alexquilty/SmartSpin2k/Hardware/Case Integrated PCB/README.md

Currently the experimental hardware for use with the upcoming PCB.
