alexquilty/SmartSpin2k/Hardware/PCB/README.md

PCB files. 

You'll only need these files if you want to customize the PCB or fab it someplace other than pcbway. 

To order directly from PCBway use this link : https://www.pcbway.com/project/shareproject/SmartSpin2k_PCB.html
