alexquilty/SmartSpin2k/Hardware/Case Version2/PrusaSlicer.png

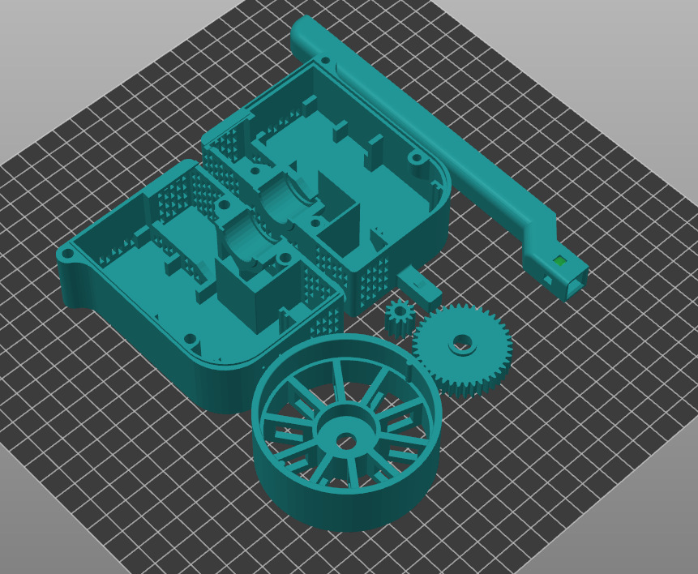
Hardware/Case Version2/PrusaSlicer.png
