alexquilty/SmartSpin2k/Hardware/Inserts/Design_Reference_Photos/BH_Fitness/BH-Fitness_Side_View.jpg

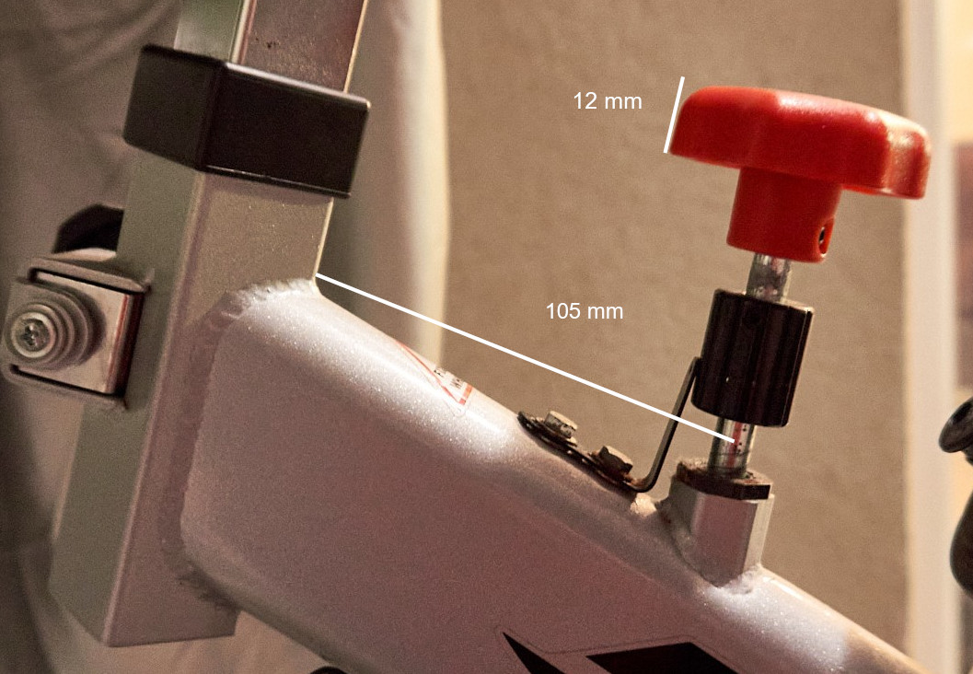
Hardware/Inserts/Design_Reference_Photos/BH_Fitness/BH-Fitness_Side_View.jpg
