alexquilty/SmartSpin2k/Hardware/Inserts/Design_Reference_Photos/BH_Fitness/BH-Fitness_Top_View.jpg

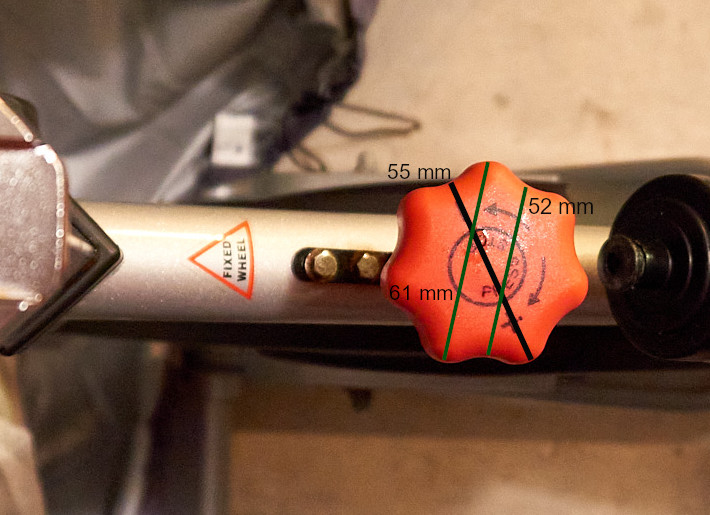
Hardware/Inserts/Design_Reference_Photos/BH_Fitness/BH-Fitness_Top_View.jpg
