alexquilty/SmartSpin2k/Hardware/Inserts/Design_Reference_Photos/Body_Bike/Side_3.jpg

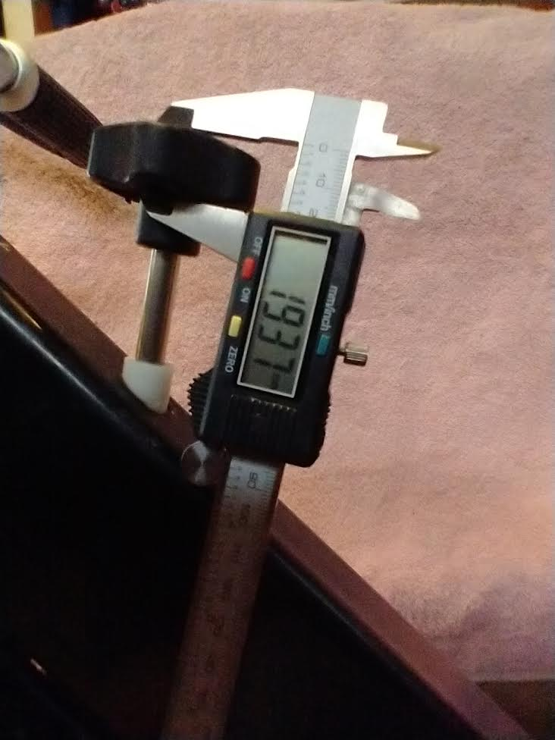
Hardware/Inserts/Design_Reference_Photos/Body_Bike/Side_3.jpg
