alexquilty/SmartSpin2k/Hardware/Inserts/Design_Reference_Photos/Body_Bike/Top.jpg

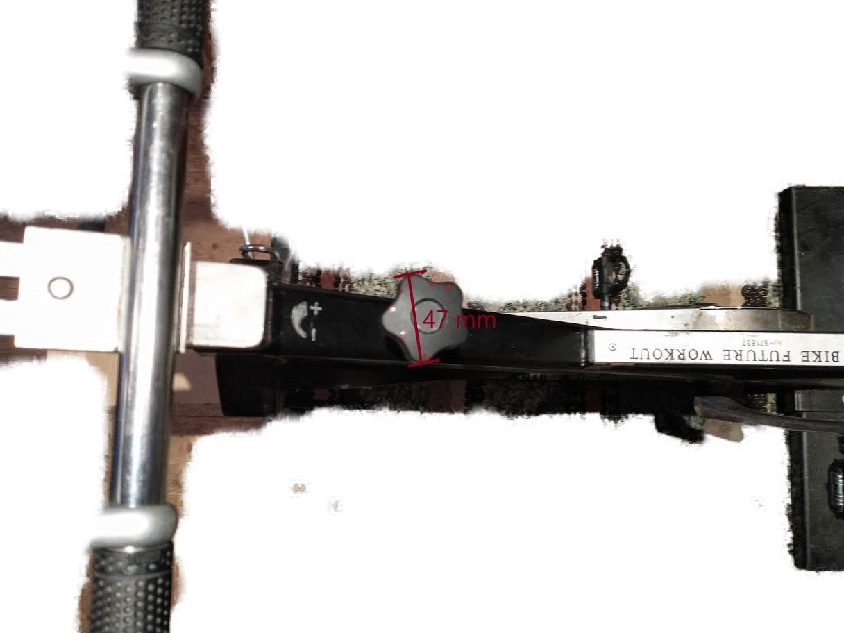
Hardware/Inserts/Design_Reference_Photos/Body_Bike/Top.jpg
