alexquilty/SmartSpin2k/Hardware/Inserts/Design_Reference_Photos/Body_Bike/Top_2.jpg

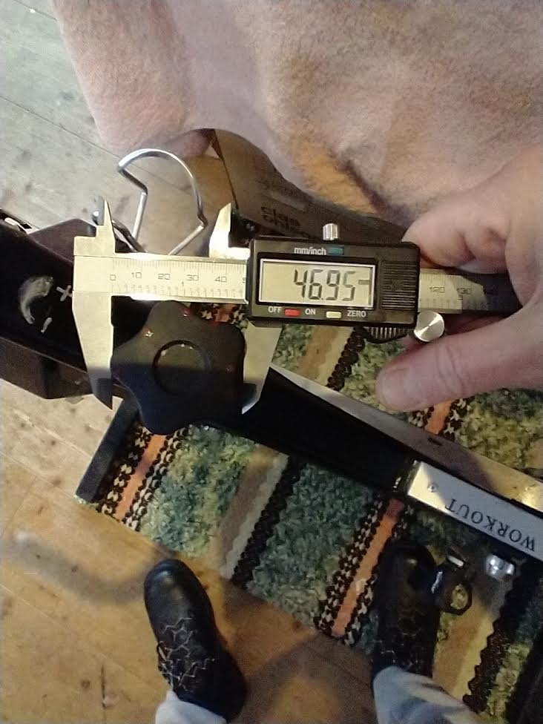
Hardware/Inserts/Design_Reference_Photos/Body_Bike/Top_2.jpg
