alexquilty/SmartSpin2k/Hardware/Inserts/Design_Reference_Photos/Diadora/head_tube.jpg

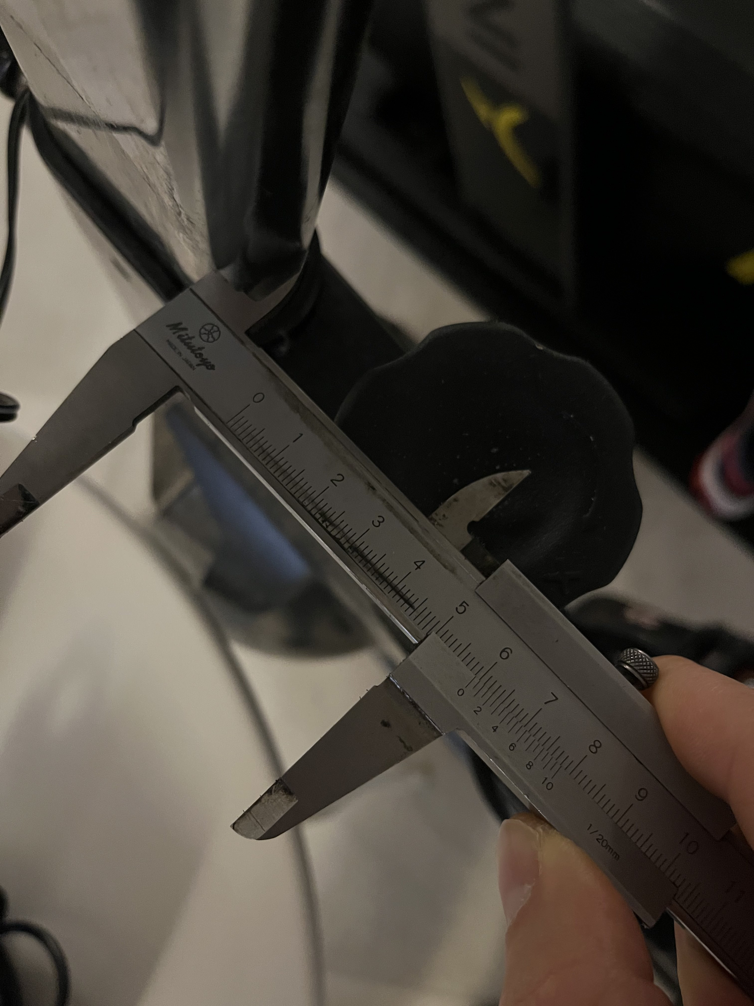
Hardware/Inserts/Design_Reference_Photos/Diadora/head_tube.jpg
