alexquilty/SmartSpin2k/Hardware/Inserts/Design_Reference_Photos/Diadora/Side.jpg

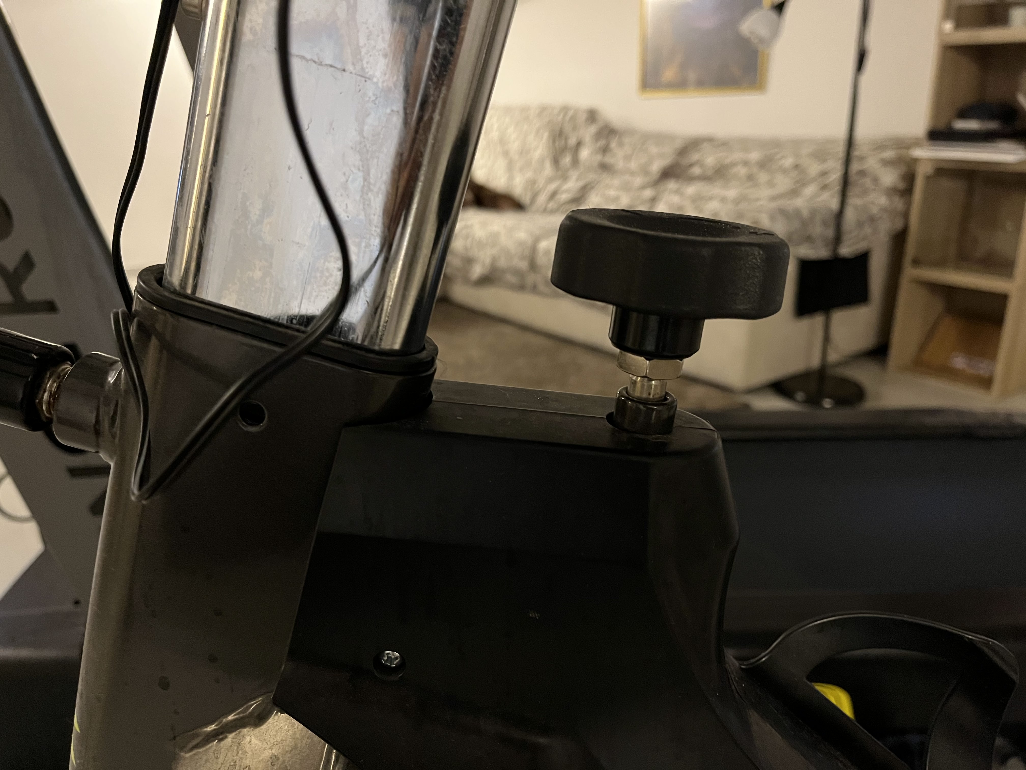
Hardware/Inserts/Design_Reference_Photos/Diadora/Side.jpg
