alexquilty/SmartSpin2k/Hardware/Inserts/Design_Reference_Photos/Diadora/Smallest.jpg

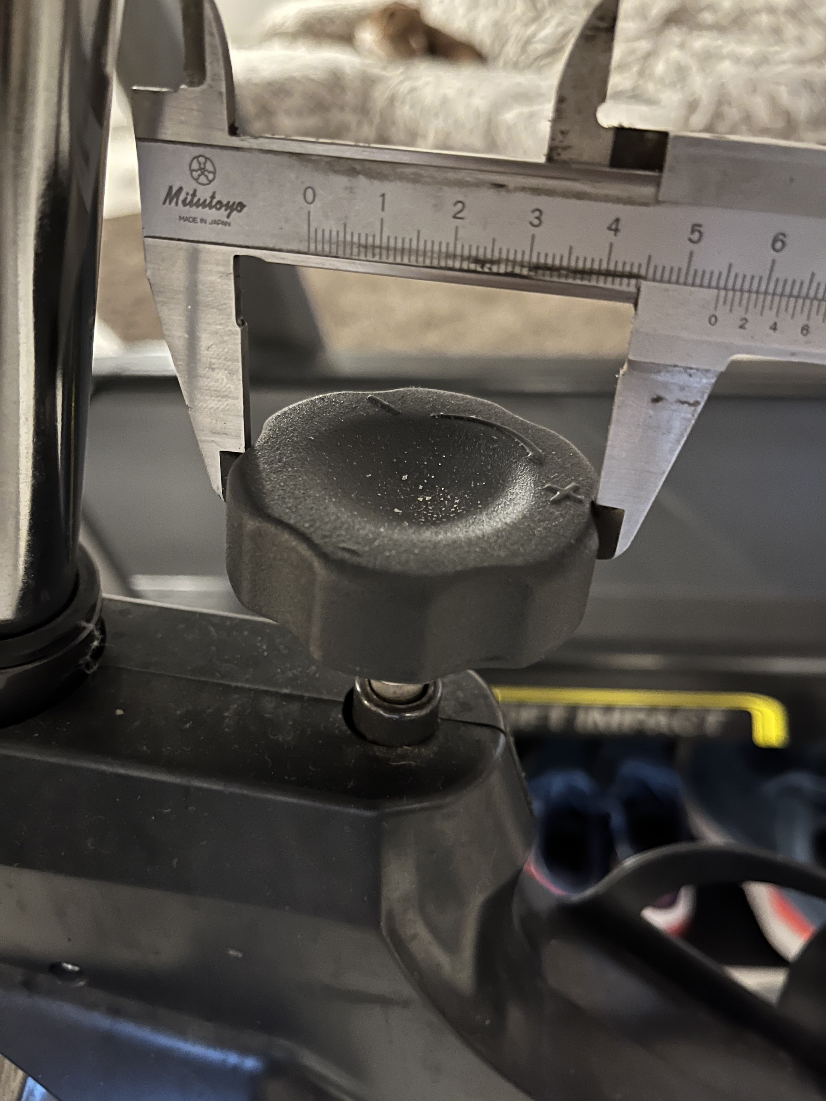
Hardware/Inserts/Design_Reference_Photos/Diadora/Smallest.jpg
