alexquilty/SmartSpin2k/Hardware/Inserts/Design_Reference_Photos/Diadora/Top.jpg

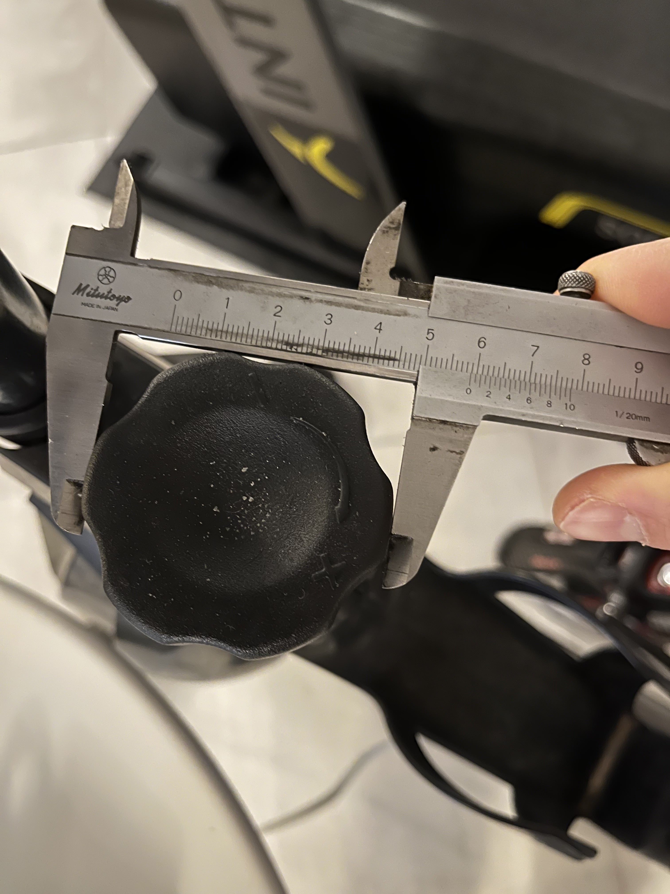
Hardware/Inserts/Design_Reference_Photos/Diadora/Top.jpg
