alexquilty/SmartSpin2k/Hardware/Inserts/Design_Reference_Photos/Echelon/Side1.jpg

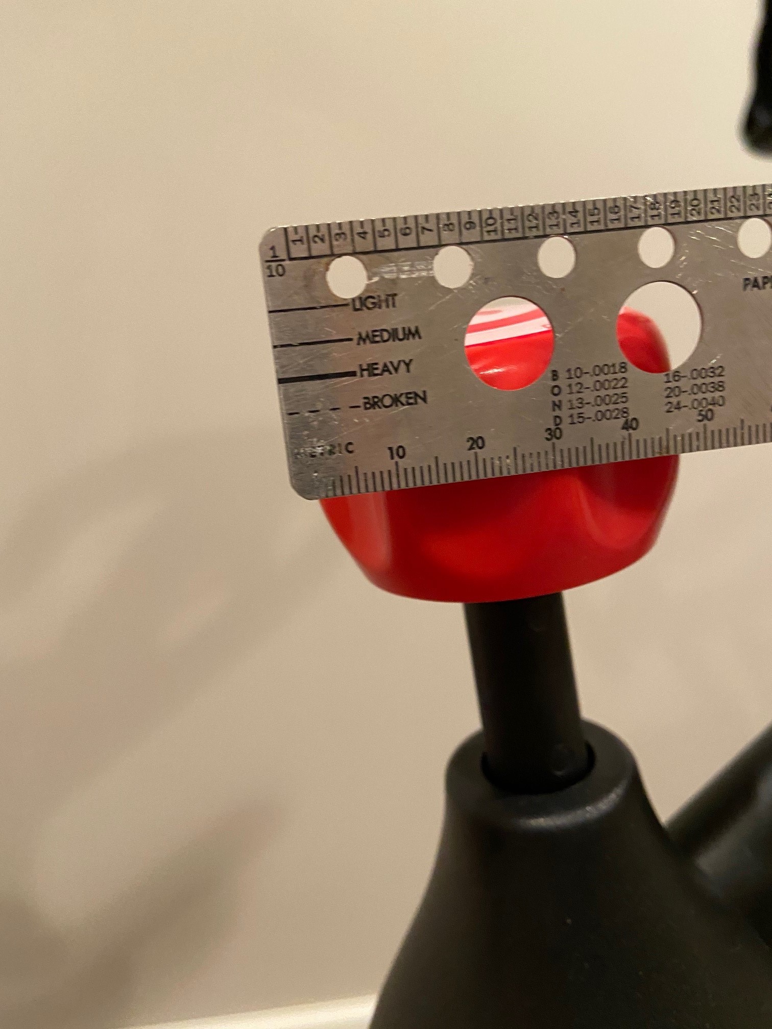
Hardware/Inserts/Design_Reference_Photos/Echelon/Side1.jpg
