alexquilty/SmartSpin2k/Hardware/Inserts/Design_Reference_Photos/Echelon/Side2.jpg

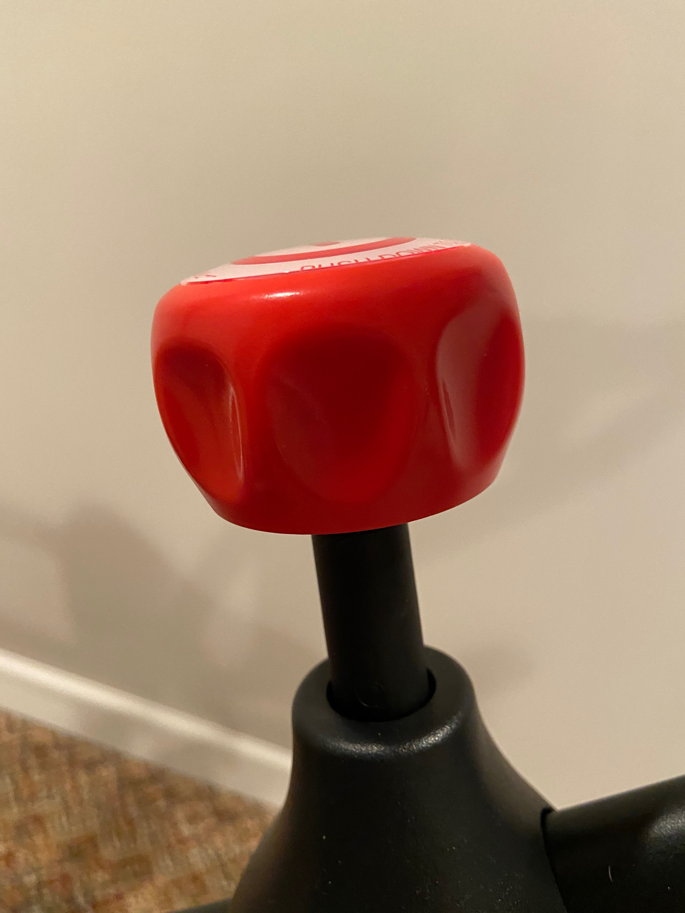
Hardware/Inserts/Design_Reference_Photos/Echelon/Side2.jpg
