alexquilty/SmartSpin2k/Hardware/Inserts/Design_Reference_Photos/Echelon/side3.jpg

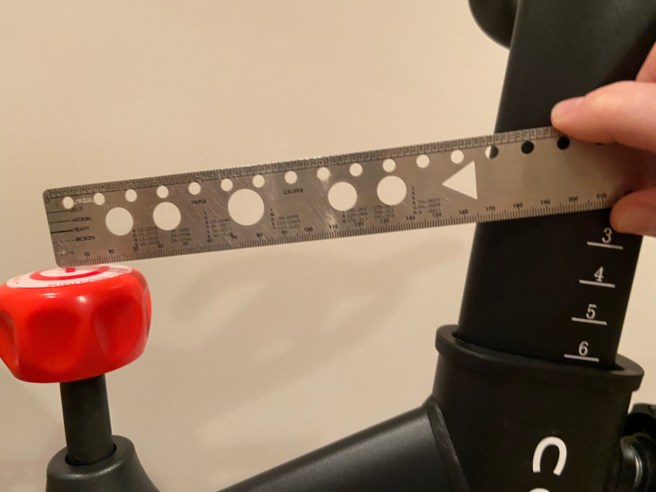
Hardware/Inserts/Design_Reference_Photos/Echelon/side3.jpg
