alexquilty/SmartSpin2k/Hardware/Inserts/Design_Reference_Photos/Echelon/side4.jpg

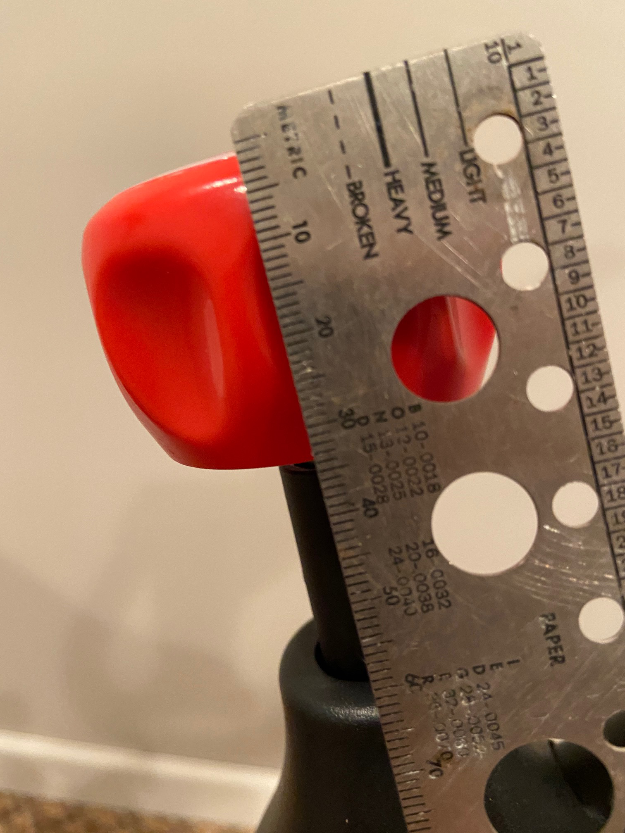
Hardware/Inserts/Design_Reference_Photos/Echelon/side4.jpg
