alexquilty/SmartSpin2k/Hardware/Inserts/Design_Reference_Photos/Echelon/top1.jpg

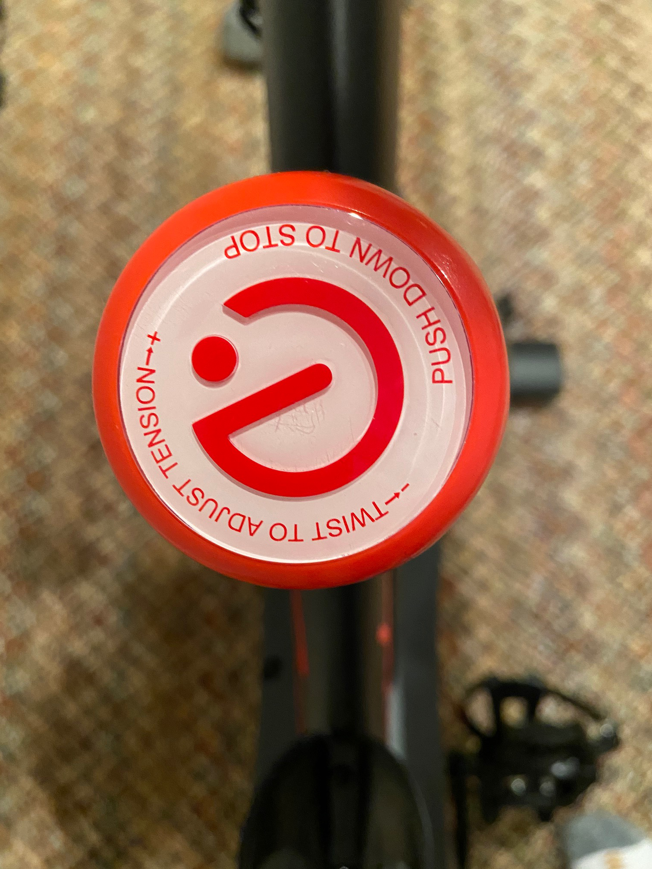
Hardware/Inserts/Design_Reference_Photos/Echelon/top1.jpg
