alexquilty/SmartSpin2k/Hardware/Inserts/Design_Reference_Photos/Echelon/top2.jpg

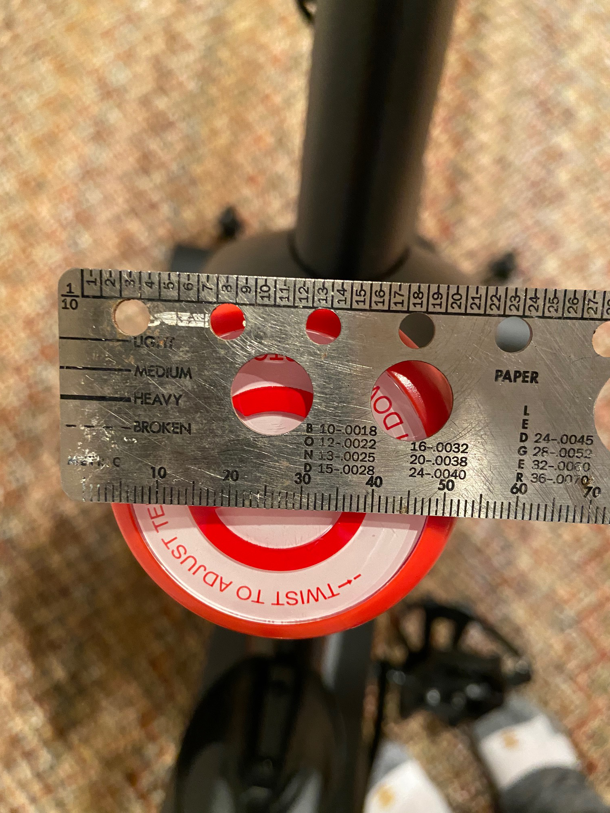
Hardware/Inserts/Design_Reference_Photos/Echelon/top2.jpg
