alexquilty/SmartSpin2k/Hardware/Inserts/Design_Reference_Photos/Flywheel/IMG_4019.JPG

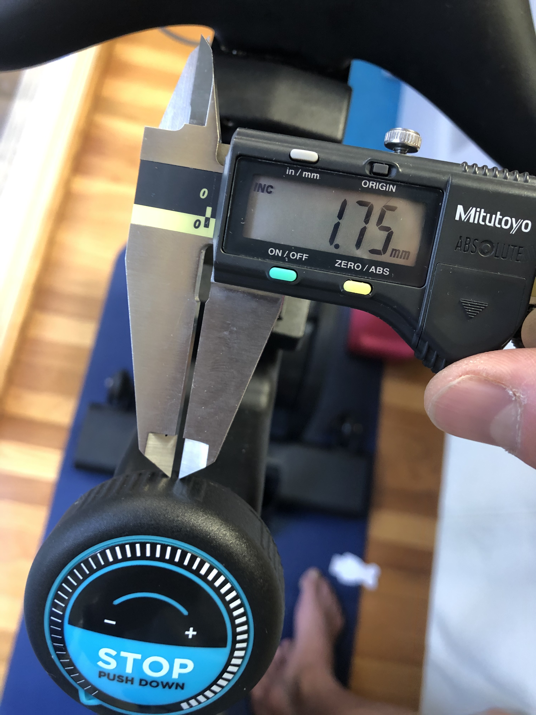
Hardware/Inserts/Design_Reference_Photos/Flywheel/IMG_4019.JPG
