alexquilty/SmartSpin2k/Hardware/Inserts/Design_Reference_Photos/Flywheel/IMG_4024.JPG

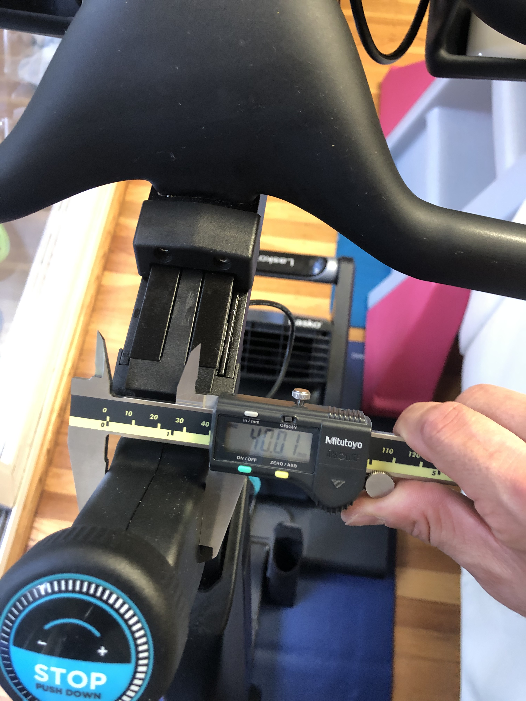
Hardware/Inserts/Design_Reference_Photos/Flywheel/IMG_4024.JPG
