alexquilty/SmartSpin2k/Hardware/Inserts/Design_Reference_Photos/Flywheel/IMG_4025.JPG

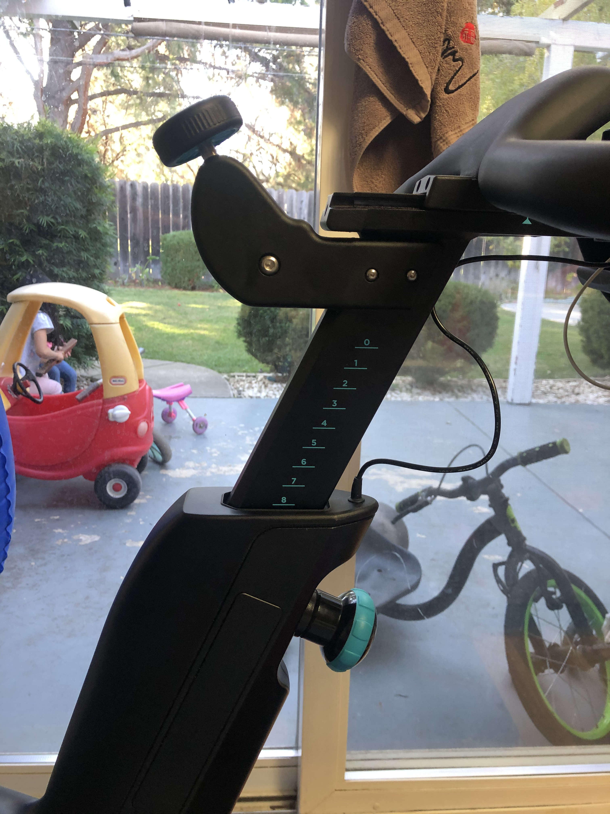
Hardware/Inserts/Design_Reference_Photos/Flywheel/IMG_4025.JPG
