alexquilty/SmartSpin2k/Hardware/Inserts/Design_Reference_Photos/Golds_Gym/Golds-Gym_all_views.jpg

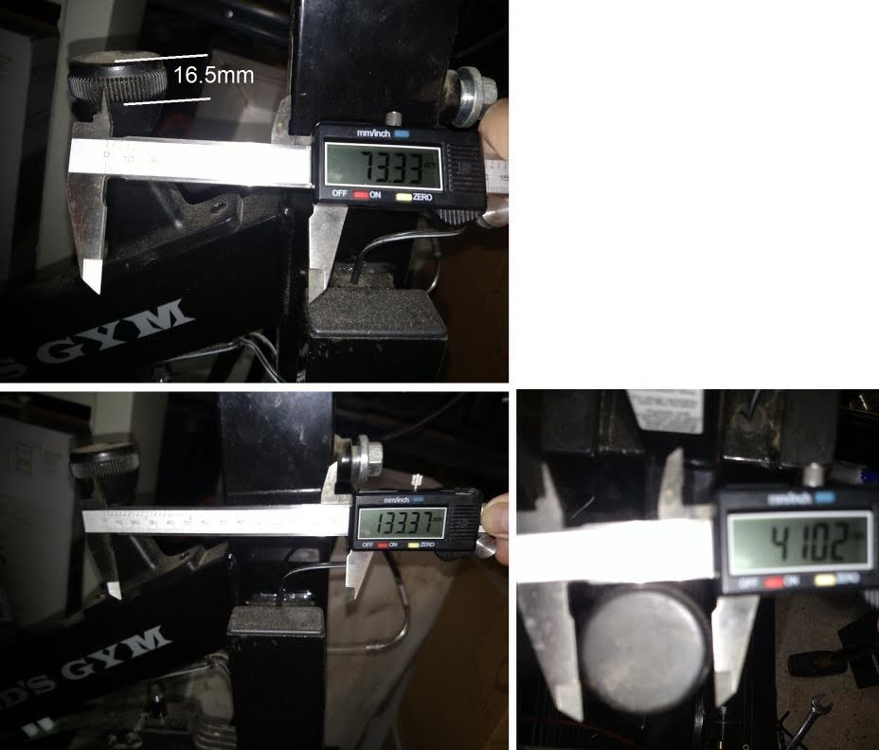
Hardware/Inserts/Design_Reference_Photos/Golds_Gym/Golds-Gym_all_views.jpg
