alexquilty/SmartSpin2k/Hardware/Inserts/Design_Reference_Photos/HMC/HMC-top-view-inner-diameter.jpg

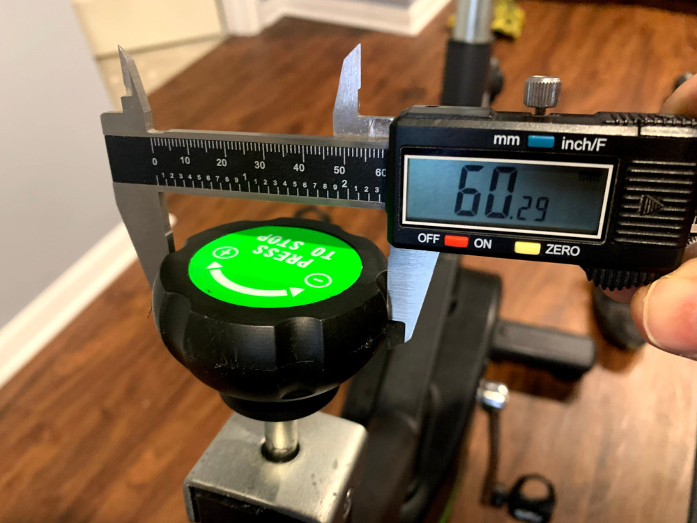
Hardware/Inserts/Design_Reference_Photos/HMC/HMC-top-view-inner-diameter.jpg
