alexquilty/SmartSpin2k/Hardware/Inserts/Design_Reference_Photos/HMC/HMC_side_view_knob_distance.jpg

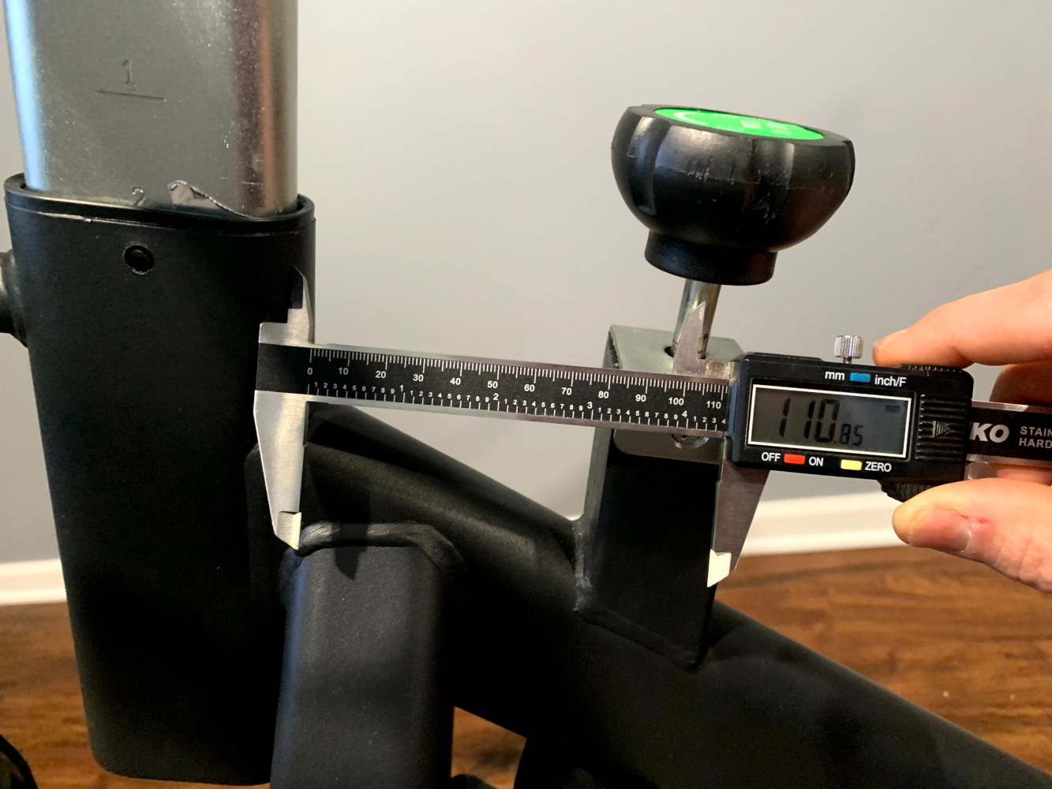
Hardware/Inserts/Design_Reference_Photos/HMC/HMC_side_view_knob_distance.jpg
