alexquilty/SmartSpin2k/Hardware/Inserts/Design_Reference_Photos/HMC/HMC_top_view.jpg

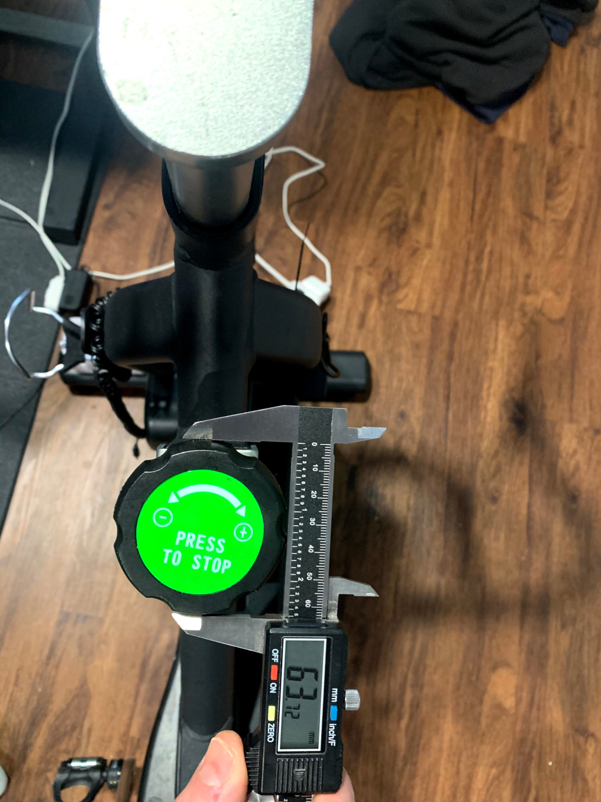
Hardware/Inserts/Design_Reference_Photos/HMC/HMC_top_view.jpg
