alexquilty/SmartSpin2k/Hardware/Inserts/Design_Reference_Photos/Irotec/Irotec-RS220_Knob_Side_View.jpg

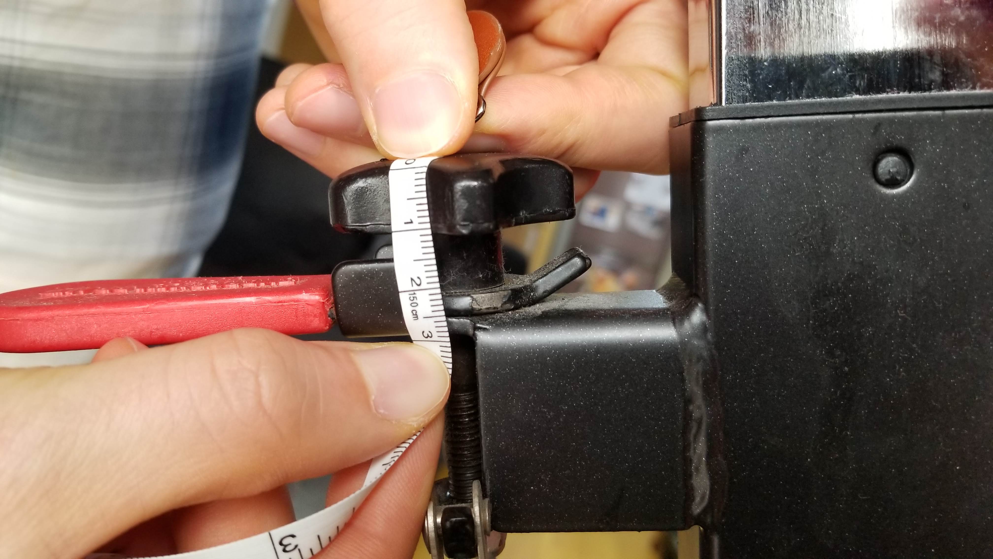
Hardware/Inserts/Design_Reference_Photos/Irotec/Irotec-RS220_Knob_Side_View.jpg
