alexquilty/SmartSpin2k/Hardware/Inserts/Design_Reference_Photos/Irotec/Irotec-RS220_Knob_Top_View.jpg

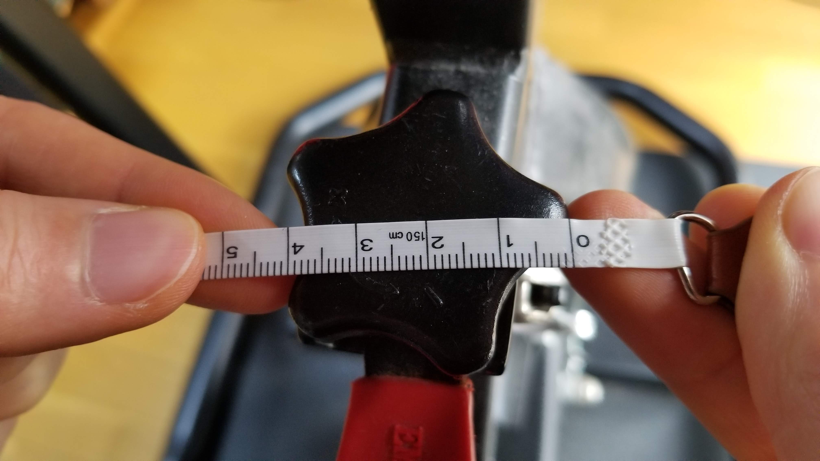
Hardware/Inserts/Design_Reference_Photos/Irotec/Irotec-RS220_Knob_Top_View.jpg
