alexquilty/SmartSpin2k/Hardware/Inserts/Design_Reference_Photos/Irotec/Irotec-RS220_Side_View_Headtube.jpg

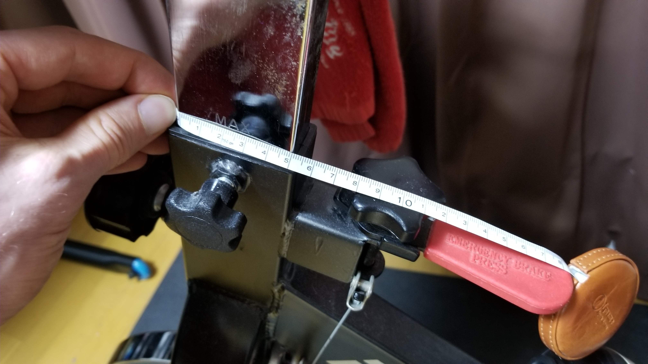
Hardware/Inserts/Design_Reference_Photos/Irotec/Irotec-RS220_Side_View_Headtube.jpg
