alexquilty/SmartSpin2k/Hardware/Inserts/Design_Reference_Photos/Irotec/Irotec-RS220_Top_View_Headtube.jpg

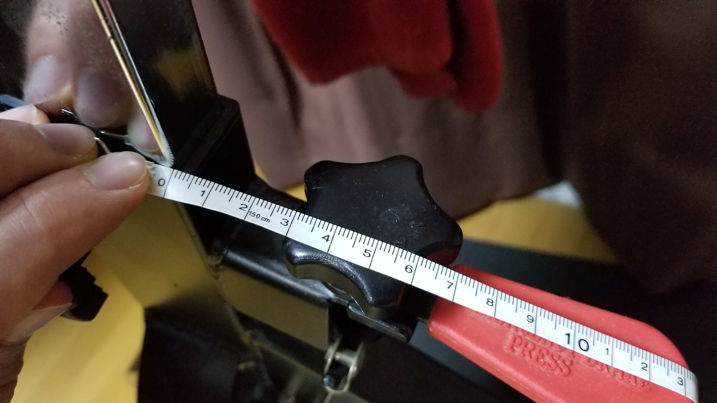
Hardware/Inserts/Design_Reference_Photos/Irotec/Irotec-RS220_Top_View_Headtube.jpg
