alexquilty/SmartSpin2k/Hardware/Inserts/Design_Reference_Photos/Joroto/Joroto X2 Side.jpg

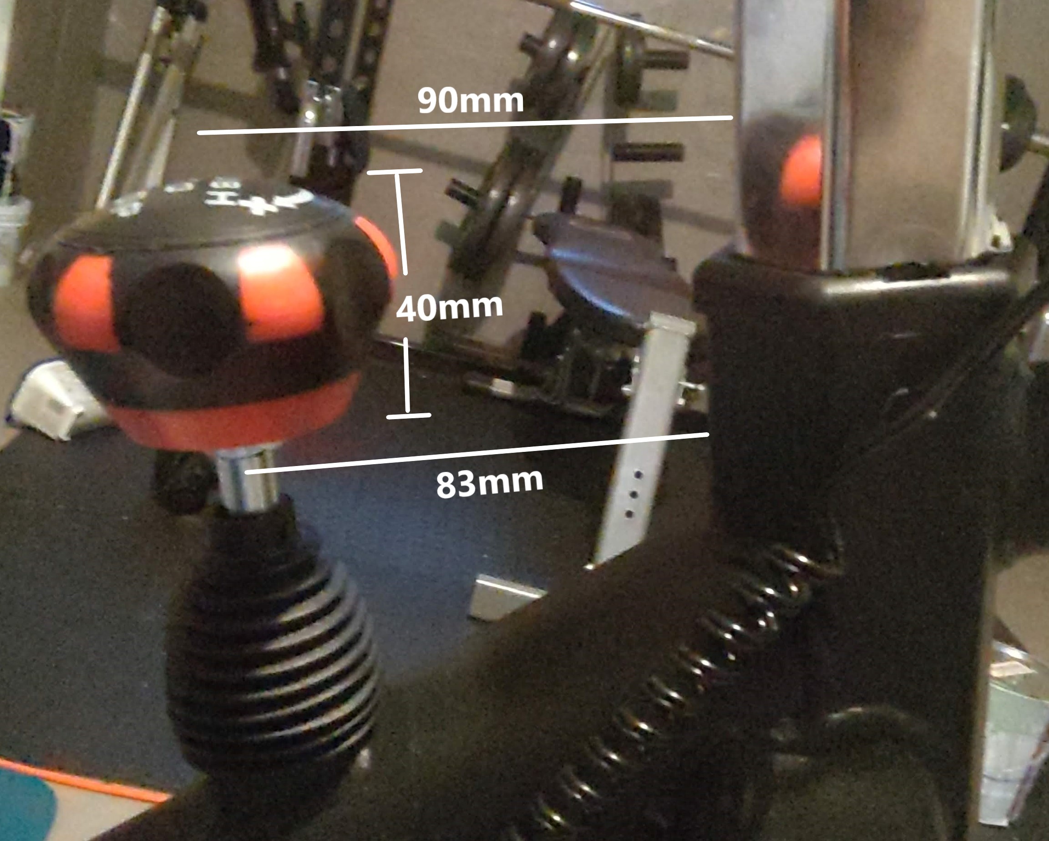
Hardware/Inserts/Design_Reference_Photos/Joroto/Joroto X2 Side.jpg
