alexquilty/SmartSpin2k/Hardware/Inserts/Design_Reference_Photos/Joroto/Joroto X2 Top.jpg

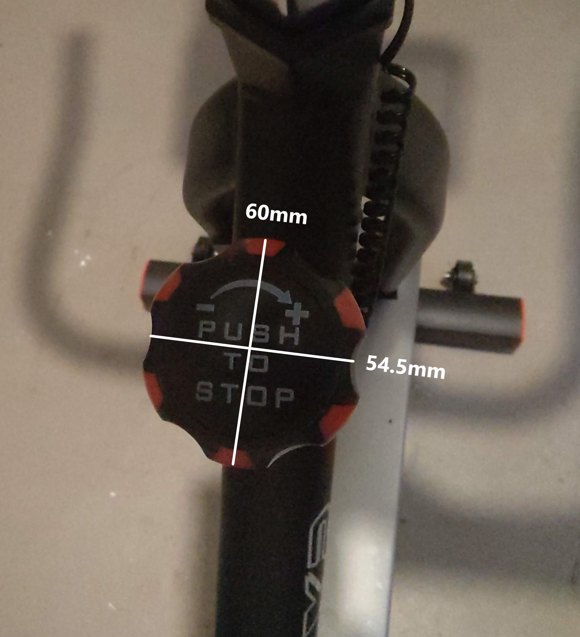
Hardware/Inserts/Design_Reference_Photos/Joroto/Joroto X2 Top.jpg
