alexquilty/SmartSpin2k/Hardware/Inserts/Design_Reference_Photos/Revmaster/Revmaster-Spin_Side_View.jpg

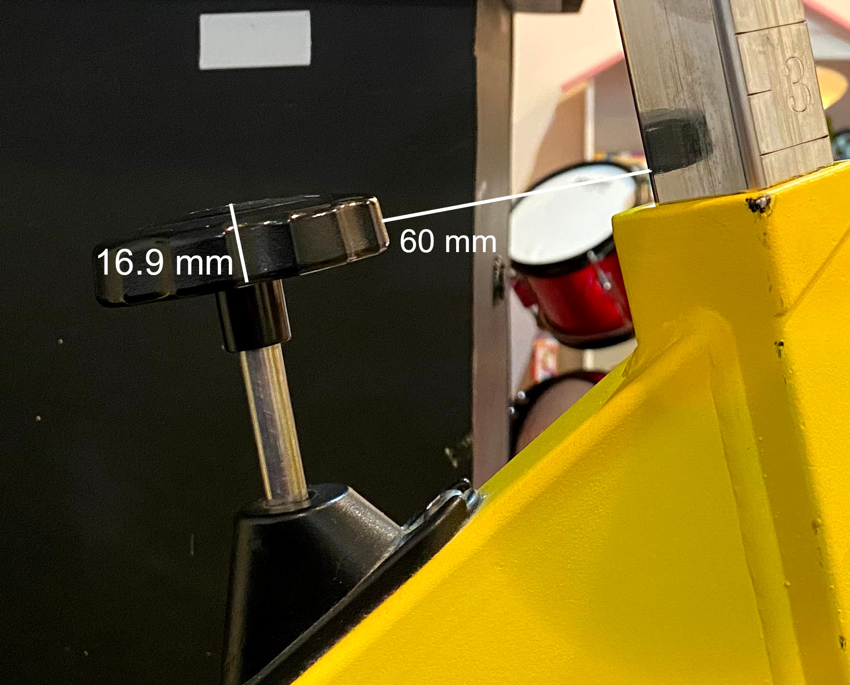
Hardware/Inserts/Design_Reference_Photos/Revmaster/Revmaster-Spin_Side_View.jpg
