alexquilty/SmartSpin2k/Hardware/Inserts/Design_Reference_Photos/Revmaster/Revmaster-Spin_Top_View_caliper.jpg

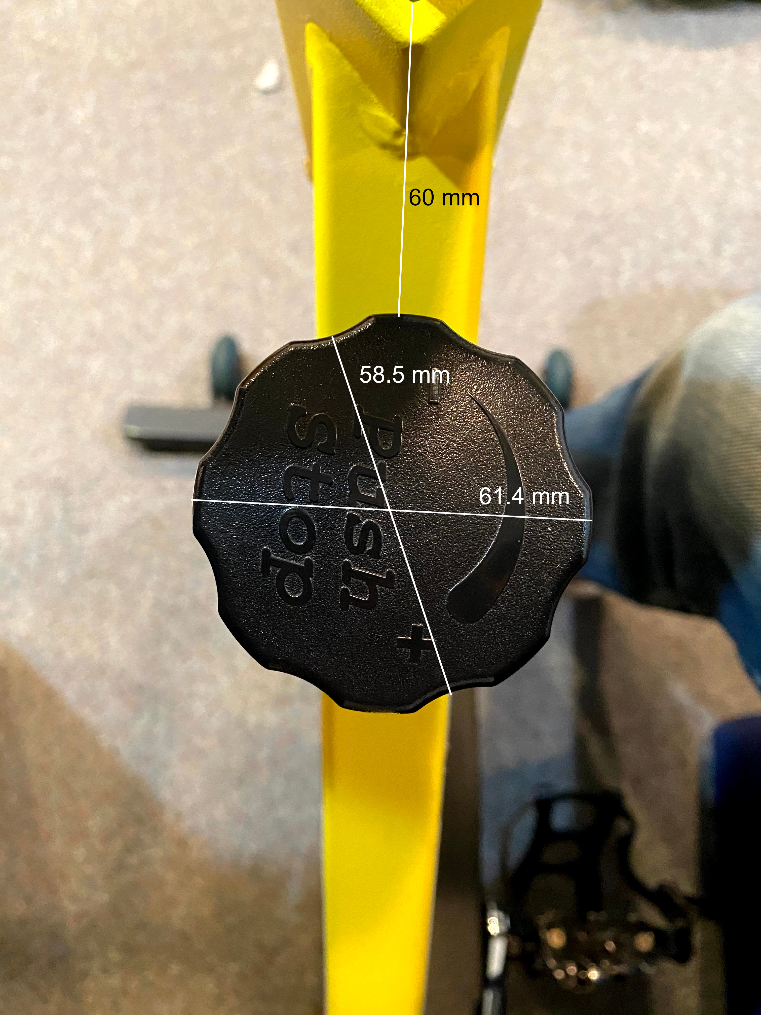
Hardware/Inserts/Design_Reference_Photos/Revmaster/Revmaster-Spin_Top_View_caliper.jpg
