alexquilty/SmartSpin2k/Hardware/Inserts/Design_Reference_Photos/Schwinn/Schwinn_IC4_Top.jpeg

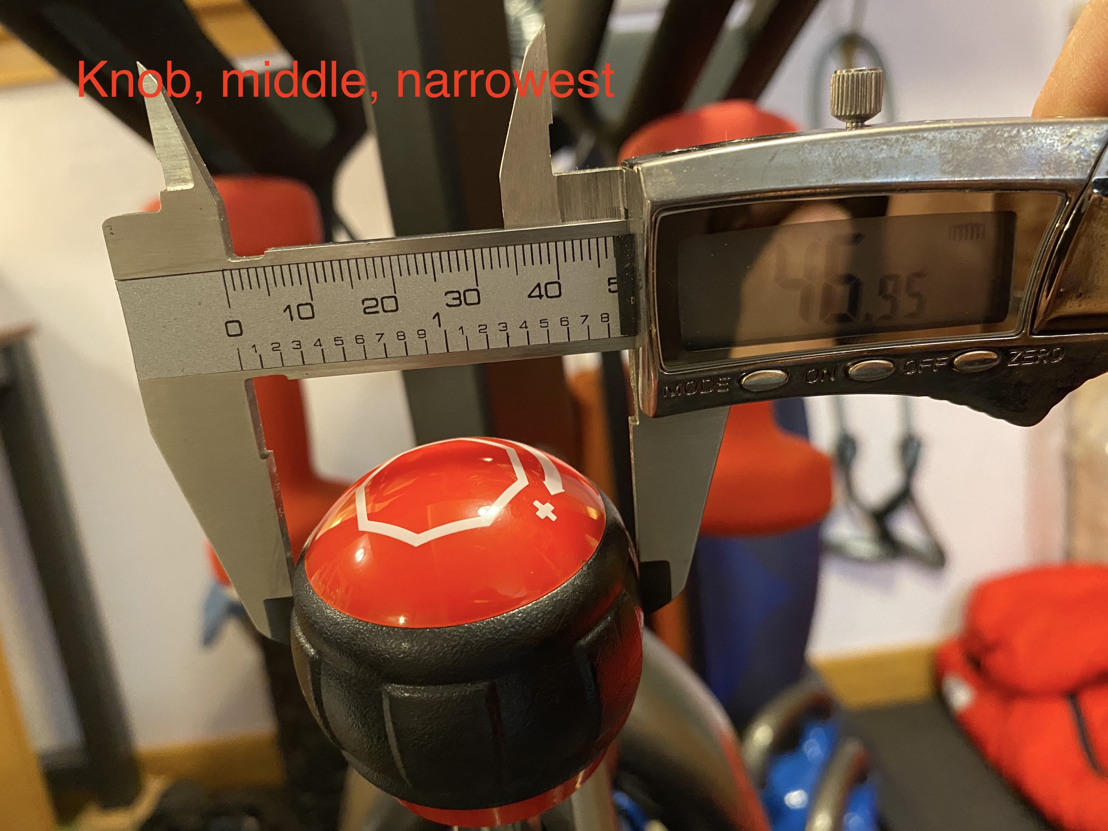
Hardware/Inserts/Design_Reference_Photos/Schwinn/Schwinn_IC4_Top.jpeg
