alexquilty/SmartSpin2k/Hardware/Inserts/Design_Reference_Photos/Vortec/Vortec_Knob_side.jpg

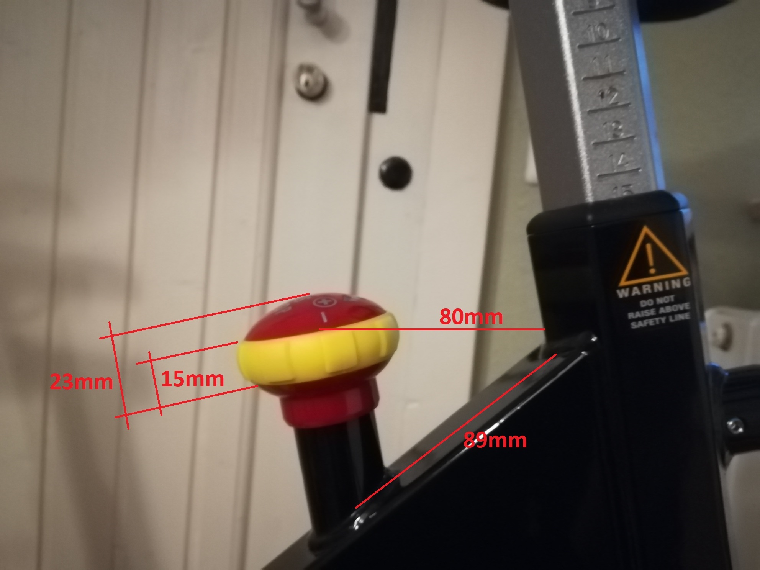
Hardware/Inserts/Design_Reference_Photos/Vortec/Vortec_Knob_side.jpg
