alexquilty/SmartSpin2k/Hardware/Inserts/Design_Reference_Photos/Vortec/Vortec_Knob_top.jpg

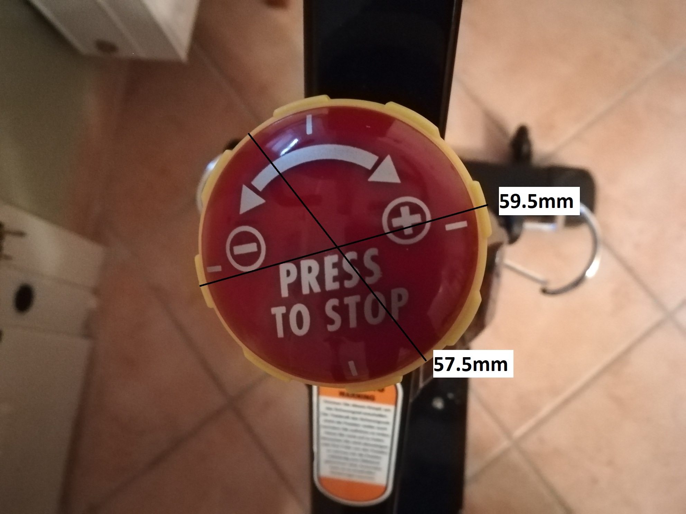
Hardware/Inserts/Design_Reference_Photos/Vortec/Vortec_Knob_top.jpg
