alexquilty/SmartSpin2k/Hardware/MODS/Direct Mount Mod/Bike Mount/reference photos/Echelon Sport Connect/Design_Reference_Photos/Downtube/269926087_659207275430661_2228753051904856695_n.png

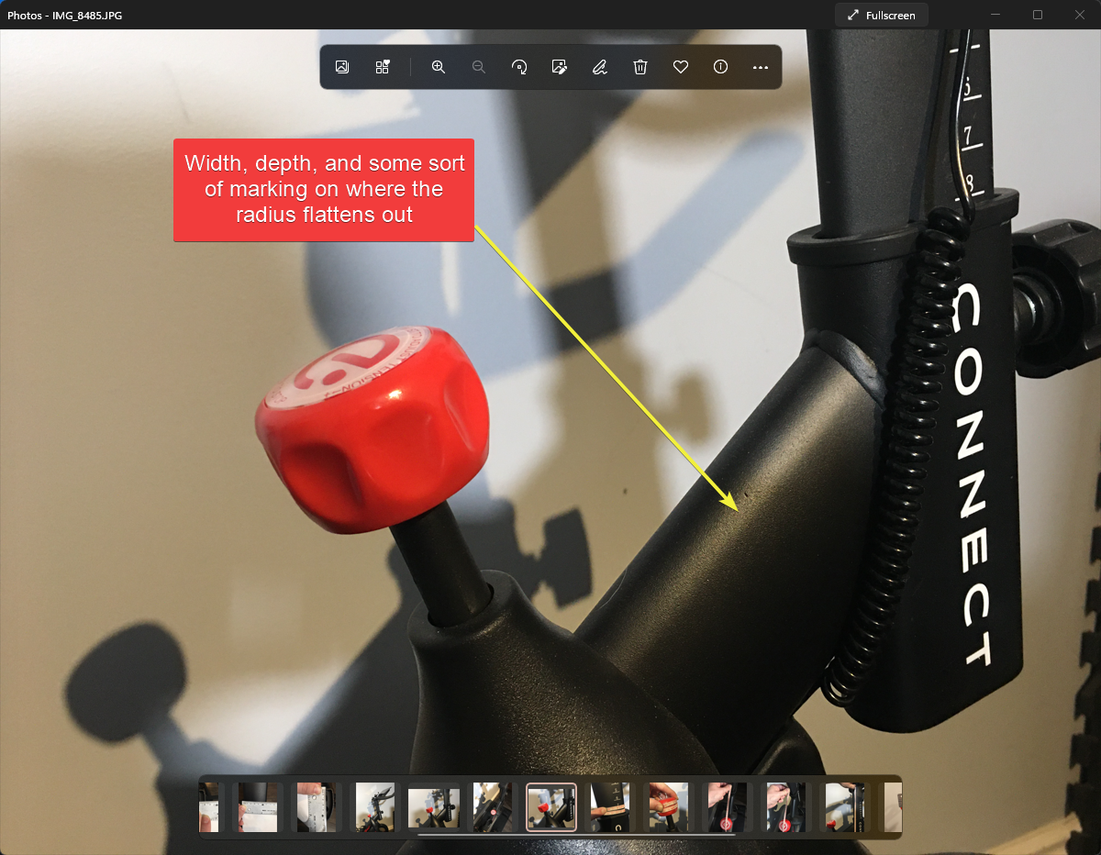
Hardware/MODS/Direct Mount Mod/Bike Mount/reference photos/Echelon Sport Connect/Design_Reference_Photos/Downtube/269926087_659207275430661_2228753051904856695_n.png
