alexquilty/SmartSpin2k/Hardware/MODS/Direct Mount Mod/Bike Mount/reference photos/Echelon Sport Connect/Design_Reference_Photos/Downtube/271928582_665581714879386_3625823250238532367_n.jpg

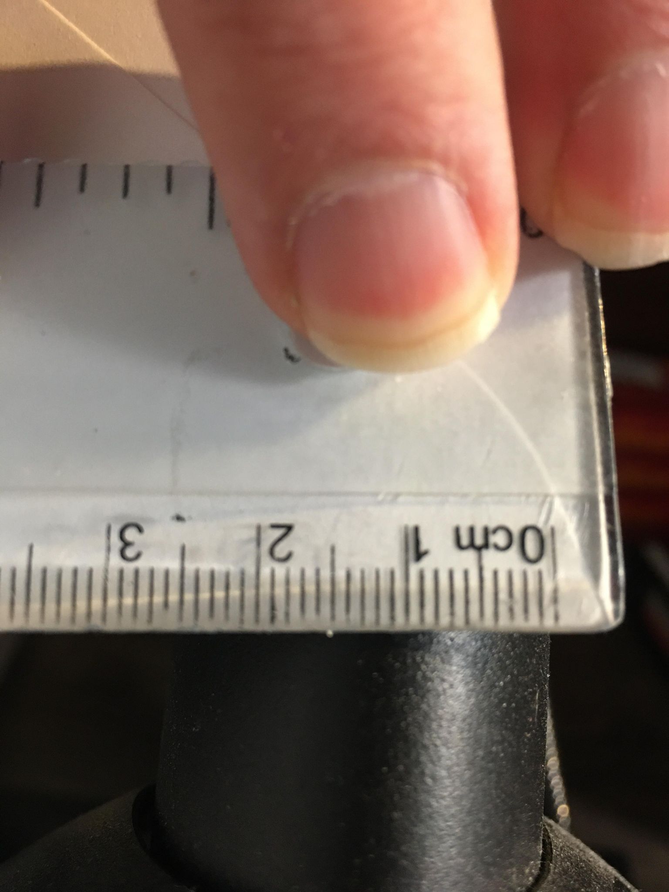
Hardware/MODS/Direct Mount Mod/Bike Mount/reference photos/Echelon Sport Connect/Design_Reference_Photos/Downtube/271928582_665581714879386_3625823250238532367_n.jpg
