alexquilty/SmartSpin2k/Hardware/MODS/Direct Mount Mod/Bike Mount/reference photos/Echelon Sport Connect/Design_Reference_Photos/Downtube/271949787_2279111352228269_6570604266901612947_n.jpg

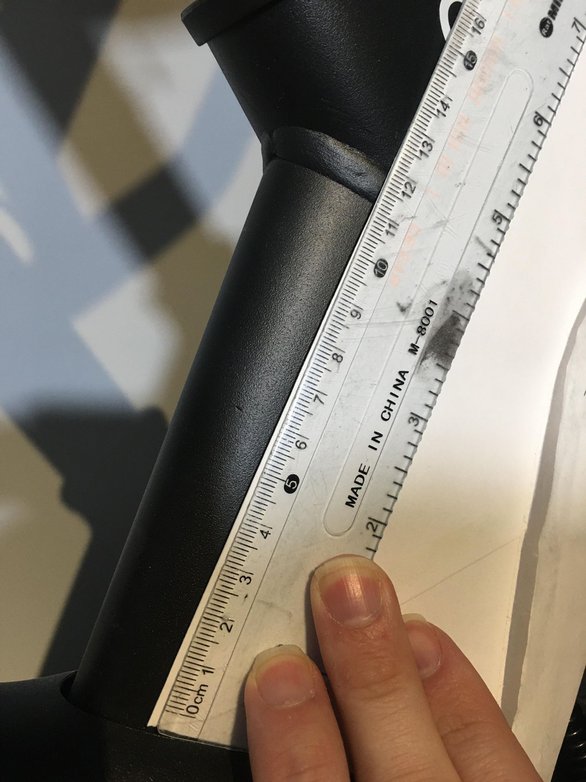
Hardware/MODS/Direct Mount Mod/Bike Mount/reference photos/Echelon Sport Connect/Design_Reference_Photos/Downtube/271949787_2279111352228269_6570604266901612947_n.jpg
