alexquilty/SmartSpin2k/Hardware/MODS/Direct Mount Mod/Bike Mount/reference photos/Echelon Sport Connect/Design_Reference_Photos/Downtube/271985523_937294317178002_7899393892700640915_n.jpg

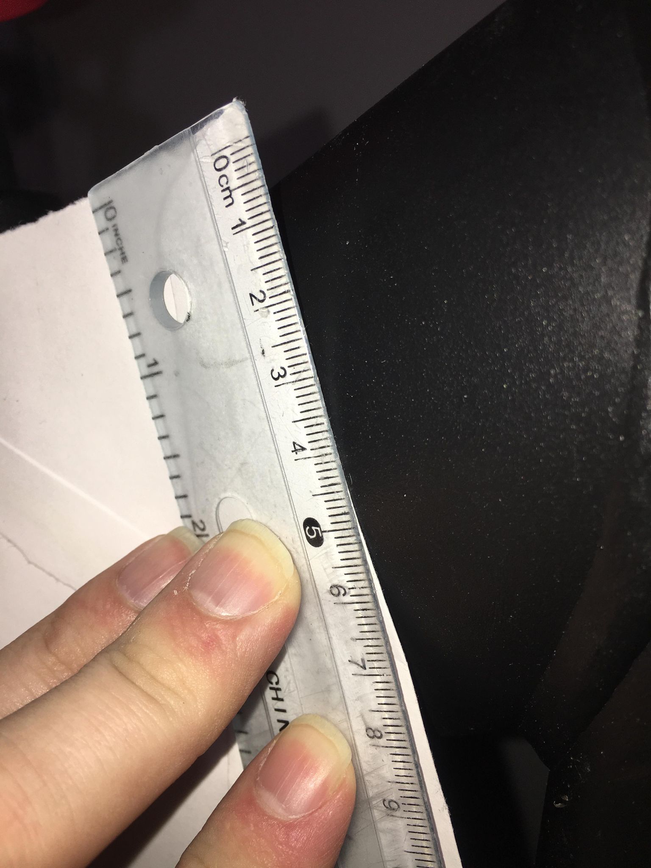
Hardware/MODS/Direct Mount Mod/Bike Mount/reference photos/Echelon Sport Connect/Design_Reference_Photos/Downtube/271985523_937294317178002_7899393892700640915_n.jpg
