alexquilty/SmartSpin2k/Hardware/MODS/Direct Mount Mod/Bike Mount/reference photos/Echelon Sport Connect/Design_Reference_Photos/Downtube/272294418_1130995294369965_3614129495463006999_n.jpg

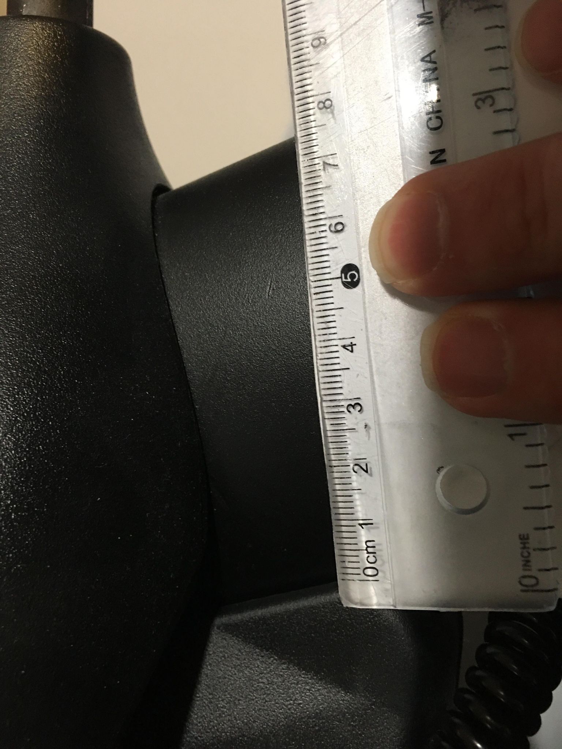
Hardware/MODS/Direct Mount Mod/Bike Mount/reference photos/Echelon Sport Connect/Design_Reference_Photos/Downtube/272294418_1130995294369965_3614129495463006999_n.jpg
