alexquilty/SmartSpin2k/Hardware/Shifters/bridging.png

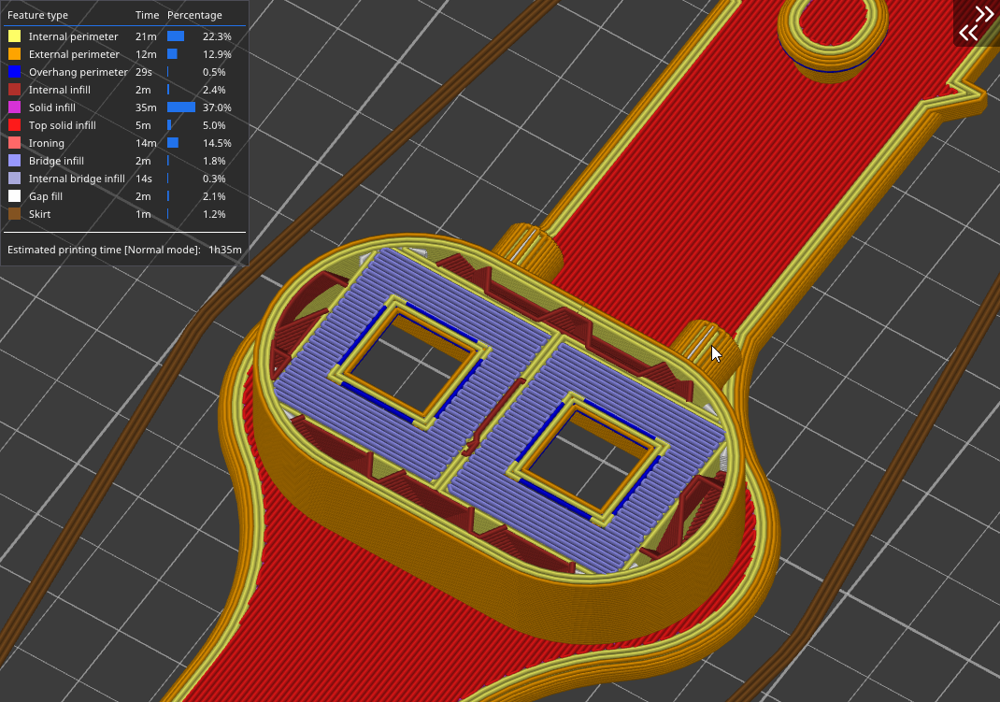
Hardware/Shifters/bridging.png
