alexquilty/SmartSpin2k/Pictures/5323680E-148E-4621-90CA-41B9B51CAFE7.jpeg

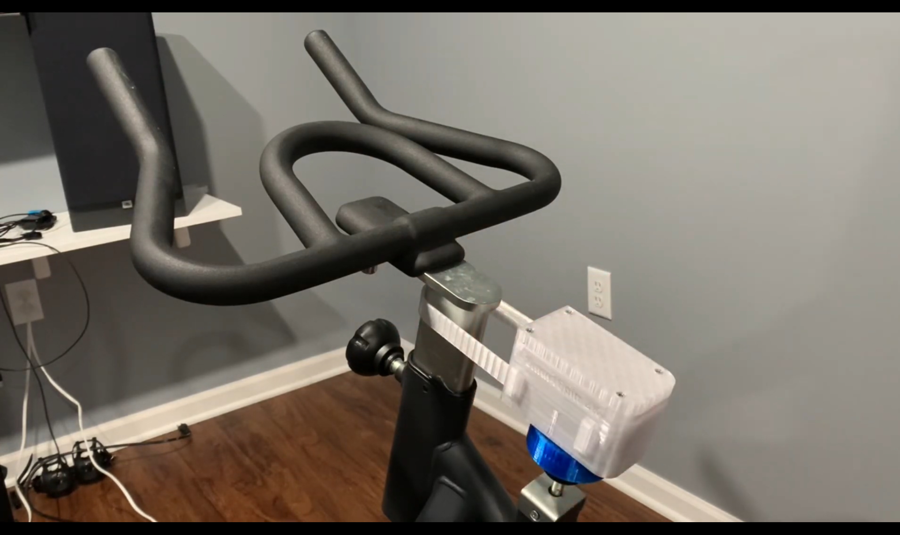
Pictures/5323680E-148E-4621-90CA-41B9B51CAFE7.jpeg
