alexquilty/SmartSpin2k/Hardware/Case Integrated PCB/Gears/CAD/40_Tooth_Mod1.SLDASM

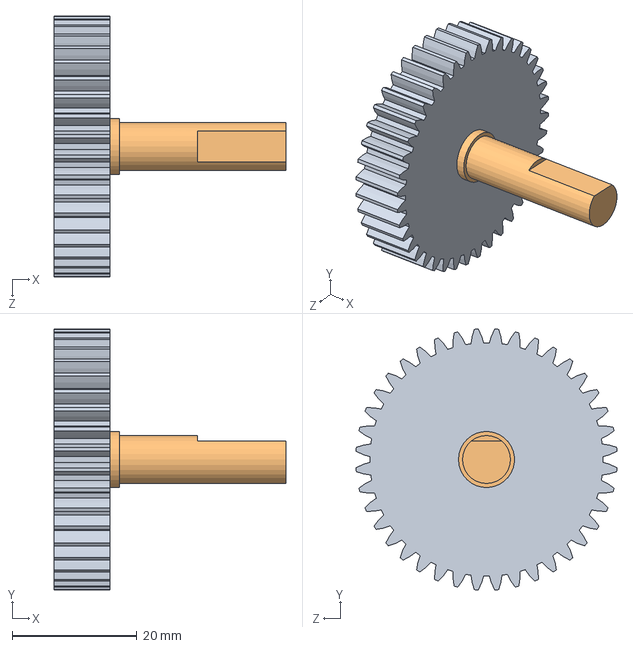
[picture p118: CAD file, 2022-12-04]
Hardware/Case Integrated PCB/Gears/CAD/40_Tooth_Mod1.SLDASM
37.2 x 41.9 x 41.9 mm
Metric - Spur gear 1M 40T 20PA 9FW ---S40N75H50L4N
Gear_Shaft
