alexquilty/SmartSpin2k/Hardware/Case Integrated PCB/Case/CAD/Connectors/3.5mmJack.SLDASM

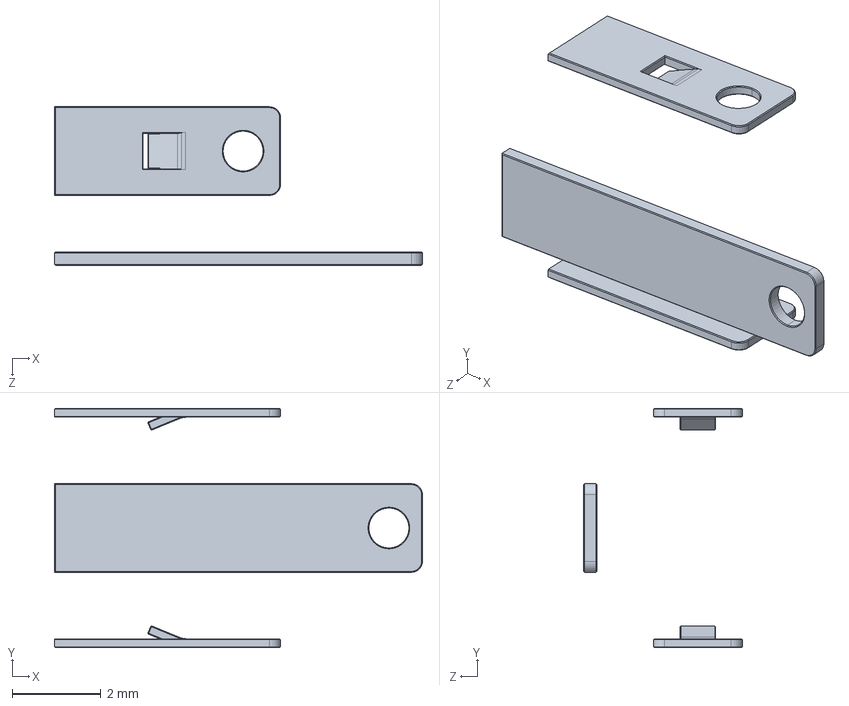
[picture p119: CAD file, 2022-12-04]
Hardware/Case Integrated PCB/Case/CAD/Connectors/3.5mmJack.SLDASM
8.30 x 5.40 x 3.58 mm
