alexquilty/SmartSpin2k/Hardware/Case Integrated PCB/Case/Body_Left.STL

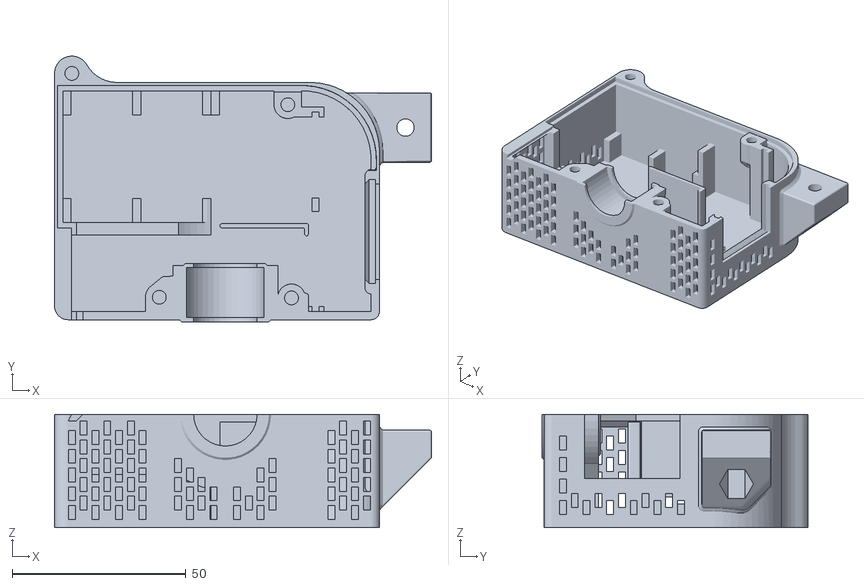
[picture p120: CAD file, 2022-12-04]
Hardware/Case Integrated PCB/Case/Body_Left.STL
108.7 x 76.6 x 32.7
