alexquilty/SmartSpin2k/Hardware/Case Integrated PCB/Case/CAD/Body_Drawing_Right.SLDPRT

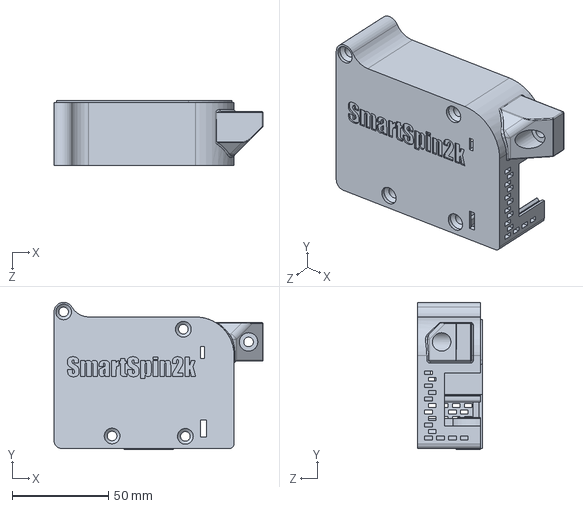
[picture p121: CAD file, 2022-12-04]
Hardware/Case Integrated PCB/Case/CAD/Body_Drawing_Right.SLDPRT
108.6 x 76.6 x 33.9 mm
