alexquilty/SmartSpin2k/Hardware/Case Integrated PCB/MountingStrap/CAD/Mounting_Strap_Short.STEP

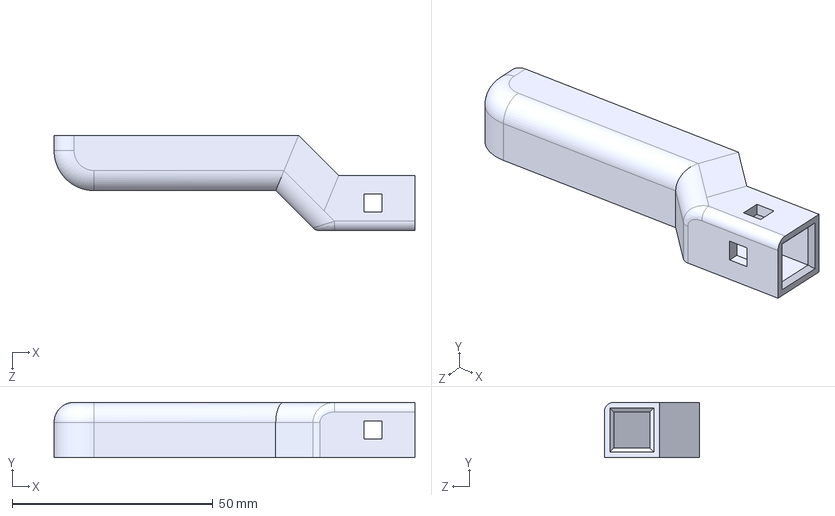
[picture p122: CAD file, 2022-12-04]
Hardware/Case Integrated PCB/MountingStrap/CAD/Mounting_Strap_Short.STEP
90.0 x 13.8 x 23.8 mm
