alexquilty/SmartSpin2k/Hardware/Case Integrated PCB/MountingStrap/Mounting_For_New_Case.STL

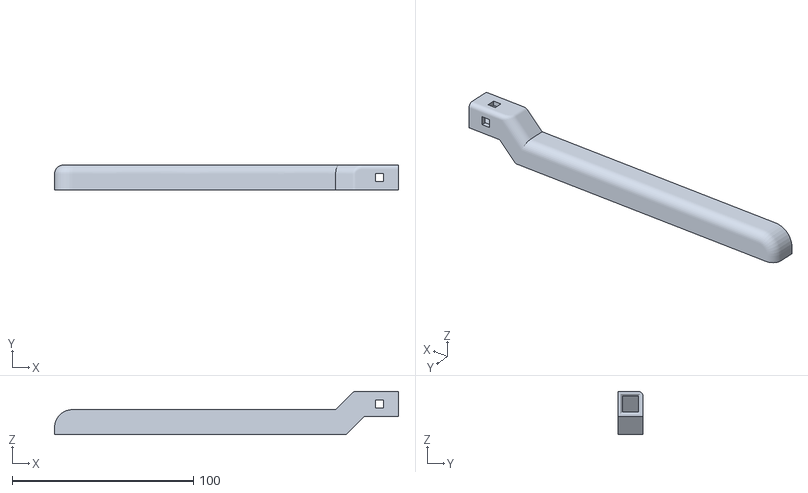
[picture p123: CAD file, 2022-12-04]
Hardware/Case Integrated PCB/MountingStrap/Mounting_For_New_Case.STL
190.0 x 13.8 x 23.8
