alexquilty/SmartSpin2k/Hardware/Case Version2/Case/Body_Left.STL

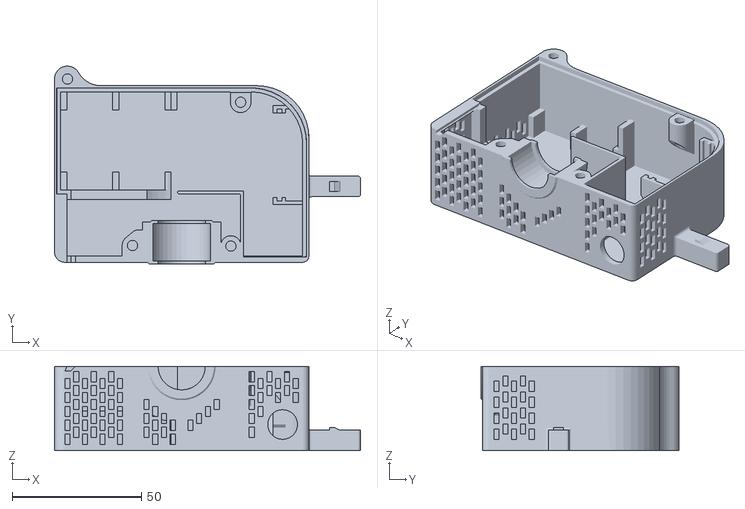
[picture p124: CAD file, 2022-12-04]
Hardware/Case Version2/Case/Body_Left.STL
118.5 x 76.6 x 32.7
