alexquilty/SmartSpin2k/Hardware/Case Version2/Case/CAD/Body_Drawing_Right.SLDPRT

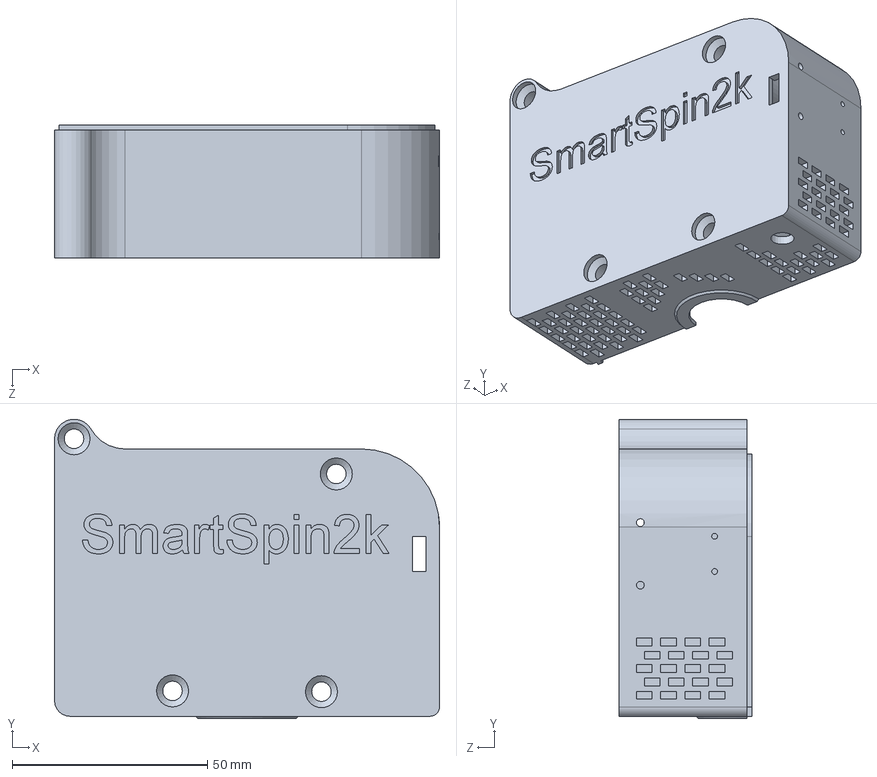
[picture p125: CAD file, 2022-12-04]
Hardware/Case Version2/Case/CAD/Body_Drawing_Right.SLDPRT
98.5 x 76.6 x 33.9 mm
