alexquilty/SmartSpin2k/Hardware/Case Version2/Gears/CAD/SS2K 40T Mod1 Spur Gear.STEP

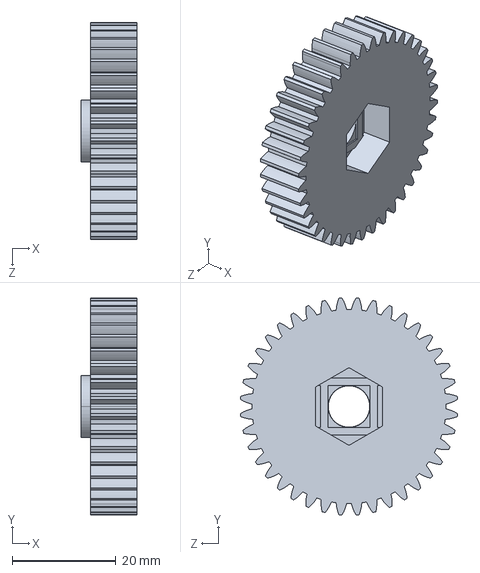
[picture p126: CAD file, 2022-12-04]
Hardware/Case Version2/Gears/CAD/SS2K 40T Mod1 Spur Gear.STEP
10.8 x 41.9 x 41.9 mm
