alexquilty/SmartSpin2k/Hardware/Case Version2/Mounting_For_New_Case.3mf

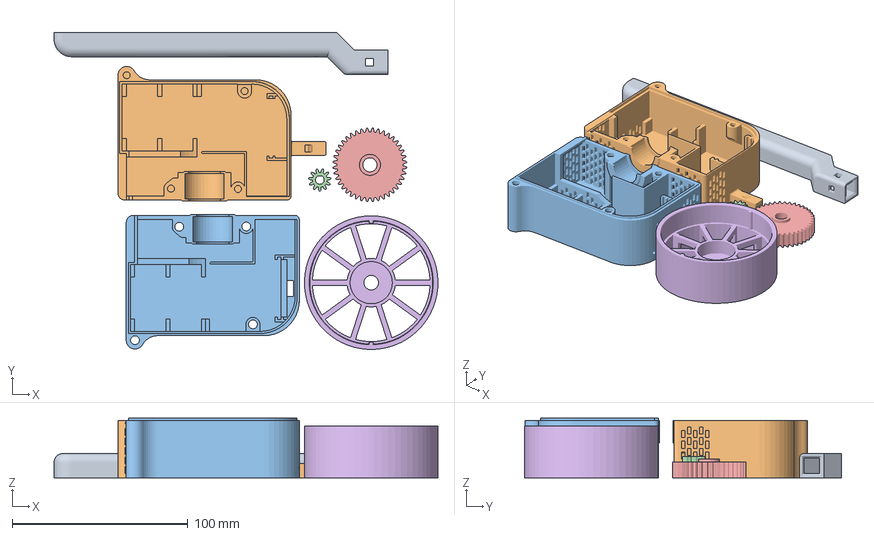
[picture p127: CAD file, 2022-12-04]
Hardware/Case Version2/Mounting_For_New_Case.3mf
218.4 x 180.3 x 33.9 mm
Mounting_For_New_Case.STL
Body_Left.STL
Body_Right.STL
Spur gear 1M 11T.STL
SS2K 40T Mod1 Spur Gear.STL
Knob_Cup_Large_HEX.STL
