alexquilty/SmartSpin2k/Hardware/Inserts/Golds_Gym_300_TPU.STL

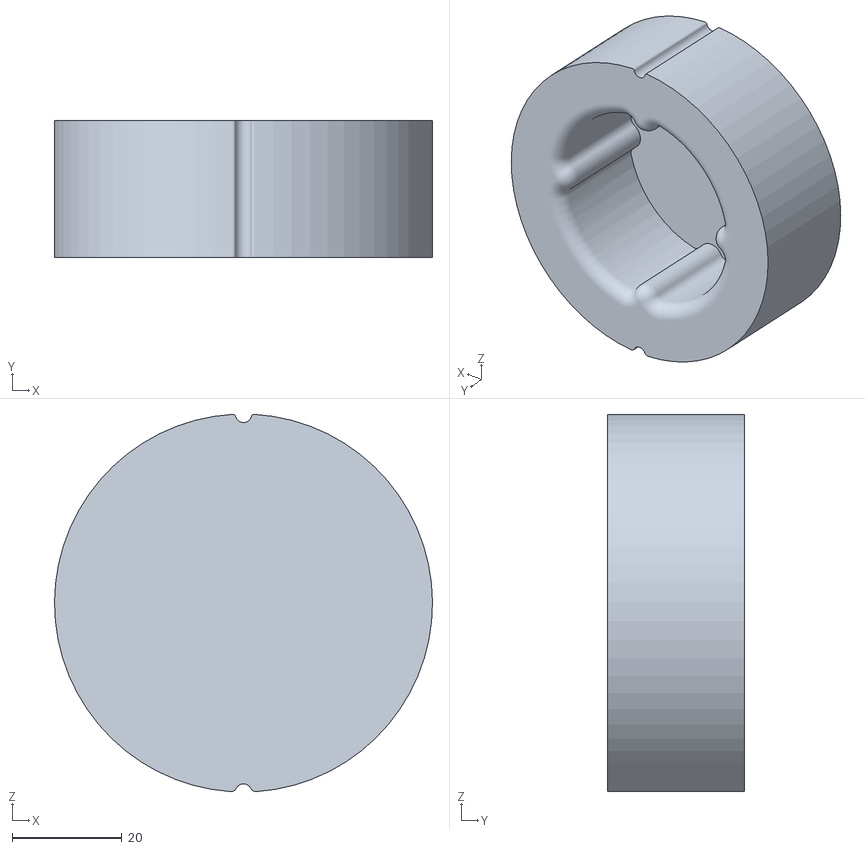
[picture p128: CAD file, 2022-12-04]
Hardware/Inserts/Golds_Gym_300_TPU.STL
69.0 x 25.0 x 68.9
