alexquilty/SmartSpin2k/Hardware/Inserts/Solidworks_Designs/Vortec_Team_regular_60mm.SLDPRT

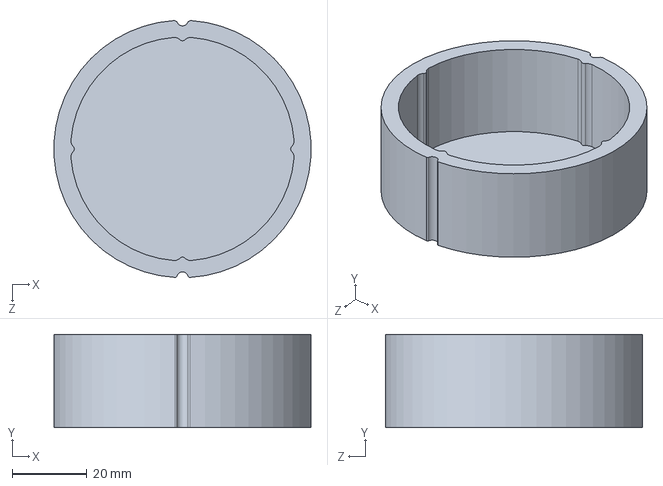
[picture p129: CAD file, 2022-12-04]
Hardware/Inserts/Solidworks_Designs/Vortec_Team_regular_60mm.SLDPRT
68.9 x 25.0 x 68.9 mm
