alexquilty/SmartSpin2k/Hardware/Integrated PCB/SS2K_KiCad_Files/3d_Parts/Micro_usb_STL.stl

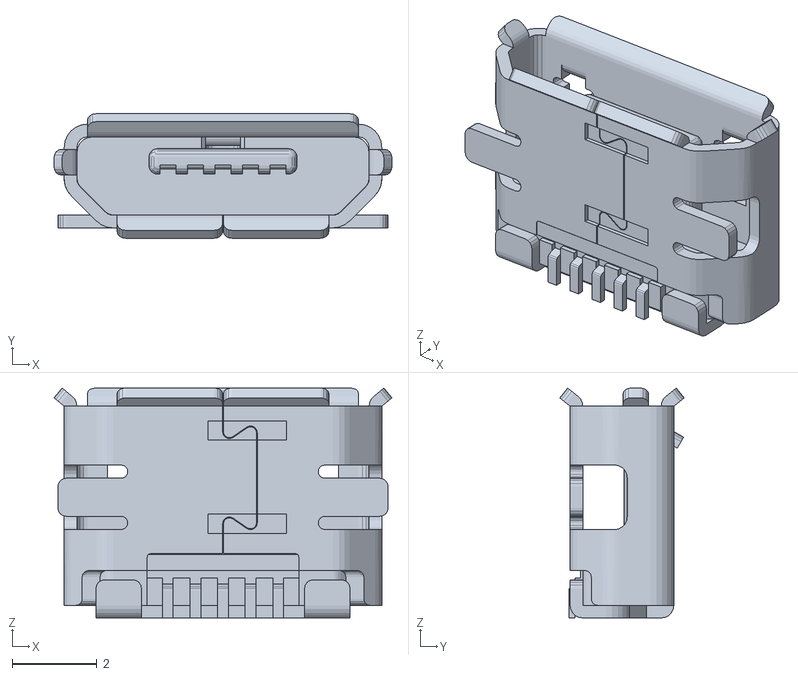
[picture p130: CAD file, 2022-12-04]
Hardware/Integrated PCB/SS2K_KiCad_Files/3d_Parts/Micro_usb_STL.stl
7.98 x 2.94 x 5.43
