alexquilty/SmartSpin2k/Hardware/Integrated PCB/ss2k_pcb.3mf

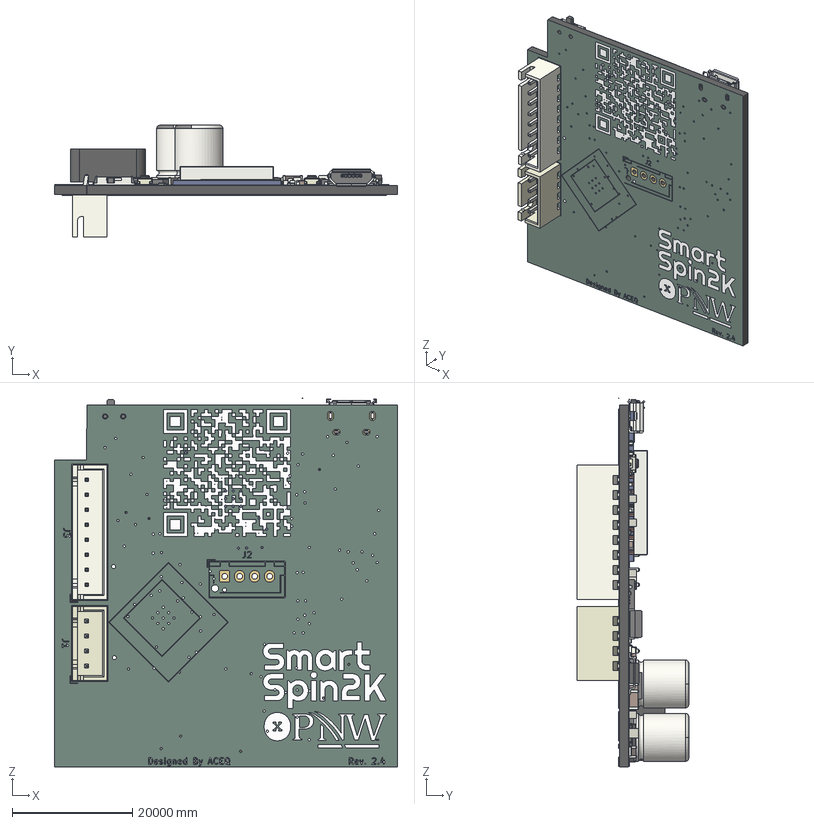
[picture p131: CAD file, 2022-12-04]
Hardware/Integrated PCB/ss2k_pcb.3mf
57162.4 x 18600.2 x 61476.4 mm
