alexquilty/SmartSpin2k/Hardware/KnobCups/CAD/Knob_Cup_Large_HEX.STEP

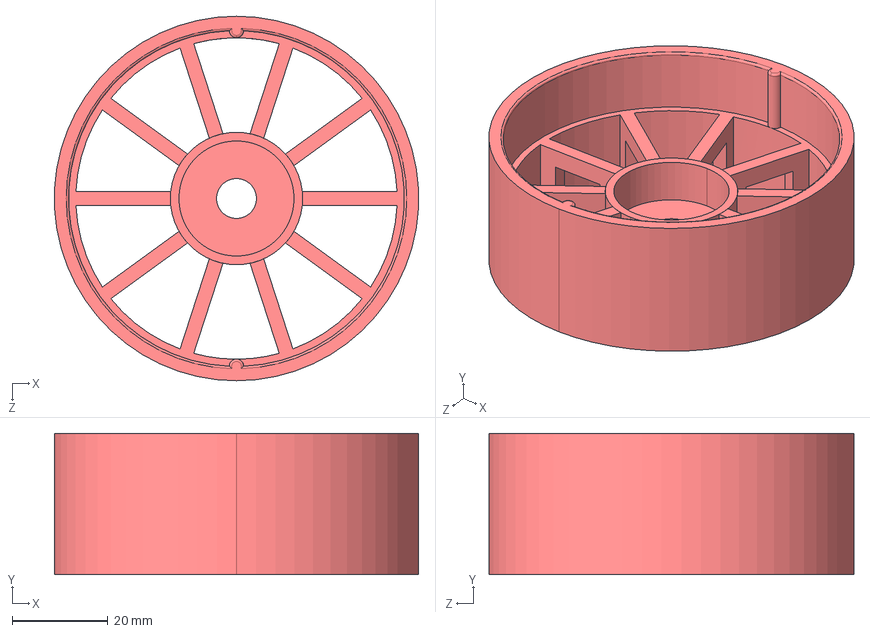
[picture p132: CAD file, 2022-12-04]
Hardware/KnobCups/CAD/Knob_Cup_Large_HEX.STEP
75.9 x 29.5 x 76.0 mm
