alexquilty/SmartSpin2k/Hardware/MODS/Case V2 - Ultra Short Mod/Case/CAD/Body_Drawing_Right.STEP

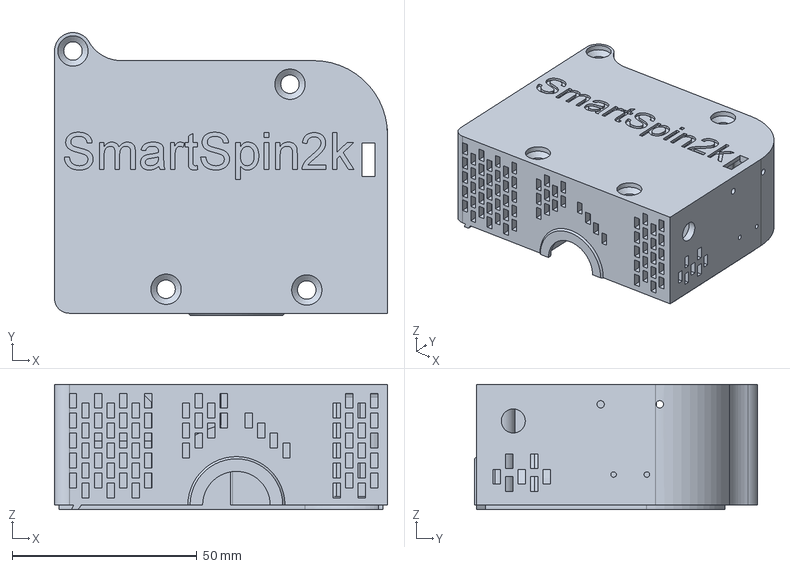
[picture p133: CAD file, 2022-12-04]
Hardware/MODS/Case V2 - Ultra Short Mod/Case/CAD/Body_Drawing_Right.STEP
90.2 x 76.6 x 33.9 mm
