alexquilty/SmartSpin2k/Hardware/MODS/Direct Mount Mod/Arm/Bowflex C7.stl

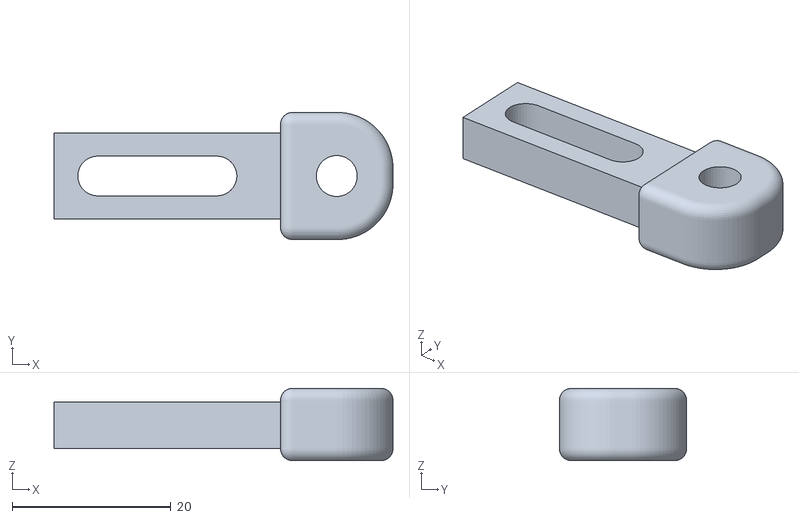
[picture p134: CAD file, 2022-12-04]
Hardware/MODS/Direct Mount Mod/Arm/Bowflex C7.stl
42.7 x 16.0 x 9.10
