alexquilty/SmartSpin2k/Hardware/MODS/Direct Mount Mod/Arm/CAD/_ss2k arm - reference.step

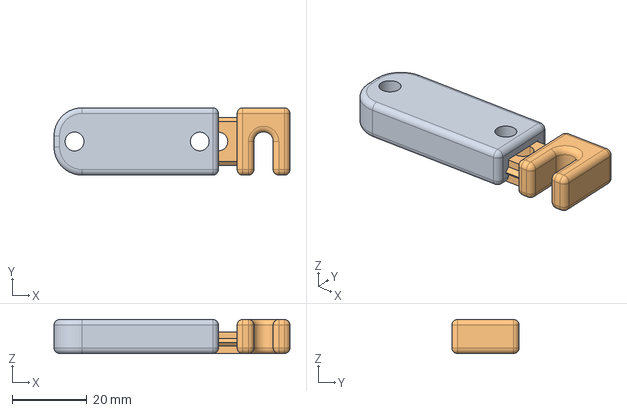
[picture p135: CAD file, 2022-12-04]
Hardware/MODS/Direct Mount Mod/Arm/CAD/_ss2k arm - reference.step
63.1 x 18.0 x 9.10 mm
