alexquilty/SmartSpin2k/Hardware/MODS/Direct Mount Mod/Bike Mount/CAD/bike mount.step

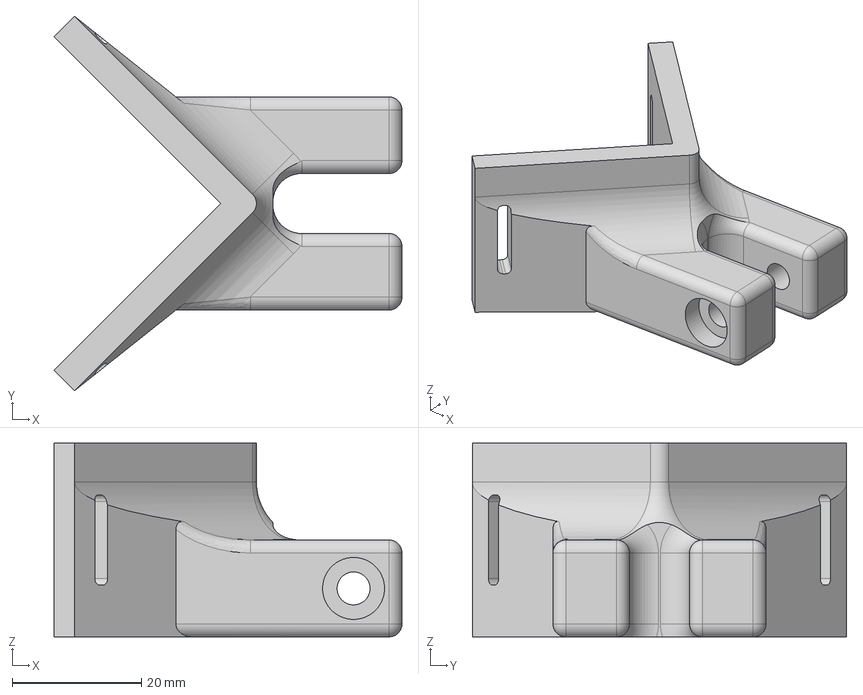
[picture p136: CAD file, 2022-12-04]
Hardware/MODS/Direct Mount Mod/Bike Mount/CAD/bike mount.step
53.9 x 58.0 x 30.0 mm
Generic 30mm wide
IC4 Mount
