alexquilty/SmartSpin2k/Hardware/MODS/Direct Mount Mod/Bike Mount/Peloton.stl

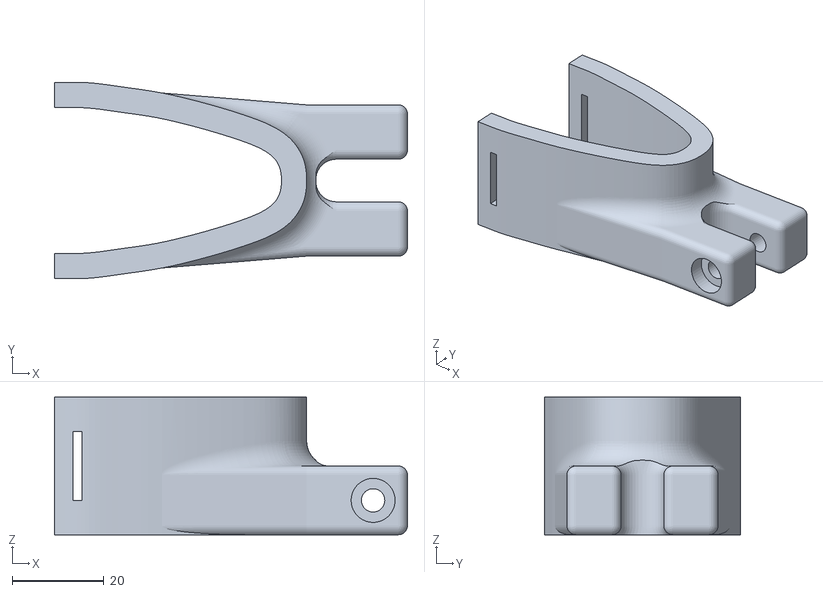
[picture p137: CAD file, 2022-12-04]
Hardware/MODS/Direct Mount Mod/Bike Mount/Peloton.stl
77.0 x 42.8 x 30.0
