alexquilty/SmartSpin2k/Hardware/MODS/Direct Mount Mod/Case/CAD/Direct Mount Mod v12.step

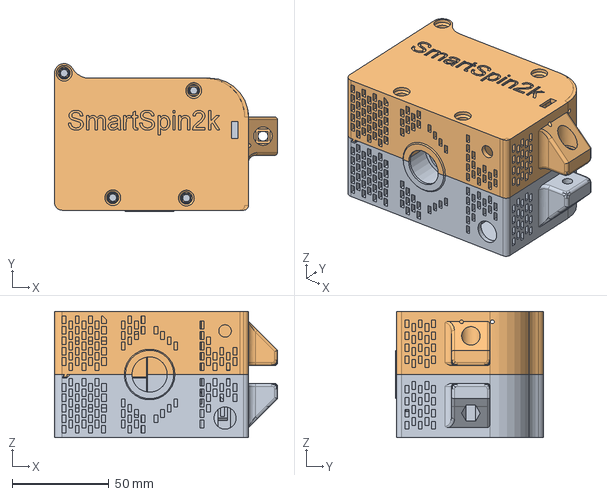
[picture p138: CAD file, 2022-12-04]
Hardware/MODS/Direct Mount Mod/Case/CAD/Direct Mount Mod v12.step
115.5 x 76.6 x 65.4 mm
