alexquilty/SmartSpin2k/Hardware/MODS/Direct Mount Mod/Short Case/Body-Right.stl

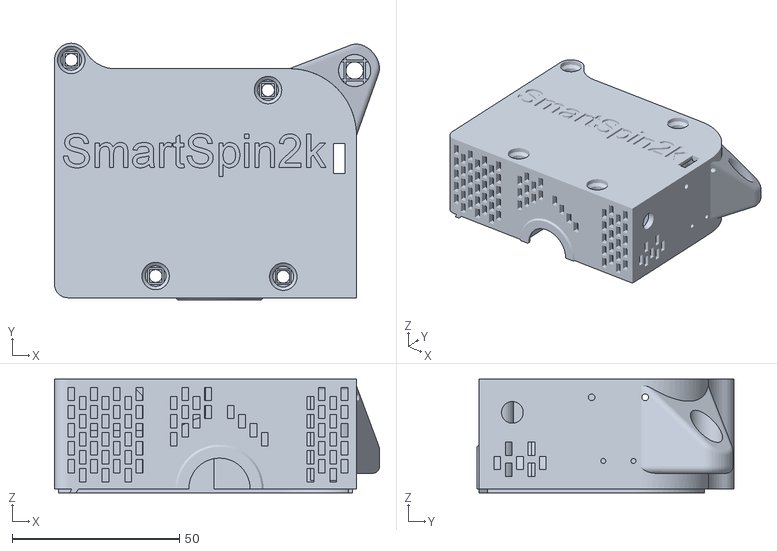
[picture p139: CAD file, 2022-12-04]
Hardware/MODS/Direct Mount Mod/Short Case/Body-Right.stl
97.0 x 76.6 x 33.9
