alexquilty/SmartSpin2k/Hardware/MODS/Direct Mount Mod/Short Case/CAD/Short Case Direct Mount.step

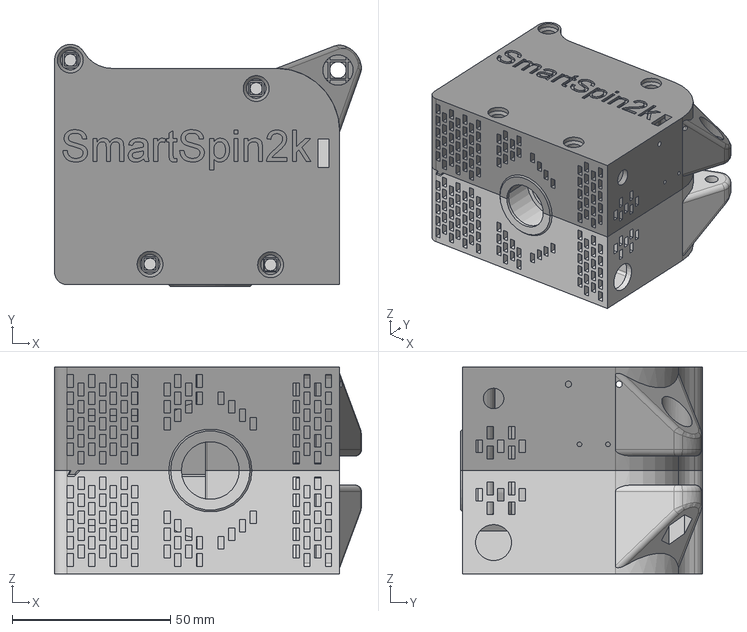
[picture p140: CAD file, 2022-12-04]
Hardware/MODS/Direct Mount Mod/Short Case/CAD/Short Case Direct Mount.step
97.0 x 76.6 x 65.4 mm
