alexquilty/SmartSpin2k/Hardware/MODS/Soldering Jig/CAD/soldering jig v4.step

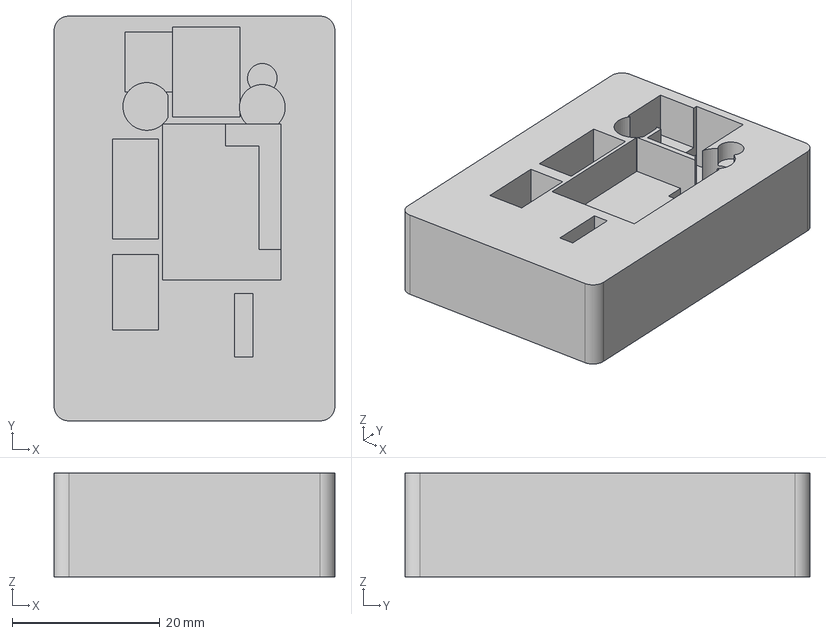
[picture p141: CAD file, 2022-12-04]
Hardware/MODS/Soldering Jig/CAD/soldering jig v4.step
38.0 x 54.7 x 14.0 mm
