alexquilty/SmartSpin2k/Hardware/Shifters/CAD/Shifter Cover.step

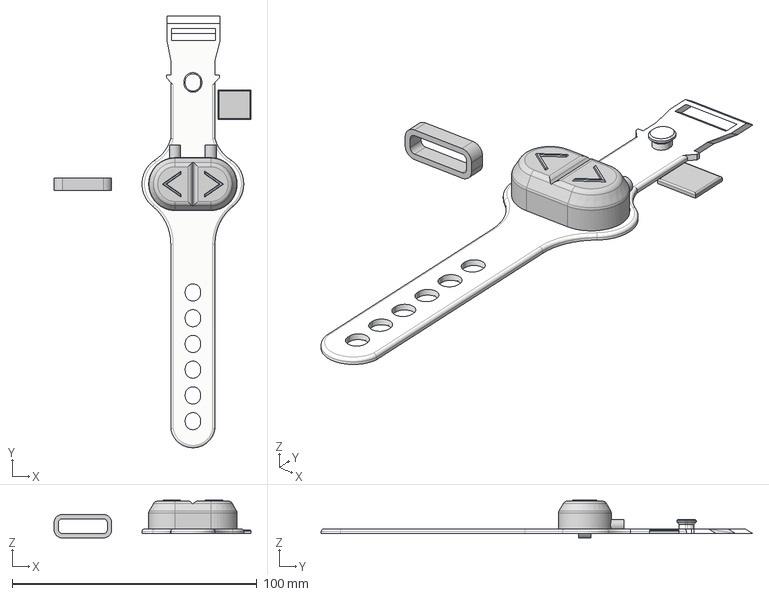
[picture p142: CAD file, 2022-12-04]
Hardware/Shifters/CAD/Shifter Cover.step
80.5 x 176.5 x 15.5 mm
Strap
Plug
