alexquilty/SmartSpin2k/Hardware/Shifters/retainer.stl

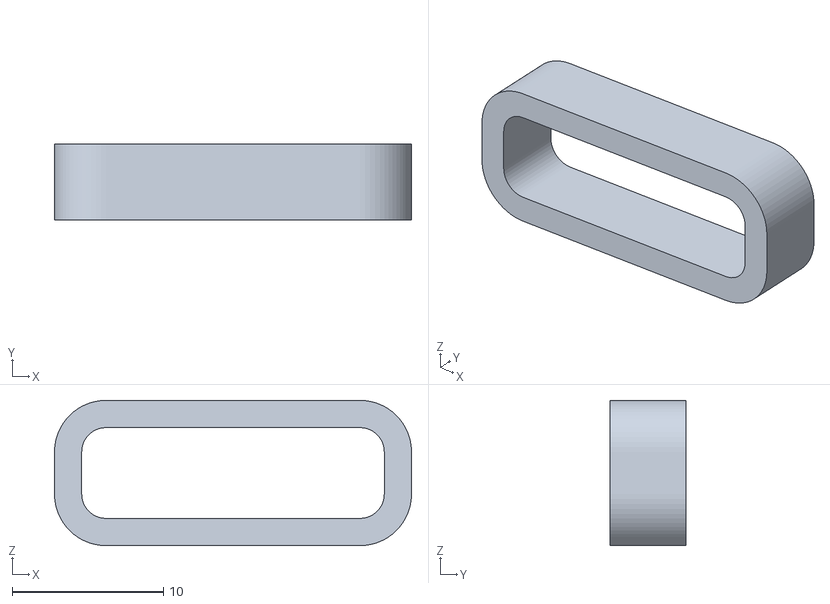
[picture p143: CAD file, 2022-12-04]
Hardware/Shifters/retainer.stl
23.6 x 5.00 x 9.60
