alexquilty/SmartSpin2k/Hardware/Case Integrated PCB/Case/CAD/Window.SLDPRT

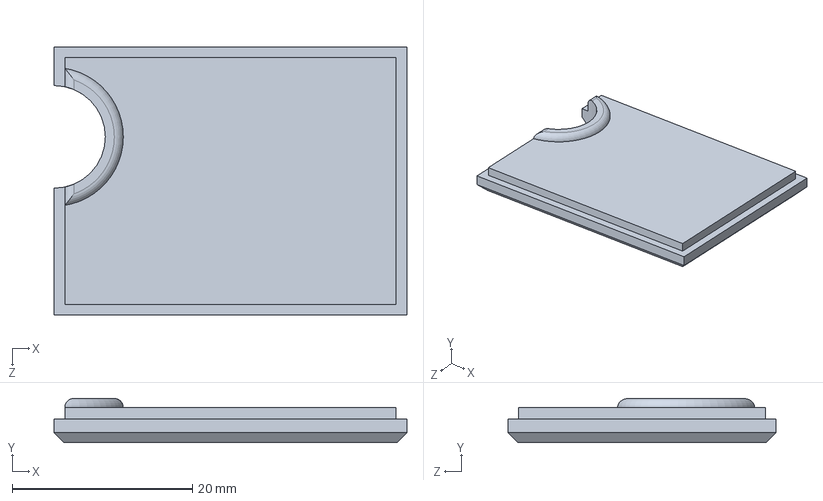
[picture p144: CAD file, 2022-12-04]
Hardware/Case Integrated PCB/Case/CAD/Window.SLDPRT
39.2 x 4.90 x 29.8 mm
