alexquilty/SmartSpin2k/Hardware/Case Integrated PCB/Gears/CAD/Gear_Shaft.SLDPRT

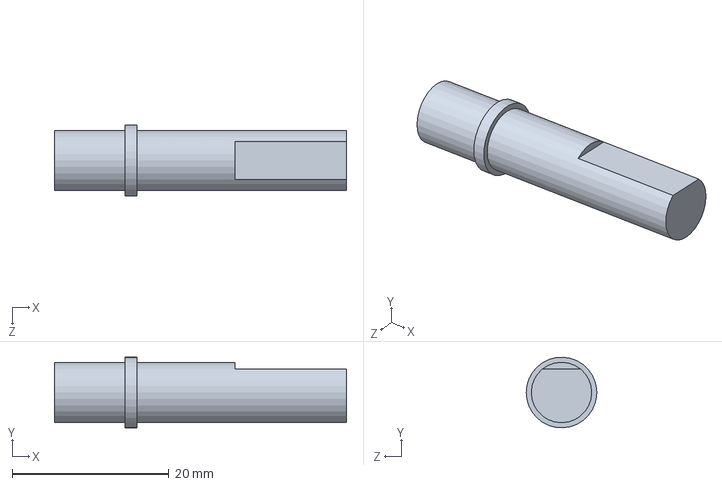
[picture p145: CAD file, 2022-12-04]
Hardware/Case Integrated PCB/Gears/CAD/Gear_Shaft.SLDPRT
37.2 x 8.99 x 9.00 mm
