alexquilty/SmartSpin2k/Hardware/Inserts/50mm.STL

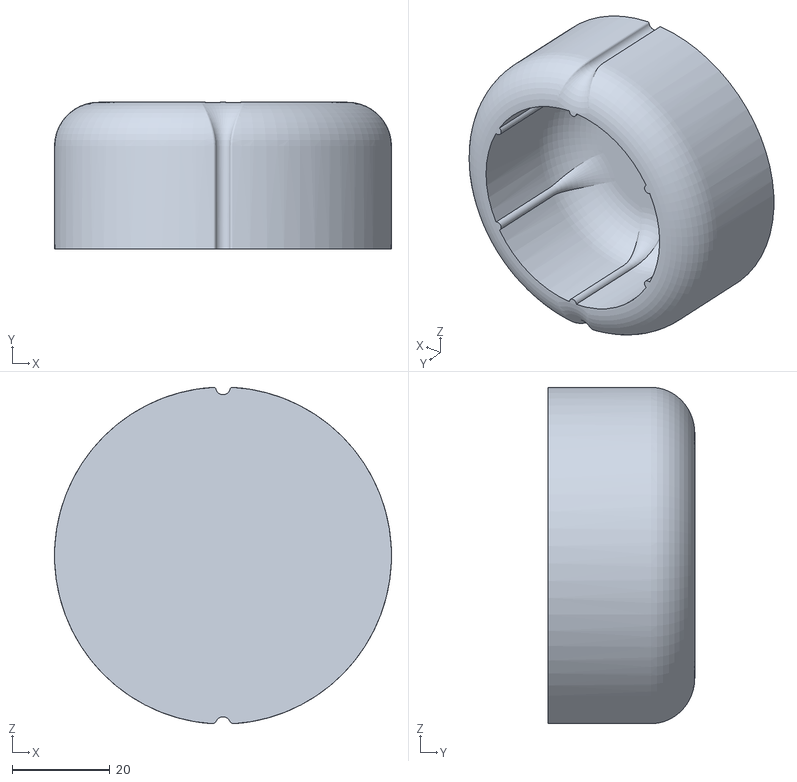
[picture p146: CAD file, 2022-12-04]
Hardware/Inserts/50mm.STL
69.0 x 30.0 x 68.9
