alexquilty/SmartSpin2k/Hardware/Inserts/Solidworks_Designs/Peloton_60mm.SLDPRT

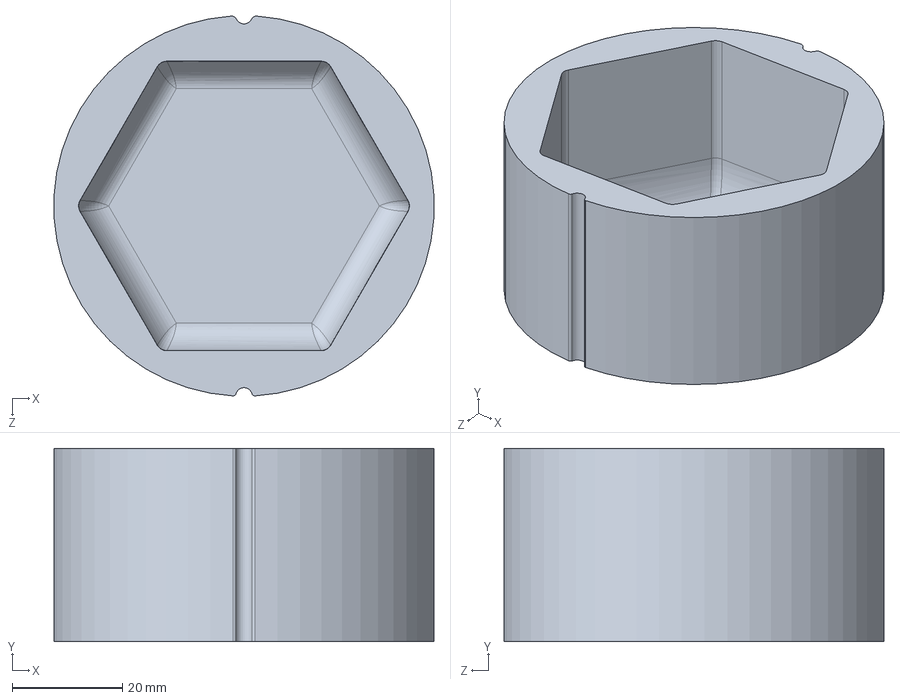
[picture p147: CAD file, 2022-12-04]
Hardware/Inserts/Solidworks_Designs/Peloton_60mm.SLDPRT
68.9 x 35.0 x 68.9 mm
