alexquilty/SmartSpin2k/Hardware/KnobCups/CAD/Knob_Cup_Large.SLDPRT

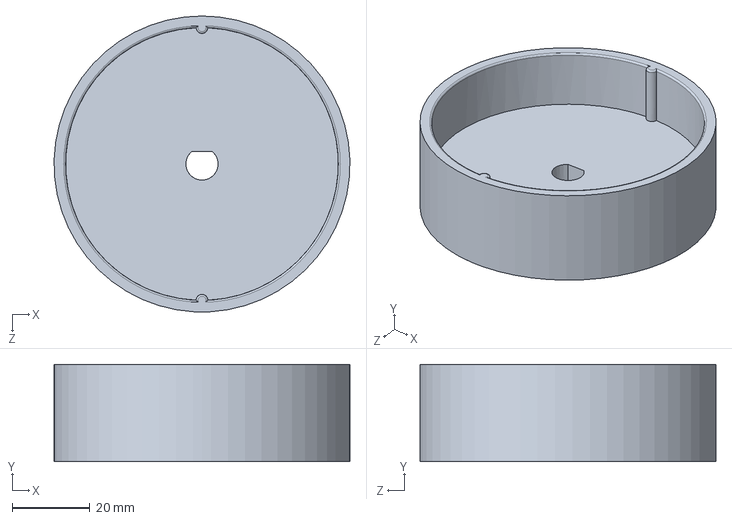
[picture p148: CAD file, 2022-12-04]
Hardware/KnobCups/CAD/Knob_Cup_Large.SLDPRT
76.0 x 25.0 x 76.0 mm
