alexquilty/SmartSpin2k/Hardware/MODS/Direct Mount Mod/Arm/_arm hook.stl

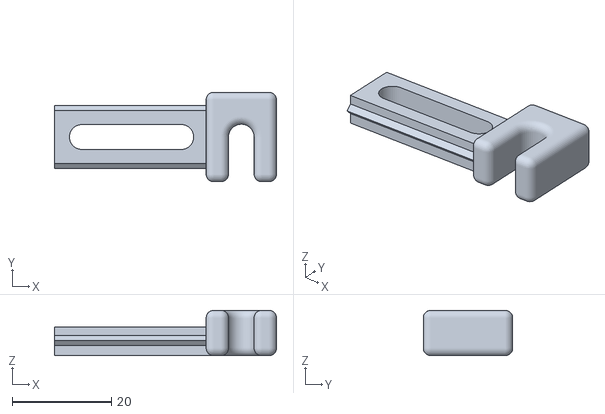
[picture p149: CAD file, 2022-12-04]
Hardware/MODS/Direct Mount Mod/Arm/_arm hook.stl
44.7 x 18.0 x 9.10
