alexquilty/SmartSpin2k/Hardware/MODS/Direct Mount Mod/Bike Mount/CAD/Bowflex C7.step

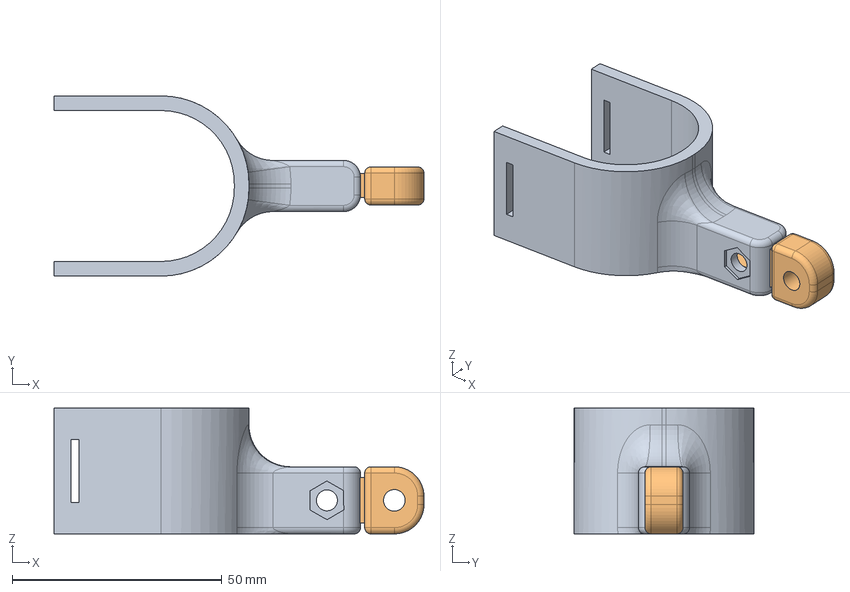
[picture p150: CAD file, 2022-12-04]
Hardware/MODS/Direct Mount Mod/Bike Mount/CAD/Bowflex C7.step
88.2 x 43.0 x 30.0 mm
30mm wide
Bowflex C7
