alexquilty/SmartSpin2k/Hardware/MODS/Direct Mount Mod/Bike Mount/LeMond Promaster.stl

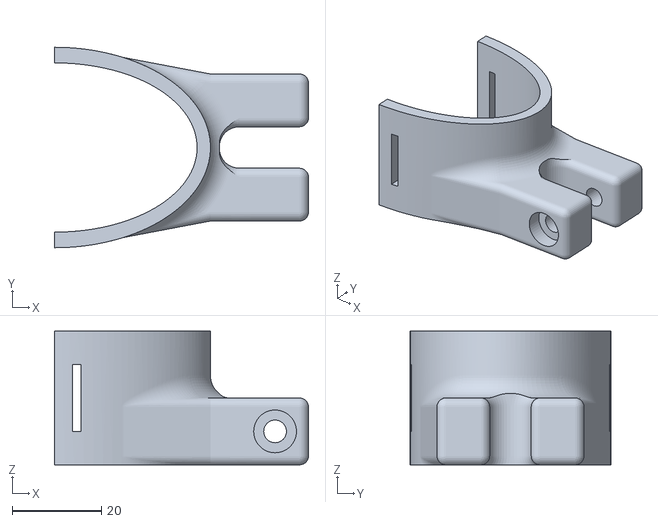
[picture p151: CAD file, 2022-12-04]
Hardware/MODS/Direct Mount Mod/Bike Mount/LeMond Promaster.stl
57.0 x 45.0 x 30.0
