alexquilty/SmartSpin2k/Hardware/MODS/Direct Mount Mod/Case/body-right.stl

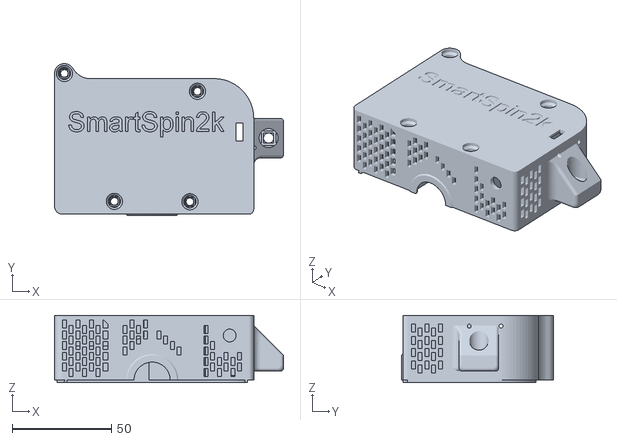
[picture p152: CAD file, 2022-12-04]
Hardware/MODS/Direct Mount Mod/Case/body-right.stl
115.5 x 76.6 x 33.9
