alexquilty/SmartSpin2k/Hardware/MODS/Direct Mount Mod/Short Case/body-left.stl

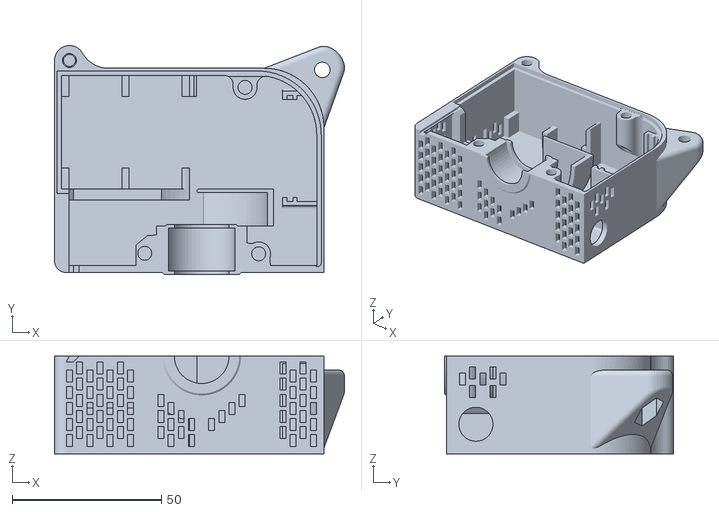
[picture p153: CAD file, 2022-12-04]
Hardware/MODS/Direct Mount Mod/Short Case/body-left.stl
97.0 x 76.6 x 32.7
