alexquilty/SmartSpin2k/Hardware/Shifters/Plug.stl

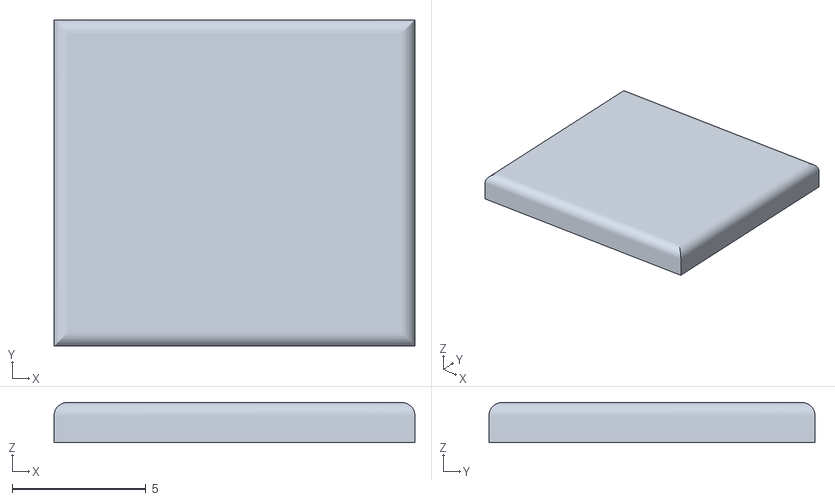
[picture p154: CAD file, 2022-12-04]
Hardware/Shifters/Plug.stl
13.5 x 12.2 x 1.50
