alexquilty/SmartSpin2k/Hardware/Case Integrated PCB/Gears/CAD/Spur gear 1M 40T.SLDPRT

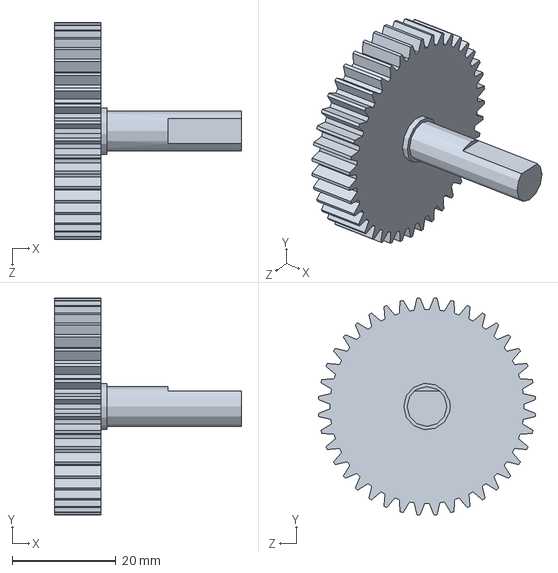
[picture p155: CAD file, 2022-12-04]
Hardware/Case Integrated PCB/Gears/CAD/Spur gear 1M 40T.SLDPRT
36.2 x 41.9 x 41.9 mm
