alexquilty/SmartSpin2k/Hardware/Case Version2/Case/CAD/Body_Drawing.SLDPRT

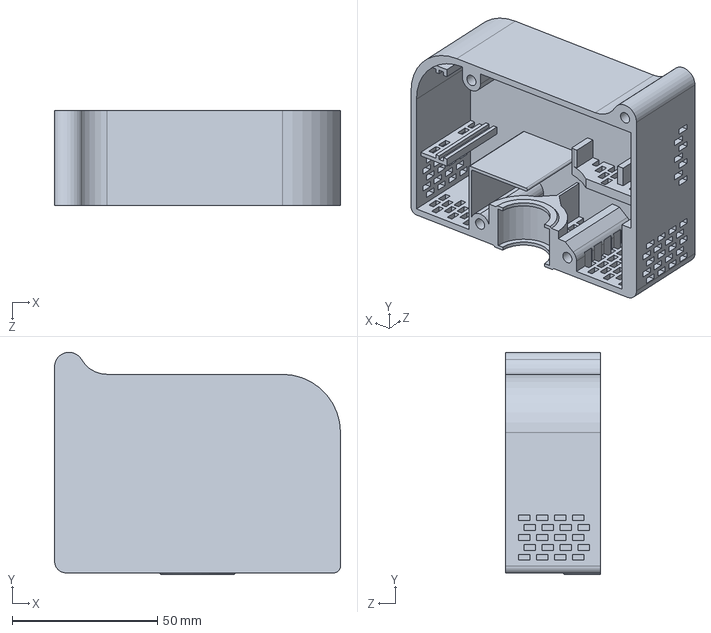
[picture p156: CAD file, 2022-12-04]
Hardware/Case Version2/Case/CAD/Body_Drawing.SLDPRT
98.5 x 76.6 x 32.7 mm
