alexquilty/SmartSpin2k/Hardware/Case Version2/Gears/CAD/Spur gear 1M 11T.SLDPRT

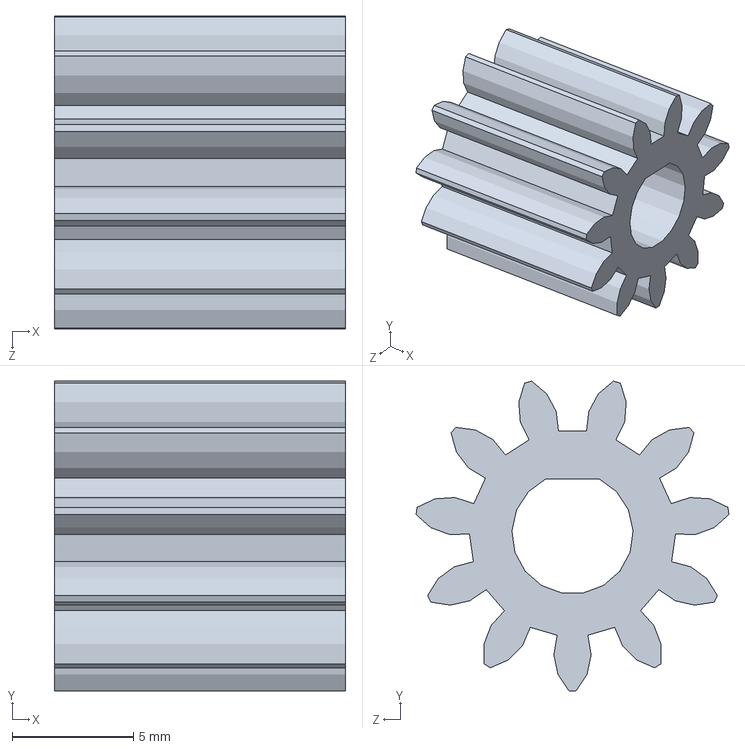
[picture p157: CAD file, 2022-12-04]
Hardware/Case Version2/Gears/CAD/Spur gear 1M 11T.SLDPRT
12.0 x 12.8 x 12.9 mm
