alexquilty/SmartSpin2k/Hardware/MODS/Case V2 - Ultra Short Mod/Case/CAD/Body_Drawing.SLDPRT

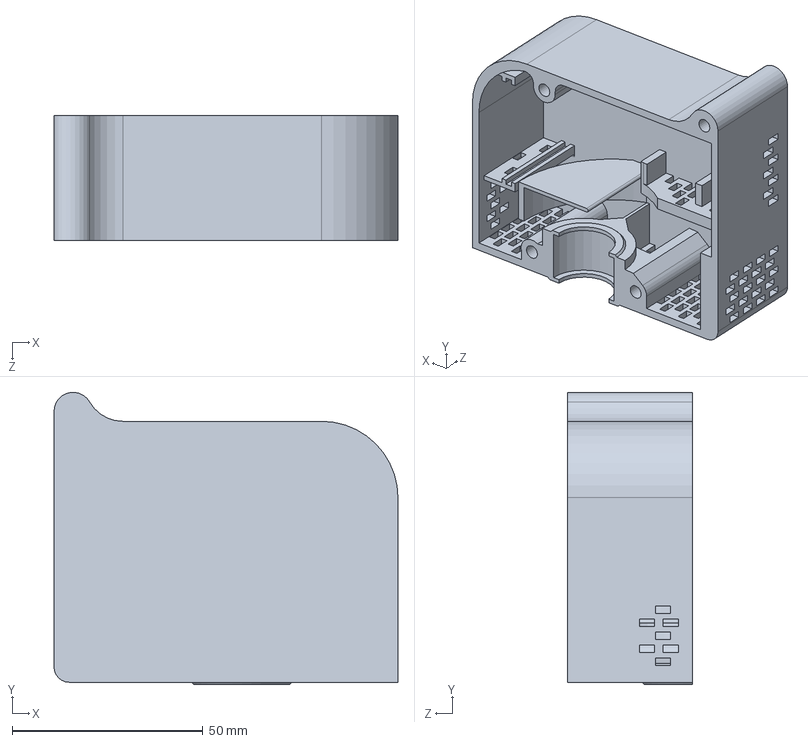
[picture p158: CAD file, 2022-12-04]
Hardware/MODS/Case V2 - Ultra Short Mod/Case/CAD/Body_Drawing.SLDPRT
90.2 x 76.6 x 32.7 mm
