alexquilty/SmartSpin2k/Hardware/MODS/Direct Mount Mod/Arm/CAD/echelon connect sport.step

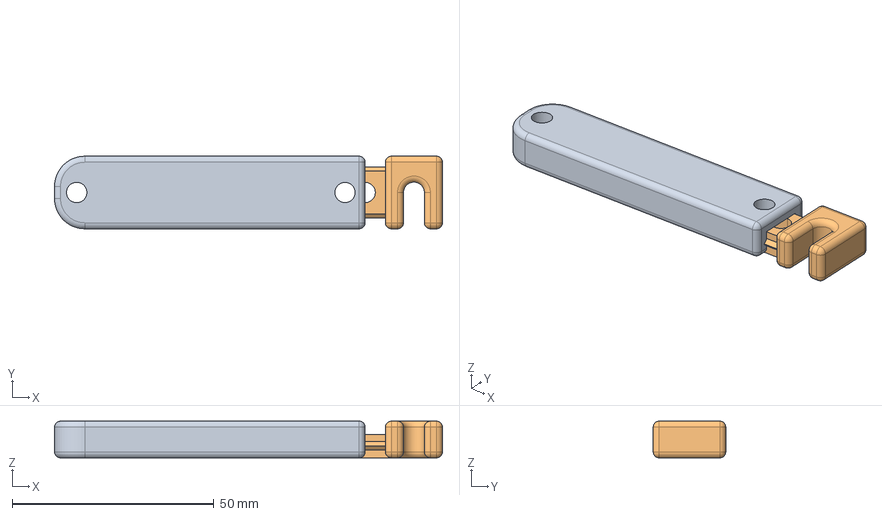
[picture p159: CAD file, 2022-12-04]
Hardware/MODS/Direct Mount Mod/Arm/CAD/echelon connect sport.step
96.2 x 18.0 x 9.10 mm
