alexquilty/SmartSpin2k/Hardware/MODS/Direct Mount Mod/Case/body-left.stl

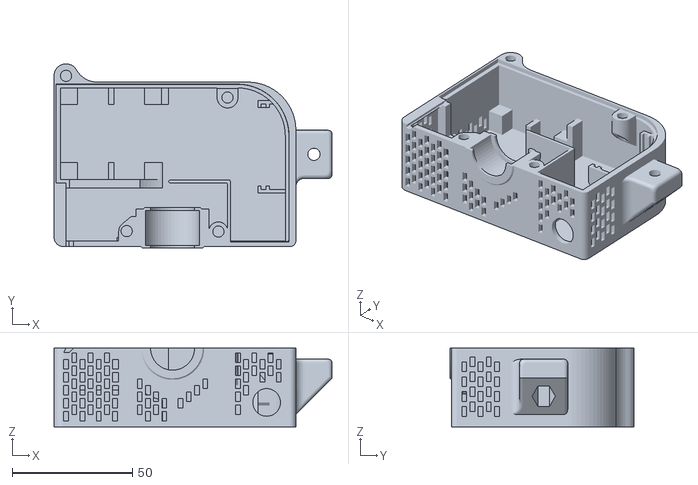
[picture p160: CAD file, 2022-12-04]
Hardware/MODS/Direct Mount Mod/Case/body-left.stl
115.5 x 76.6 x 32.7
