alexquilty/SmartSpin2k/Hardware/Shifters/test_housing.stl

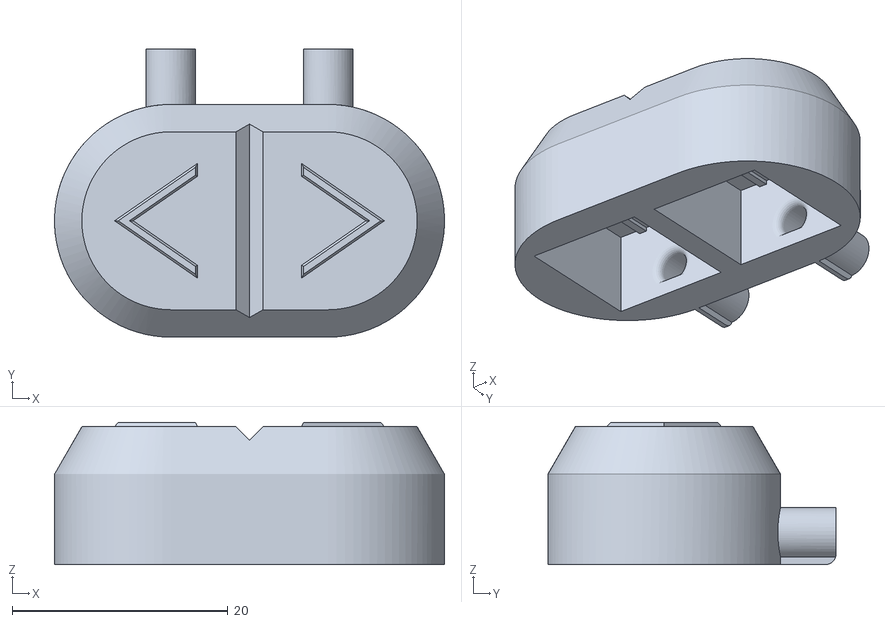
[picture p161: CAD file, 2022-12-04]
Hardware/Shifters/test_housing.stl
36.2 x 26.7 x 13.2
