alexquilty/SmartSpin2k/Hardware/Inserts/Solidworks_Designs/Schwinn_IC4_48.5mm.SLDPRT

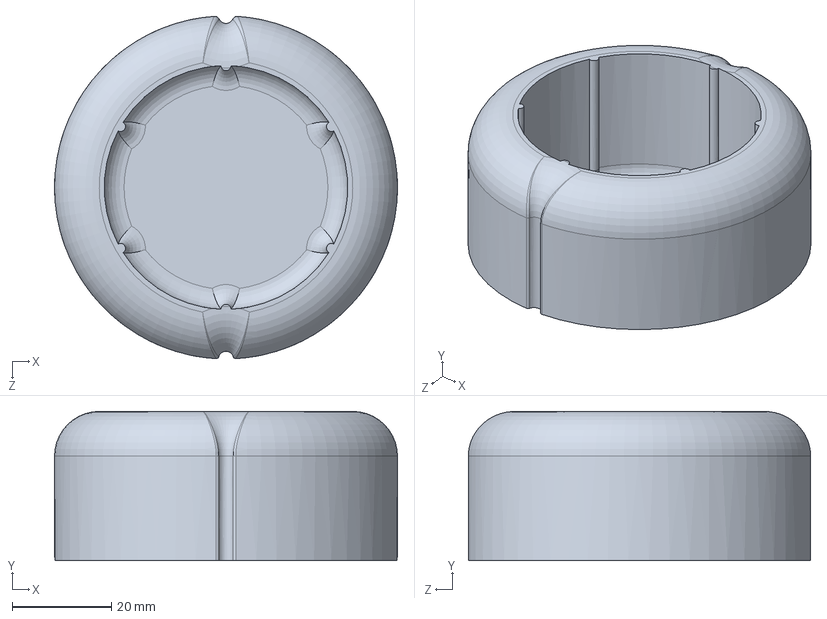
[picture p162: CAD file, 2022-12-04]
Hardware/Inserts/Solidworks_Designs/Schwinn_IC4_48.5mm.SLDPRT
69.0 x 30.0 x 68.9 mm
