alexquilty/SmartSpin2k/Hardware/MODS/Case V2 - Ultra Short Mod/Case/CAD/Body_Drawing_Left.STEP

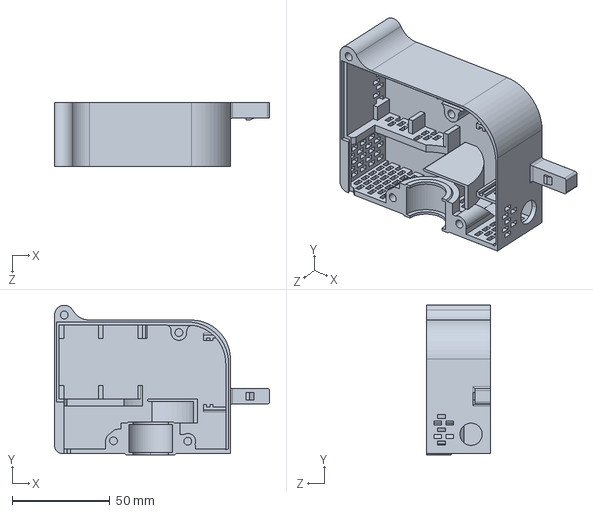
[picture p163: CAD file, 2022-12-04]
Hardware/MODS/Case V2 - Ultra Short Mod/Case/CAD/Body_Drawing_Left.STEP
110.2 x 76.6 x 32.7 mm
