alexquilty/SmartSpin2k/Hardware/MODS/Direct Mount Mod/Arm/CAD/_ss2k arm - reference v4 v7.step

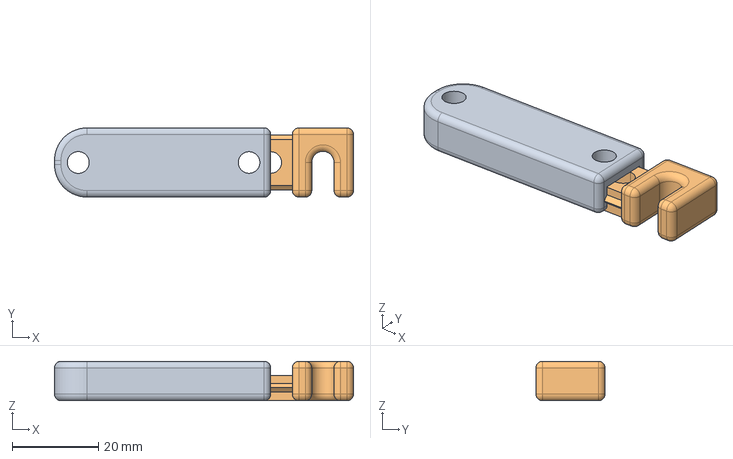
[picture p164: CAD file, 2022-12-04]
Hardware/MODS/Direct Mount Mod/Arm/CAD/_ss2k arm - reference v4 v7.step
69.2 x 16.0 x 9.10 mm
