alexquilty/SmartSpin2k/Hardware/MODS/Direct Mount Mod/Bike Mount/Life Fitness IC7.stl

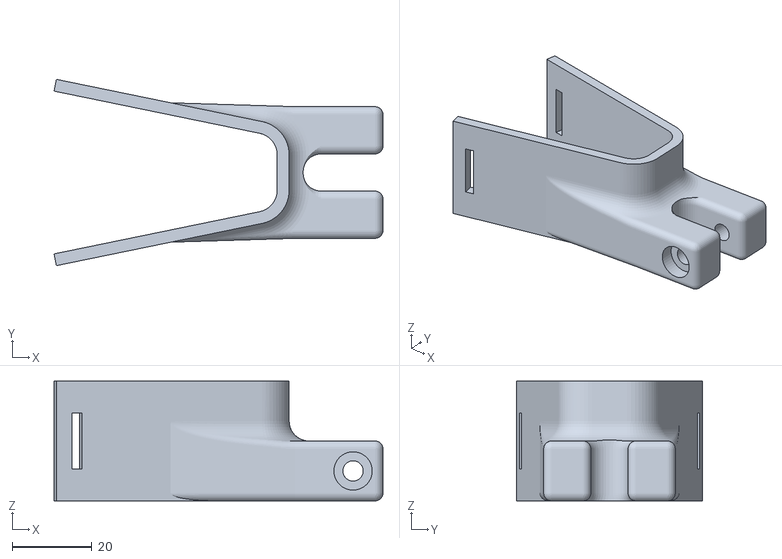
[picture p165: CAD file, 2022-12-04]
Hardware/MODS/Direct Mount Mod/Bike Mount/Life Fitness IC7.stl
82.4 x 46.7 x 30.0
