alexquilty/SmartSpin2k/Hardware/Shifters/shifter_set.stl

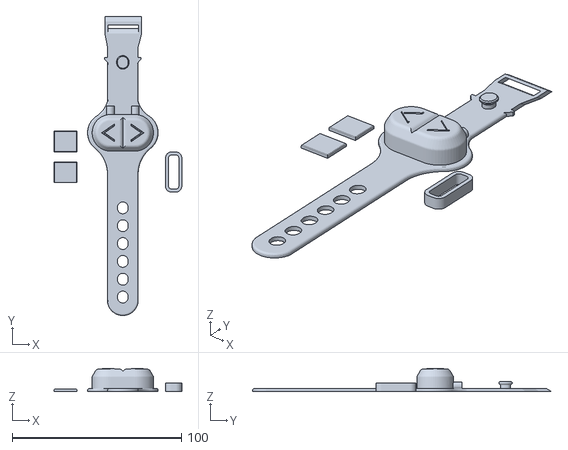
[picture p166: CAD file, 2022-12-04]
Hardware/Shifters/shifter_set.stl
75.3 x 176.5 x 13.7
