alexquilty/SmartSpin2k/Hardware/Case Version2/Case/CAD/Connectors/DC_PWR_CONN.STEP

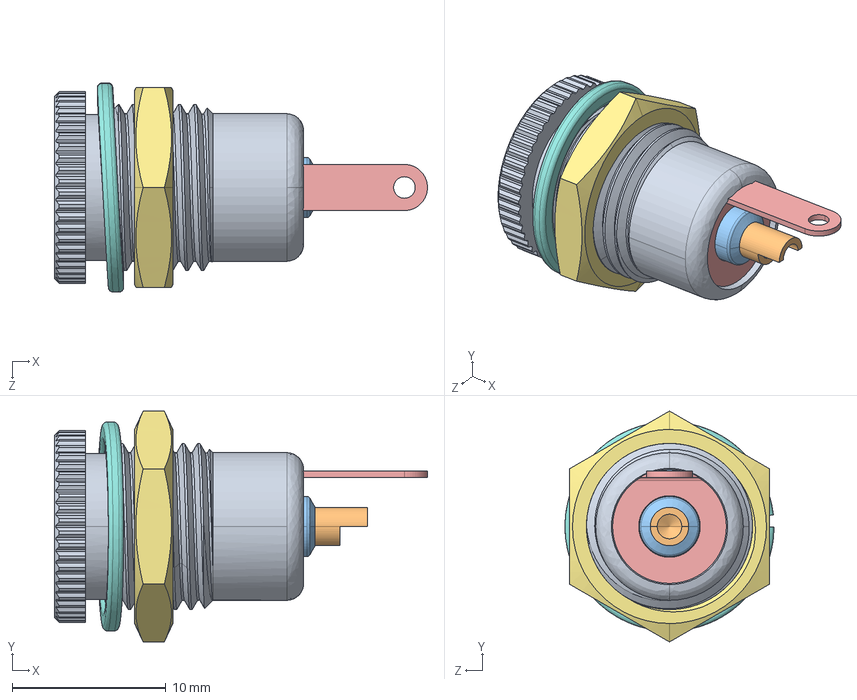
[picture p167: CAD file, 2022-12-04]
Hardware/Case Version2/Case/CAD/Connectors/DC_PWR_CONN.STEP
24.2 x 15.0 x 13.6 mm
54-00063_Nickel Plating
