alexquilty/SmartSpin2k/Hardware/Inserts/Solidworks_Designs/Body_Power_45mm.STEP

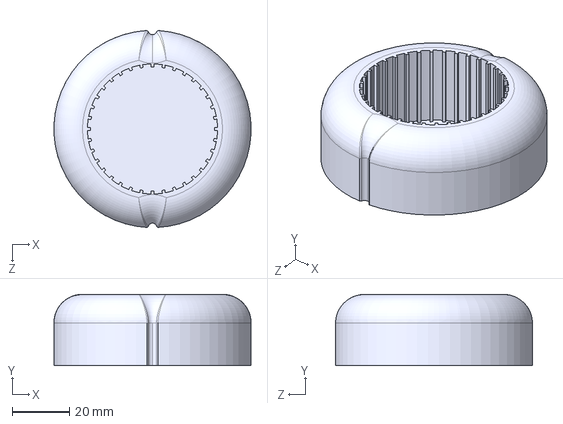
[picture p168: CAD file, 2022-12-04]
Hardware/Inserts/Solidworks_Designs/Body_Power_45mm.STEP
68.9 x 25.0 x 68.9 mm
