alexquilty/SmartSpin2k/Hardware/MODS/Direct Mount Mod/Arm/CAD/Peloton.step

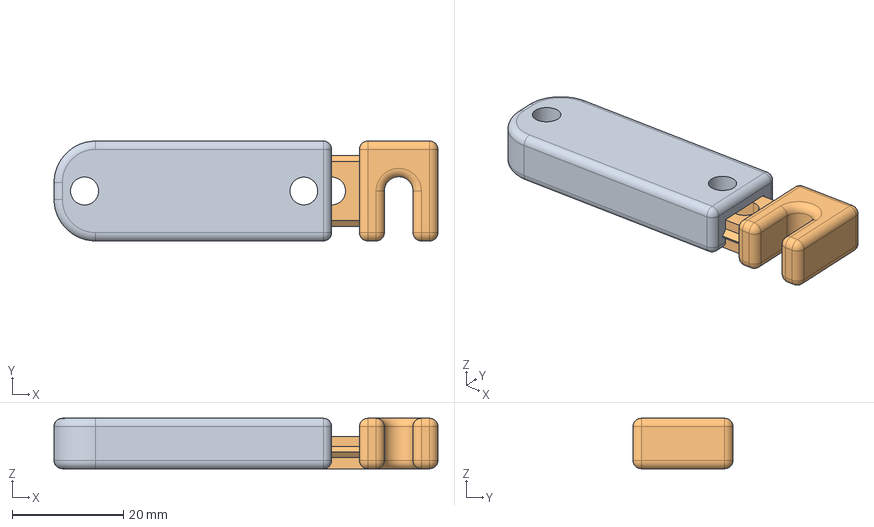
[picture p169: CAD file, 2022-12-04]
Hardware/MODS/Direct Mount Mod/Arm/CAD/Peloton.step
69.2 x 18.0 x 9.10 mm
