alexquilty/SmartSpin2k/Hardware/MODS/Direct Mount Mod/Bike Mount/Echelon Mount.stl

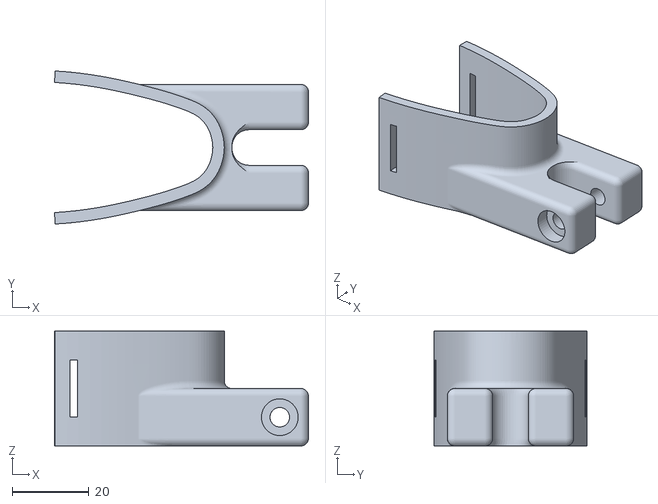
[picture p170: CAD file, 2022-12-04]
Hardware/MODS/Direct Mount Mod/Bike Mount/Echelon Mount.stl
66.3 x 40.0 x 30.0
