alexquilty/SmartSpin2k/Hardware/Shifters/strap.stl

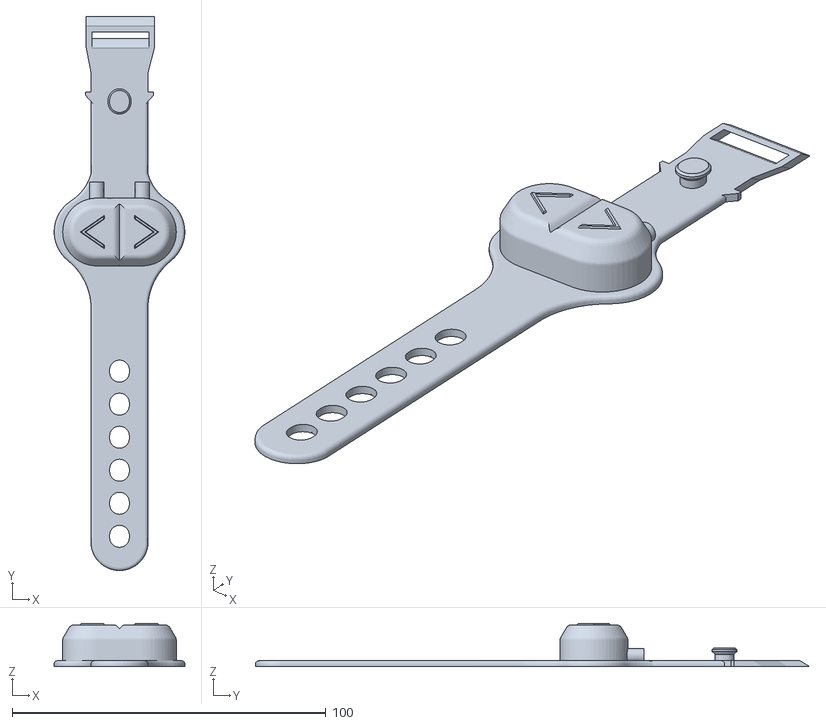
[picture p171: CAD file, 2022-12-04]
Hardware/Shifters/strap.stl
41.6 x 176.5 x 13.7
