alexquilty/SmartSpin2k/Hardware/Inserts/Star Trac 2010.stl

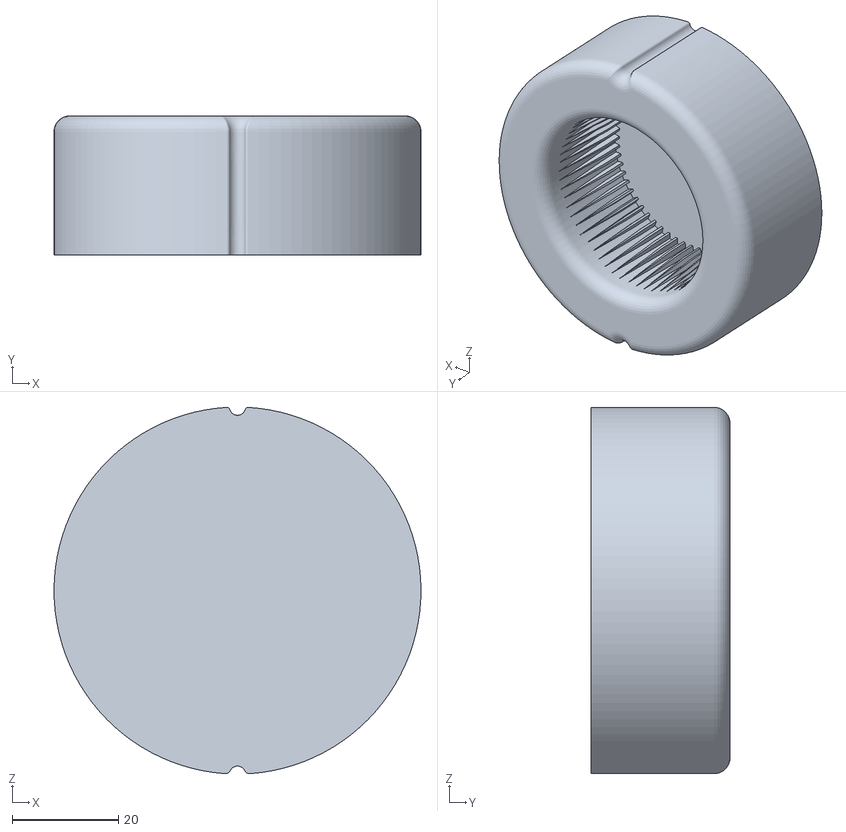
[picture p172: CAD file, 2022-12-04]
Hardware/Inserts/Star Trac 2010.stl
69.0 x 26.2 x 68.9
