alexquilty/SmartSpin2k/Hardware/Inserts/Le Mond Revmaster.stl

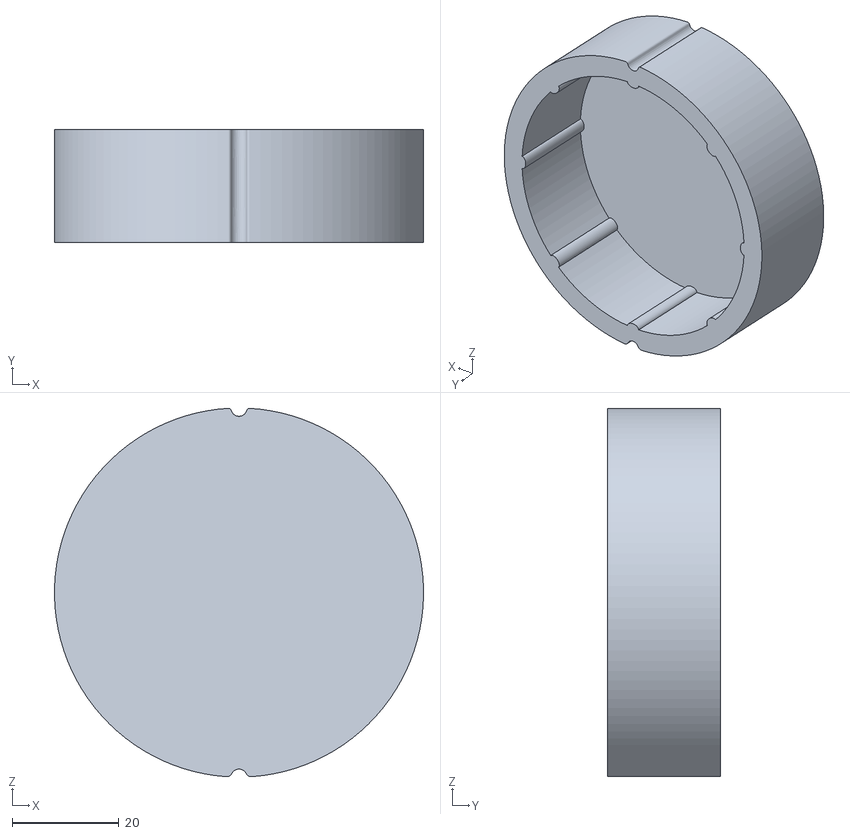
[picture p173: CAD file, 2022-12-04]
Hardware/Inserts/Le Mond Revmaster.stl
69.0 x 21.2 x 68.9
