alexquilty/SmartSpin2k/Hardware/Inserts/Solidworks_Designs/Proform_49.5mm.SLDPRT

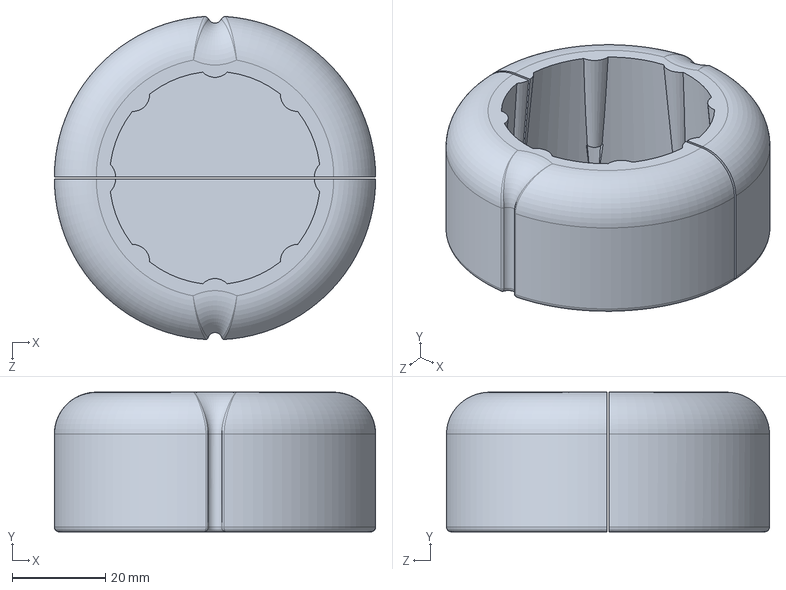
[picture p174: CAD file, 2022-12-04]
Hardware/Inserts/Solidworks_Designs/Proform_49.5mm.SLDPRT
69.0 x 30.0 x 69.4 mm
