alexquilty/SmartSpin2k/Hardware/Inserts/Solidworks_Designs/JOROTOX261mm.SLDPRT

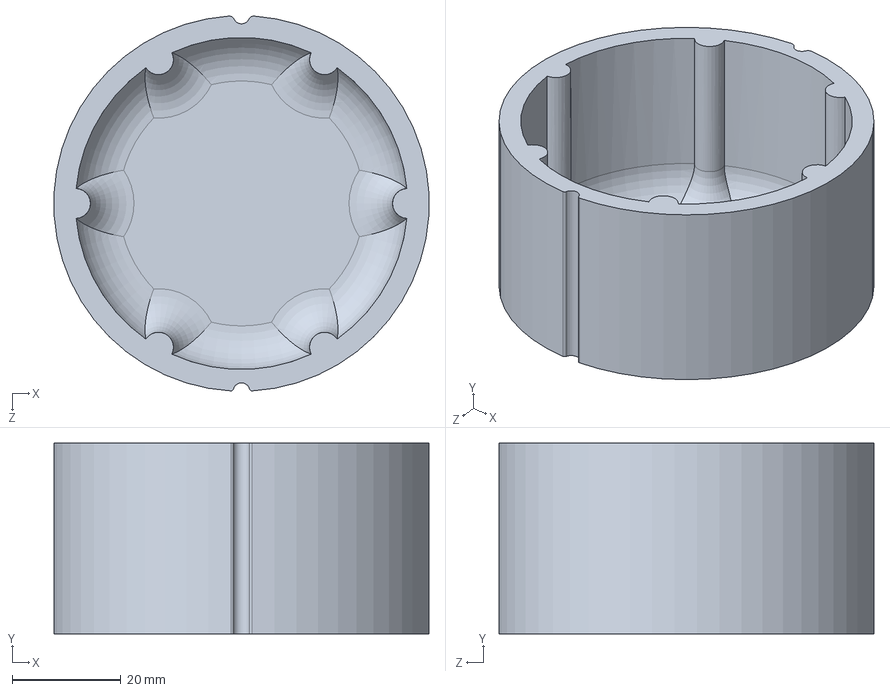
[picture p175: CAD file, 2022-12-04]
Hardware/Inserts/Solidworks_Designs/JOROTOX261mm.SLDPRT
68.9 x 35.0 x 68.9 mm
