alexquilty/SmartSpin2k/Hardware/Inserts/Echelon_60mm.STL

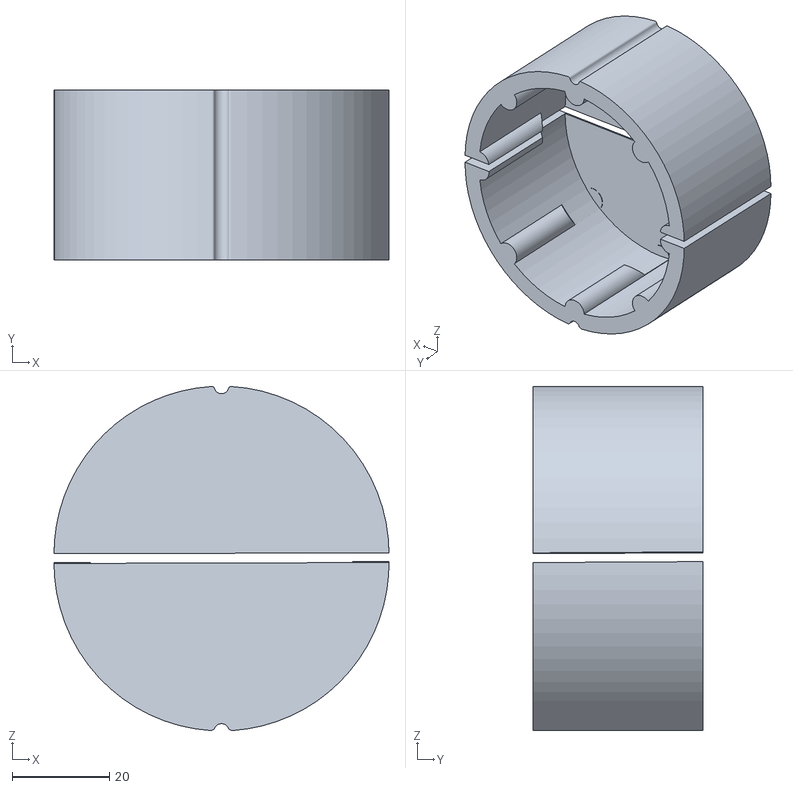
[picture p176: CAD file, 2022-12-04]
Hardware/Inserts/Echelon_60mm.STL
69.0 x 35.0 x 70.9
