alexquilty/SmartSpin2k/(list of files, cad)

Other CAD files:
Hardware/Case Integrated PCB/Case/CAD/Connectors/54-00063_ASM.SLDASM
Hardware/MODS/Case V2 - Ultra Short Mod/Case/CAD/Connectors/54-00063_ASM.SLDASM
Hardware/Case Version2/Gears/CAD/40_Tooth_Mod1.SLDASM
Hardware/Case Version2/Case/CAD/Connectors/54-00063_ASM.SLDASM
Hardware/Case Version2/Case/CAD/Connectors/54-00063-8.SLDPRT
Hardware/Case Version2/MountingStrap/CAD/Mounting_Strap.SLDPRT
Hardware/MODS/Case V2 - Ultra Short Mod/Case/CAD/Connectors/54-00063-6.SLDPRT
Hardware/MODS/Direct Mount Mod/Case/Direct Mount Mod v6.step
Hardware/MODS/Soldering Jig/Soldering Jig.stl
Hardware/Case Integrated PCB/Case/Body_Right.STL
Hardware/Case Integrated PCB/Case/CAD/Connectors/54-00063_Nickel Plating.SLDPRT
Hardware/Case Integrated PCB/MountingStrap/CAD/Mounting_Strap.SLDPRT
Hardware/Case Version2/Case/Body_Right.STL
Hardware/Case Version2/Case/CAD/Body_Drawing_Left.SLDPRT
Hardware/Case Version2/Case/CAD/Connectors/54-00063-4.SLDPRT
Hardware/Case Version2/Gears/CAD/Gear_Shaft.SLDPRT
Hardware/MODS/Case V2 - Ultra Short Mod/Case/CAD/Connectors/54-00063_Nickel Plating.SLDPRT
Hardware/MODS/Direct Mount Mod/Arm/CAD/Schwinn IC4.step
Hardware/Case Integrated PCB/Case/CAD/Body_Drawing_Left.SLDPRT
Hardware/Case Version2/Case/CAD/Connectors/54-00063_Nickel Plating.SLDPRT
Hardware/Inserts/Revmaster_Spin.STL
Hardware/Inserts/Solidworks_Designs/HMC_For_Large_Cup.SLDPRT
Hardware/MODS/Case V2 - Ultra Short Mod/Case/CAD/Connectors/54-00063-1.SLDPRT
Hardware/MODS/Direct Mount Mod/Bike Mount/IC4 Mount.stl
Hardware/Case Integrated PCB/Case/CAD/Body_Drawing.SLDPRT
Hardware/Case Integrated PCB/Case/CAD/Connectors/54-00063-5.SLDPRT
Hardware/Case Integrated PCB/Gears/CAD/Spur gear 1M 40T Hex.SLDPRT
Hardware/Case Version2/Case/CAD/Connectors/mid plastic(2).SLDPRT
Hardware/Inserts/Peloton_62.5mm.stl
Hardware/Case Version2/Gears/CAD/Spur gear 1M 40T Hex.SLDPRT
Hardware/Inserts/60mm.STL
Hardware/MODS/Case V2 - Ultra Short Mod/Case/CAD/Connectors/54-00063-5.SLDPRT
Hardware/Case Integrated PCB/Case/CAD/Connectors/front metal(2).SLDPRT
Hardware/Case Integrated PCB/Gears/CAD/Spur gear 1M 11T.SLDPRT
Hardware/Inserts/Solidworks_Designs/Peloton_7_flat.SLDPRT
Hardware/MODS/Case V2 - Ultra Short Mod/Case/CAD/Connectors/mid plastic(2).SLDPRT
Hardware/Case Version2/Case/CAD/Connectors/54-00063-3.SLDPRT
Hardware/Inserts/Schwinn_IC4_48.5mm.STL
Hardware/Inserts/Solidworks_Designs/FLYWHEEL_55mm.SLDPRT
Hardware/MODS/Case V2 - Ultra Short Mod/Case/CAD/Connectors/front metal(2).SLDPRT
Hardware/Case Integrated PCB/Case/CAD/Connectors/mid plastic(2).SLDPRT
Hardware/Inserts/JLL IC400 Elite_58mm.STL
Hardware/Inserts/Solidworks_Designs/Golds_Gym_300_Hard_41mm.SLDPRT
Hardware/Case Version2/Case/CAD/Connectors/54-00063-6.SLDPRT
Hardware/Inserts/HMC_For_Large_Cup.STL
Hardware/Inserts/Solidworks_Designs/FLYWHEEL_54.5mm.SLDPRT
Hardware/Case Integrated PCB/Case/CAD/Connectors/54-00063-3.SLDPRT
Hardware/Case Version2/Case/CAD/Connectors/54-00063-5.SLDPRT
Hardware/Inserts/Solidworks_Designs/Body_Bike.SLDPRT
Hardware/Case Integrated PCB/Case/CAD/Connectors/54-00063-8.SLDPRT
Hardware/Case Version2/Case/CAD/Connectors/pin(2).SLDPRT
Hardware/Inserts/JOROTOX2_60mm.STL
Hardware/Inserts/Solidworks_Designs/60mm_Large_Cup.SLDPRT
Hardware/Case Integrated PCB/Case/CAD/Connectors/54-00063-1.SLDPRT
Hardware/Inserts/FLYWHEEL_55mm.STL
Hardware/MODS/Case V2 - Ultra Short Mod/Case/CAD/Connectors/54-00063-3.SLDPRT
Hardware/Case Integrated PCB/Case/CAD/Connectors/pin(2).SLDPRT
Hardware/Case Version2/Case/CAD/Connectors/54-00063-1.SLDPRT
Hardware/Inserts/Proform_49.5mm.STL
Hardware/Inserts/Solidworks_Designs/JOROTOX260mm.SLDPRT
Hardware/MODS/Case V2 - Ultra Short Mod/Case/CAD/Connectors/pin(2).SLDPRT
Hardware/Case Integrated PCB/Case/CAD/Connectors/54-00063-4.SLDPRT
Hardware/Inserts/Diadora_59mm.3MF
Hardware/MODS/Case V2 - Ultra Short Mod/Case/CAD/Connectors/54-00063-8.SLDPRT
Hardware/Case Integrated PCB/Case/CAD/Connectors/54-00063-6.SLDPRT
Hardware/Case Version2/Case/CAD/Connectors/front metal(2).SLDPRT
Hardware/Inserts/65mm.STL
Hardware/Inserts/Solidworks_Designs/Vortec_Team_Bigger_62mm.SLDPRT
Hardware/MODS/Case V2 - Ultra Short Mod/Case/CAD/Connectors/54-00063-4.SLDPRT
Hardware/Inserts/JLL IC400 Elite_56mm.STL
Hardware/Inserts/Solidworks_Designs/JLL IC400 Elite_58mm.SLDPRT
Hardware/Inserts/Body_Power_45mm.STL
Hardware/Inserts/Solidworks_Designs/Revmaster_Spin.SLDPRT
Hardware/Inserts/Solidworks_Designs/Echelon_60mm.SLDPRT
Hardware/Inserts/Solidworks_Designs/JLL IC400 Elite_56mm.SLDPRT
Hardware/Inserts/Vortec_Team_regular_60mm.STL
Hardware/Inserts/Body_Bike.STL
Hardware/Inserts/Solidworks_Designs/Diadora_59mm.STEP
Hardware/Inserts/FLYWHEEL_54.5mm.STL
Hardware/Inserts/Solidworks_Designs/65mm_Large_Cup.SLDPRT
Hardware/Inserts/JOROTOX2_61mm.STL
Hardware/Inserts/Solidworks_Designs/Golds_Gym_300_TPU.SLDPRT
Hardware/Inserts/Golds_Gym_300_Hard_41mm.STL
Hardware/Archive/Case Version1/Cases/Bottom_Case.stl
Hardware/Archive/Case Version1/Cases/Bottom_Case_PCB.stl
Hardware/Archive/Case Version1/Covers/Tall_Cover.stl
Hardware/Archive/Case Version1/Covers/Tall_Cover_w_brace.stl
Hardware/Archive/Case Version1/F3D Files/Case_Revision 1 v14.f3d
Hardware/Archive/Case Version1/Gears/CAD/Spur gear 1M 11T.SLDPRT
Hardware/Archive/Case Version1/Gears/CAD/Spur gear 1M 30T.SLDPRT
Hardware/Archive/Case Version1/Gears/CAD/Spur gear 1M 31T.SLDPRT
Hardware/Archive/Case Version1/Gears/Spur gear 1M 11T.STL
Hardware/Archive/Case Version1/Gears/Spur gear 1M 30T.STL
Hardware/Archive/Case Version1/Gears/Spur gear 1M 31T.STL
Hardware/Archive/Case Version1/Mounts/BakerEchelonStrap.stl
Hardware/Archive/Case Version1/Mounts/CAD/Flywheel_Brand_Mounting_Strap.SLDPRT
Hardware/Archive/Case Version1/Mounts/CAD/LoganRetentionClip.SLDPRT
Hardware/Archive/Case Version1/Mounts/CAD/Mounting_StrapV2.SLDPRT
Hardware/Archive/Case Version1/Mounts/CAD/Mounting_StrapV2_XL.SLDPRT
Hardware/Archive/Case Version1/Mounts/CAD/Mounting_Strap_Rigid.SLDPRT
Hardware/Archive/Case Version1/Mounts/CAD/PositiveRetentionClip.SLDPRT
Hardware/Archive/Case Version1/Mounts/Flywheel_Brand_Mounting_Strap.STL
Hardware/Archive/Case Version1/Mounts/LoganRetentionClip.STL
Hardware/Archive/Case Version1/Mounts/Mounting_StrapV2.STL
Hardware/Archive/Case Version1/Mounts/Mounting_StrapV2_XL.STL
Hardware/Archive/Case Version1/Mounts/Mounting_Strap_Rigid.STL
Hardware/Archive/Case Version1/Mounts/PositiveRetentionClip.STL
Hardware/Archive/Case Version1/Mounts/PositiveRetentionClip_30mm.STL
Hardware/Archive/Case Version1/StepperCrossbars/Stepper Crossbar.stl
Hardware/Archive/Inserts for V1 Cup/BH SB3 spinbike +Insert v3.f3d
Hardware/Archive/Inserts for V1 Cup/BH SB3 spinbike Insert v2.stl
Hardware/Archive/Inserts for V1 Cup/BH SB3 spinbike Insert v3.stl
Hardware/Archive/Inserts for V1 Cup/HMC_Insert.stl
Hardware/Archive/Inserts for V1 Cup/ProForm_Insert.stl
Hardware/Archive/Inserts for V1 Cup/Revmaster-Spin_Adaptor.stl
Hardware/Archive/Inserts for V1 Cup/Schwinn_Insert.stl
Hardware/Archive/Inserts for V1 Cup/insert1.stl
Hardware/Archive/Inserts for V1 Cup/insert2.stl
Hardware/Archive/Inserts for V1 Cup/insert3.stl
Hardware/Archive/Knob_Cup_V2.STL
Hardware/Archive/Shifters/CAD/Shifter_Cover v6.f3d
Hardware/Archive/Shifters/CAD/Shifter_Cover v9.f3d
Hardware/Archive/Shifters/Shifter_Cover v9.stl
Hardware/Case Integrated PCB/Case/CAD/Connectors/DC_PWR_CONN.SLDASM
Hardware/Case Integrated PCB/Case/CAD/Connectors/N8_Flat Head Screws.SLDPRT
Hardware/Case Integrated PCB/Case/CAD/Connectors/nut________(2).SLDPRT
Hardware/Case Integrated PCB/Case/Window.STL
Hardware/Case Integrated PCB/Gears/CAD/SS2K 40T Mod1 Spur Gear.SLDPRT
Hardware/Case Integrated PCB/Gears/Spur gear 1M 11T.STL
Hardware/Case Integrated PCB/Gears/Spur gear 1M 40T Hex.STL
Hardware/Case Integrated PCB/MountingStrap/CAD/Mounting_Strap_Short.SLDPRT
Hardware/Case Integrated PCB/MountingStrap/Mounting_Strap_Short.STL
Hardware/Case Version2/Case/CAD/Connectors/DC_PWR_CONN.SLDASM
Hardware/Case Version2/Case/CAD/Connectors/N8_Flat Head Screws.SLDPRT
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
