alexquilty/SmartSpin2k/Hardware/Case Version2/Axel_Assembly.gif

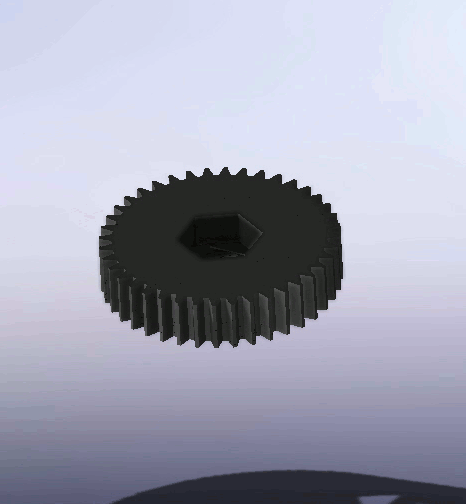
Hardware/Case Version2/Axel_Assembly.gif
