alexquilty/SmartSpin2k/Hardware/Case Version2/Case_Assembly.gif

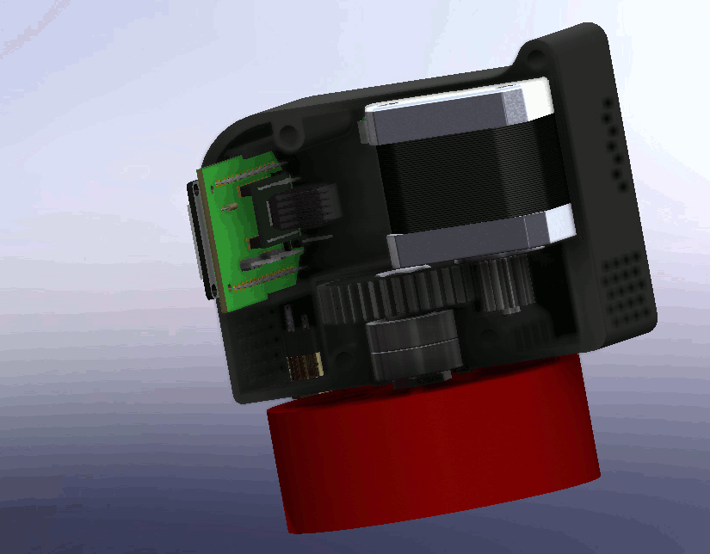
Hardware/Case Version2/Case_Assembly.gif
