alexquilty/SmartSpin2k/(list of files, drawings)

Other design files:
Hardware/Integrated PCB/SS2K_KiCad_Files/SmartSpin2k.dsn
