alexquilty/SmartSpin2k/Hardware/Integrated PCB/SS2K_KiCad_Files/SmartSpin2k.kicad_pcb

## KiCad design Hardware/Integrated PCB/SS2K_KiCad_Files/SmartSpin2k.kicad_pcb (2022-12-04)

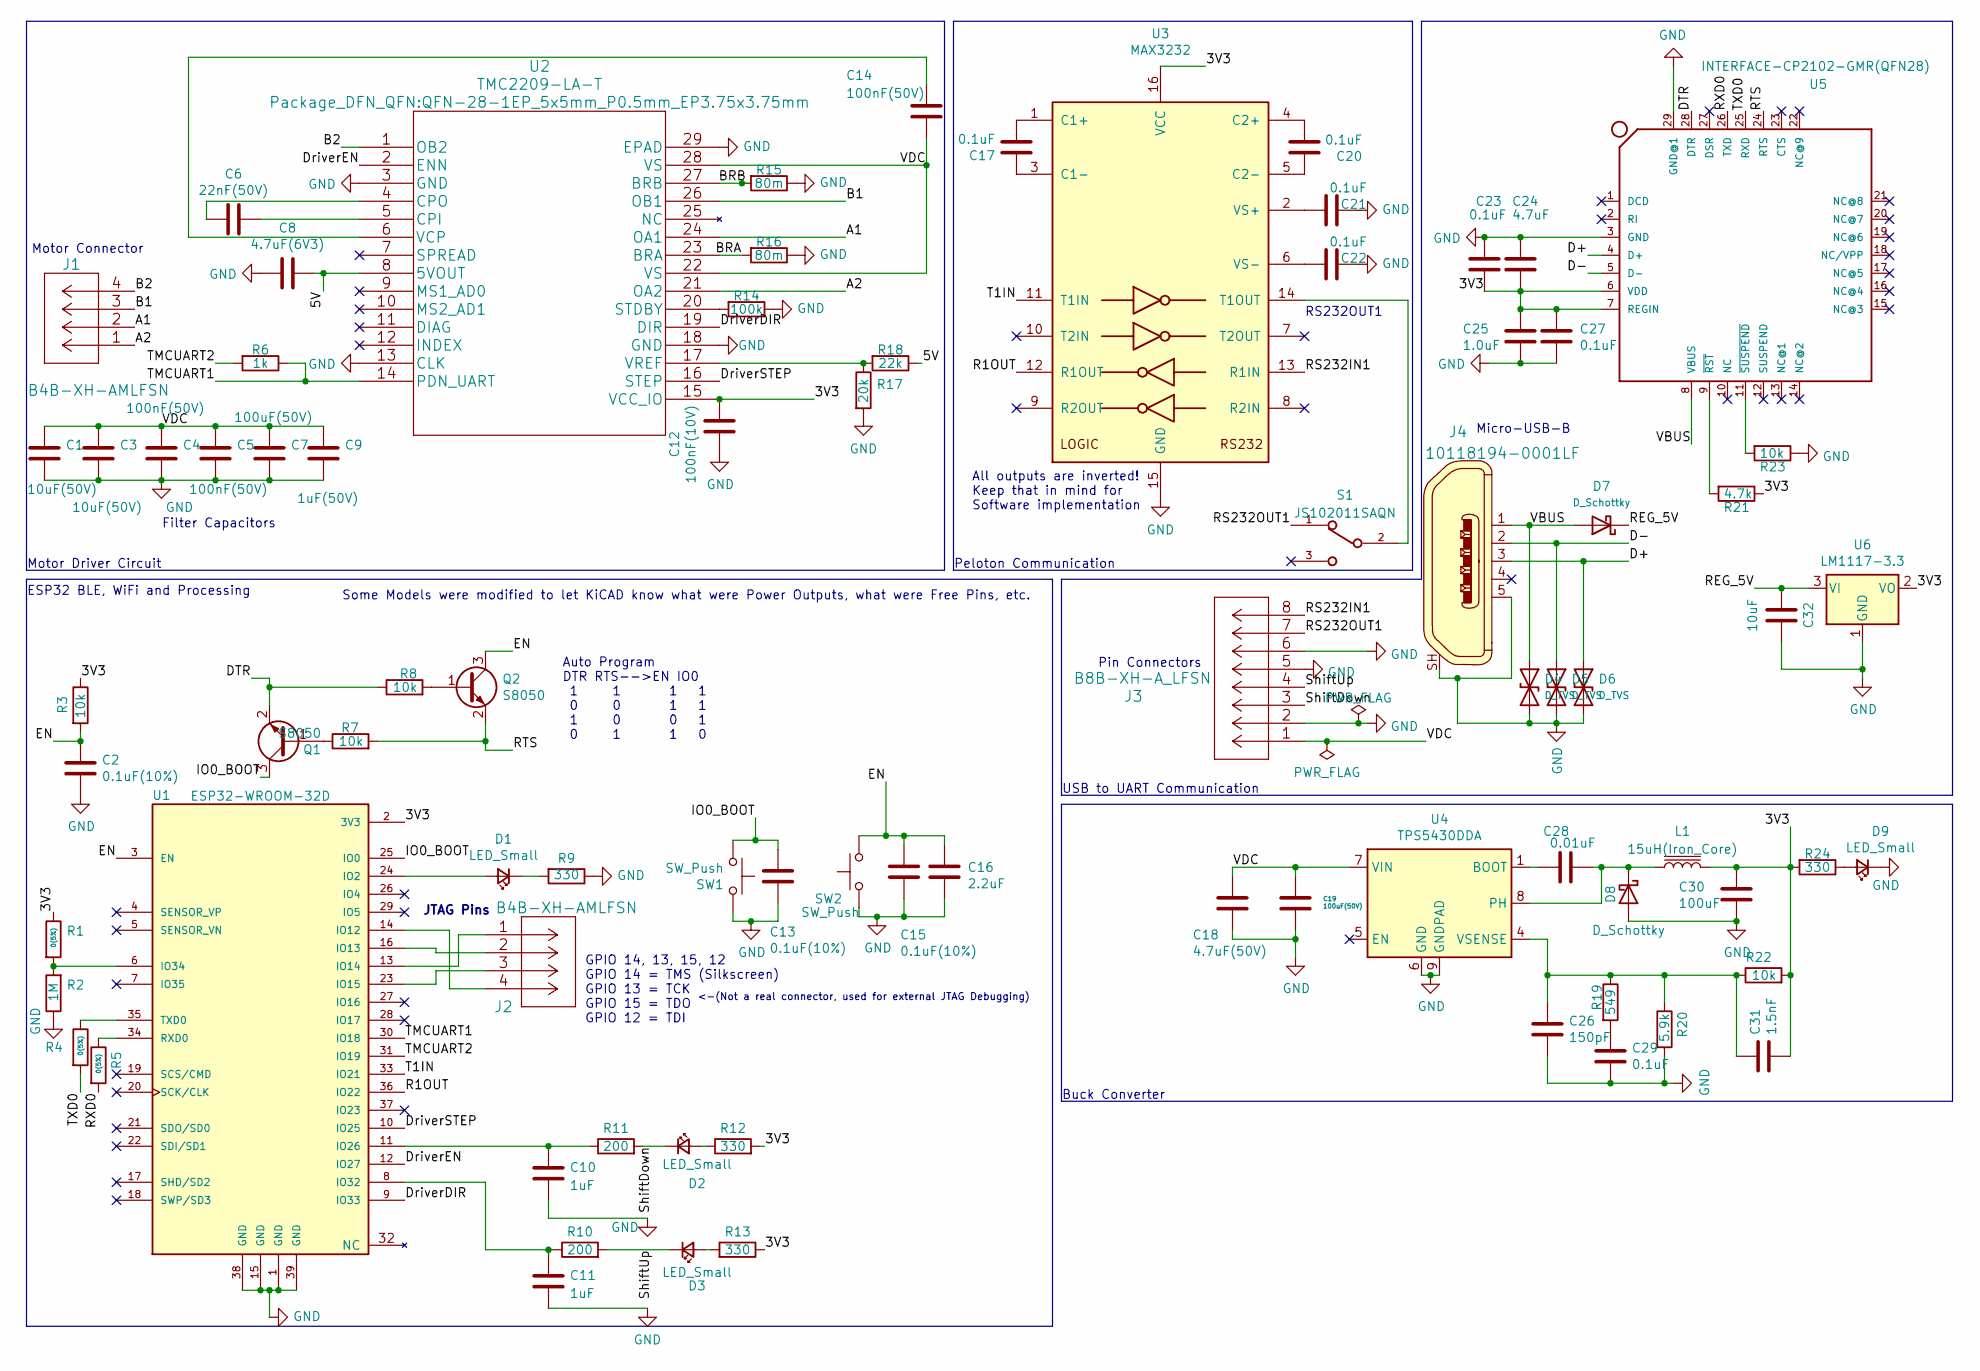
[picture p182: schematic SmartSpin2k.kicad_sch]

Parts:
C1: 10uF(50V); C_0805_2012Metric
C2, C13, C15: 0.1uF(10%); C_0402_1005Metric
C3: 10uF(50V); C_1206_3216Metric
C4, C5, C14: 100nF(50V); C_0805_2012Metric
C6: 22nF(50V); C_0805_2012Metric
C7, C19: 100uF(50V); CP_Elec_8x10
C8: 4.7uF(6V3); C_0805_2012Metric
C9: 1uF(50V); C_0603_1608Metric
C10, C11: 1uF; C_0603_1608Metric
C12: 100nF(10V); C_0805_2012Metric
C16: 2.2uF; C_0402_1005Metric
C17, C20, C21, C22, C23, C27, C29: 0.1uF; C_0402_1005Metric
C18: 4.7uF(50V); C_1206_3216Metric
C24: 4.7uF; C_0805_2012Metric
C25: 1.0uF; C_0805_2012Metric
C26: 150pF; C_0805_2012Metric
C28: 0.01uF; C_0805_2012Metric
C30: 100uF; C_1206_3216Metric
C31: 1.5nF; C_0805_2012Metric
C32: 10uF; C_0603_1608Metric
D1, D2, D3, D9: LED_Small; LED_0603_1608Metric
D4, D5, D6: D_TVS; D_0603_1608Metric
D7, D8: D_Schottky; D_SMA
J1, J2: B4B-XH-AMLFSN; JST_XH_B4B-XH-AM_1x04_P2.50mm_Vertical
J3: B8B-XH-A_LFSN; JST_XH_B8B-XH-AM_1x08_P2.50mm_Vertical
J4: 10118194-0001LF; USB_Micro_B_Female_10118194-0001LF; MPN 10118194-0001LF; Digi-Key_PN 609-4618-1-ND
L1: 15uH(Iron_Core); L_SXN_SMDRI127_150MT
Q1, Q2: S8050; SOT-23
R1, R4, R5: 0(5%); R_0402_1005Metric
R2: 1M; R_0402_1005Metric
R3, R7, R8, R22, R23: 10k; R_0402_1005Metric
R6: 1k; R_0402_1005Metric
R9, R12, R13, R24: 330; R_0402_1005Metric
R10, R11: 200; R_0402_1005Metric
R14: 100k; R_0402_1005Metric
R15, R16: 80m; R_1206_3216Metric
R17: 20k; R_0805_2012Metric
R18: 22k; R_0402_1005Metric
R19: 549; R_0402_1005Metric
R20: 5.9k; R_0603_1608Metric
R21: 4.7k; R_0402_1005Metric
S1: JS102011SAQN; SW_JS102011SAQN
SW1, SW2: SW_Push; SW_Push_SPST_NO_Alps_SKRK
U1: ESP32-WROOM-32D; ESP32-WROOM-32; PARTREV 1.9
U2: TMC2209-LA-T; QFN-28-1EP_5x5mm_P0.5mm_EP3.75x3.75mm
U3: MAX3232; MAX3232IPWR
U4: TPS5430DDA; SOIC-8-1EP_3.9x4.9mm_P1.27mm_EP2.514x3.2mm
U5: INTERFACE-CP2102-GMR(QFN28); QFN-28-1EP_5x5mm_P0.5mm_EP3.35x3.35mm; MPN CP2102-GMR
U6: LM1117-3.3; SOT-223-3_TabPin2

Connections:
/3V3: C12.1, C23.1, C24.2, C25.1, C27.1, C30.1, C31.2, L1.2, R1.1, R3.1, R12.2, R13.1, R21.1, R22.2, R24.2, U1.2 (3V3), U2.15 (VCC_IO), U3.16 (VCC), U5.6 (VDD), U5.7 (REGIN), U6.2 (VO)
/5V: C8.1, R18.1, U2.8 (5VOUT)
/A1: J1.2, U2.24 (OA1)
/A2: J1.1, U2.21 (OA2)
/B1: J1.3, U2.26 (OB1)
/B2: J1.4, U2.1 (OB2)
/BRA: R16.2, U2.23 (BRA)
/BRB: R15.2, U2.27 (BRB)
/D+: D6.1 (A1), J4.3, U5.4 (D+)
/D-: D5.1 (A1), J4.2, U5.5 (D-)
/DTR: Q1.2 (E), R8.1, U5.28 (DTR)
/DriverDIR: U1.9 (IO33), U2.19 (DIR)
/DriverEN: U1.12 (IO27), U2.2 (ENN)
/DriverSTEP: U1.10 (IO25), U2.16 (STEP)
/EN: C2.1, C15.1, C16.1, Q2.3 (C), R3.2, SW2.2, U1.3 (EN)
/IO0_BOOT: C13.1, Q1.3 (C), SW1.1, U1.25 (IO0)
/R1OUT: U1.36 (IO22), U3.12 (R1OUT)
/REG_5V: C32.2, D7.1 (K), U6.3 (VI)
/RS232IN1: J3.8, U3.13 (R1IN)
/RS232OUT1: J3.7, S1.1
/RTS: Q2.2 (E), R7.2, U5.24 (RTS)
/RXD0: R5.2, U5.26 (TXD)
/ShiftDown: D2.1 (K), J3.3, R11.2
/ShiftUp: D3.1 (K), J3.4, R10.2
/T1IN: U1.33 (IO21), U3.11 (T1IN)
/TMCUART1: R6.1, U1.30 (IO18), U2.14 (PDN_UART)
/TMCUART2: R6.2, U1.31 (IO19)
/TXD0: R4.2, U5.25 (RXD)
/VBUS: D4.1 (A1), D7.2 (A), J4.1, U5.8 (VBUS)
/VDC: C1.1, C3.1, C4.1, C5.1, C7.1, C9.1, C14.1, C18.1, C19.1, J3.1, U2.22 (VS), U2.28 (VS), U4.7 (VIN)
GND: C1.2, C2.2, C3.2, C4.2, C5.2, C7.2, C8.2, C9.2, C10.2, C11.2, C12.2, C13.2, C15.2, C16.2, C18.2, C19.2, C21.2, C22.2, C23.2, C24.1, C25.2, C26.2, C27.2, C29.2, C30.2, C32.1, D4.2 (A2), D5.2 (A2), D6.2 (A2), D8.2 (A), D9.1 (K), J3.2, J3.5, J3.6, J4.5, J4.SH, R2.1, R9.1, R14.1, R15.1, R16.1, R17.2, R20.2, R23.1, SW1.2, SW2.1, U1.1 (GND), U1.15 (GND), U1.38 (GND), U1.39 (GND), U2.3 (GND), U2.13 (CLK), U2.18 (GND), U2.29 (EPAD), U3.15 (GND), U4.6 (GND), U4.9 (GNDPAD), U5.3 (GND), U5.29 (GND@1), U6.1 (GND)
unnamed: C6.1, U2.5 (CPI)
unnamed: C6.2, U2.4 (CPO)
unnamed: C10.1, R11.1, U1.11 (IO26)
unnamed: C11.1, R10.1, U1.8 (IO32)
unnamed: C14.2, U2.6 (VCP)
unnamed: C17.1, U3.3 (C1-)
unnamed: C17.2, U3.1 (C1+)
unnamed: C20.1, U3.5 (C2-)
unnamed: C20.2, U3.4 (C2+)
unnamed: C21.1, U3.2 (VS+)
unnamed: C22.1, U3.6 (VS-)
unnamed: C26.1, C31.1, R19.1, R20.1, R22.1, U4.4 (VSENSE)
unnamed: C28.1, U4.1 (BOOT)
unnamed: C28.2, D8.1 (K), L1.1, U4.8 (PH)
unnamed: C29.1, R19.2
unnamed: D1.1 (K), R9.2
unnamed: D1.2 (A), U1.24 (IO2)
unnamed: D2.2 (A), R12.1
unnamed: D3.2 (A), R13.2
unnamed: D9.2 (A), R24.1
unnamed: J2.1, U1.13 (IO14)
unnamed: J2.2, U1.16 (IO13)
unnamed: J2.3, U1.23 (IO15)
unnamed: J2.4, U1.14 (IO12)
unnamed: Q1.1 (B), R7.1
unnamed: Q2.1 (B), R8.2
unnamed: R1.2, R2.2, U1.6 (IO34)
unnamed: R4.1, U1.35 (TXD0)
unnamed: R5.1, U1.34 (RXD0)
unnamed: R14.2, U2.20 (STDBY)
unnamed: R17.1, R18.2, U2.17 (VREF)
unnamed: R21.2, U5.9 (~RST)
unnamed: R23.2, U5.11 (~SUSPEND)
unnamed: S1.2, U3.14 (T1OUT)

Notes on the sheet:
Peloton Communication
JTAG Pins
Motor Connector
Buck Converter
ESP32 BLE, WiFi and Processing
RS232OUT1
USB to UART Communication
Pin Connectors
All outputs are inverted! Keep that in mind for Software implementation
<-(Not a real connector, used for external JTAG Debugging)
Some Models were modified to let KiCAD know what were Power Outputs, what were Free Pins, etc.
Auto Program DTR RTS-->EN IO0 1 1 1 1 0 0 1 1 1 0 0 1 0 1 1 0
GPIO 14, 13, 15, 12 GPIO 14 = TMS (Silkscreen) GPIO 13 = TCK GPIO 15 = TDO GPIO 12 = TDI
Motor Driver Circuit
Filter Capacitors
Micro-USB-B

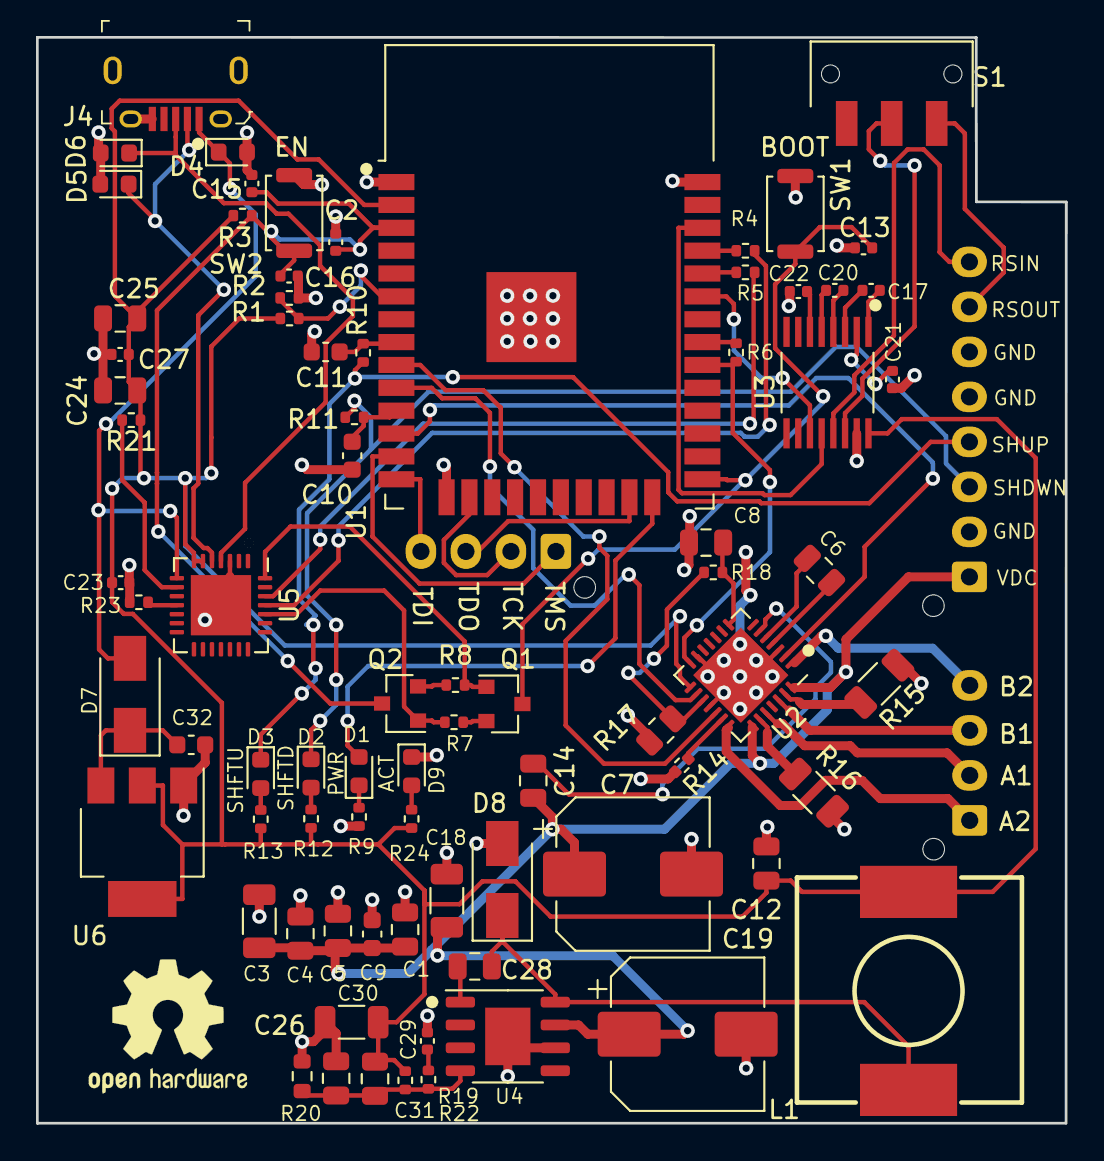
[picture p183: board SmartSpin2k.kicad_pcb from above]

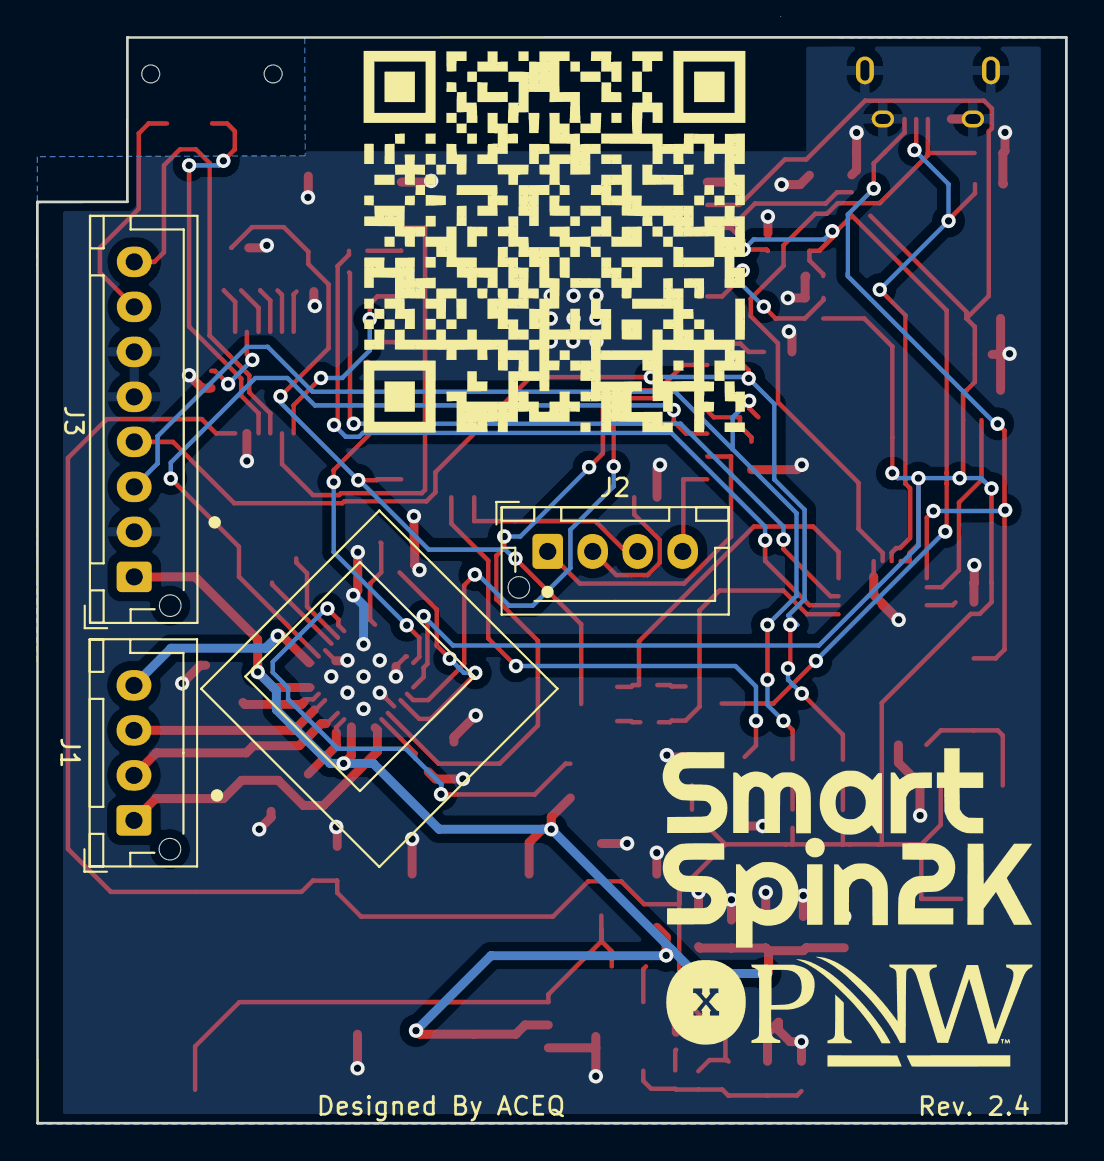
[picture p184: board SmartSpin2k.kicad_pcb from below]

Board: 2 copper layers, 57.2 x 60.3 mm, 81 parts (3 on the bottom side), 65 nets.
