alexquilty/SmartSpin2k/Hardware/PCB/Universal_Board_Side_Mount.brd

## EAGLE design Hardware/PCB/Universal_Board_Side_Mount.brd (2022-12-04)

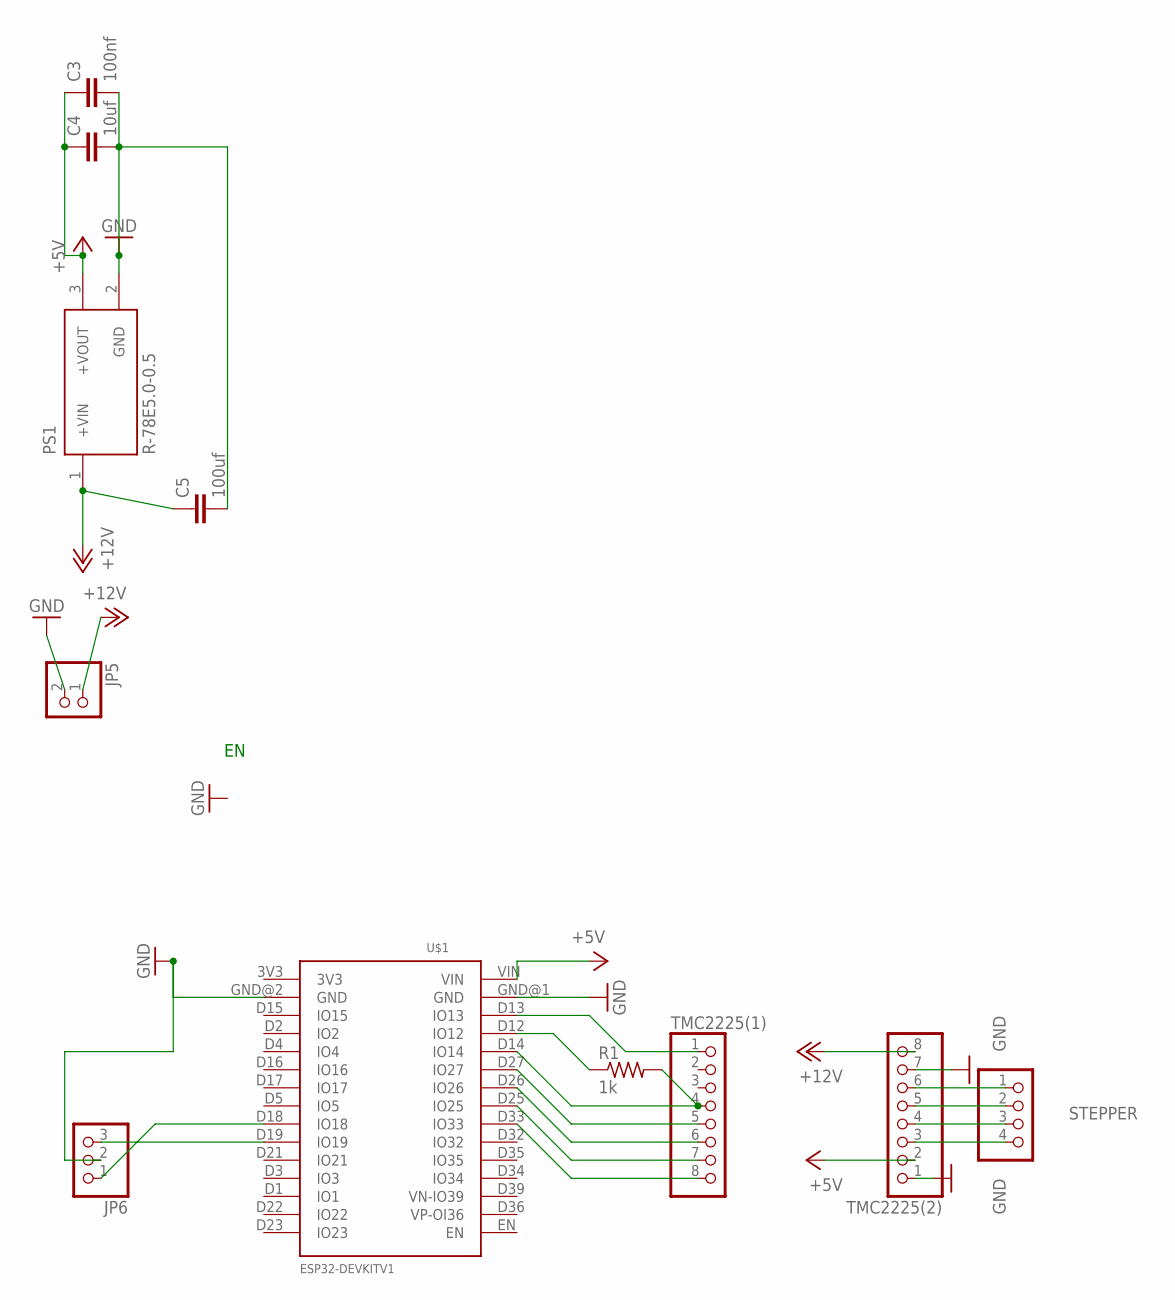
[picture p185: schematic Universal_Board_Side_Mount.sch]

Parts:
C3: 100nf; C2.5-3
C4: 10uf; C2.5-3
C5: 100uf; C2.5-3
JP5: PINHD-1X2; 1X02
JP6: PINHD-1X3; 1X03
PS1: R-78E5.0-0.5; CONV_R-78E5.0-0.5
R1: 1k; 0204/7
STEPPER: PINHD-1X4; 1X04
TMC2225(1), TMC2225(2): PINHD-1X8; 1X08
U$1: ESP32DEVKITV1; ESP32-DEVKITV1

Connections:
+5V: C3.1, C4.1, PS1.3 (+VOUT), TMC2225(2).2, U$1.VIN
+12V: C5.1, JP5.1, PS1.1 (+VIN), TMC2225(2).8
GND: C3.2, C4.2, C5.2, JP5.2, JP6.2, PS1.2 (GND), TMC2225(2).1, TMC2225(2).7, U$1.GND@1 (GND), U$1.GND@2 (GND)
unnamed: R1.2, TMC2225(1).4, U$1.D14 (IO14)
unnamed: TMC2225(1).1, U$1.D13 (IO13)
unnamed: R1.1, U$1.D12 (IO12)
unnamed: TMC2225(1).5, U$1.D27 (IO27)
unnamed: TMC2225(1).6, U$1.D26 (IO26)
unnamed: TMC2225(1).7, U$1.D25 (IO25)
unnamed: TMC2225(1).8, U$1.D33 (IO33)
unnamed: STEPPER.1, TMC2225(2).6
unnamed: STEPPER.2, TMC2225(2).5
unnamed: STEPPER.3, TMC2225(2).4
unnamed: STEPPER.4, TMC2225(2).3
unnamed: JP6.3, U$1.D19 (IO19)
unnamed: JP6.1, U$1.D18 (IO18)

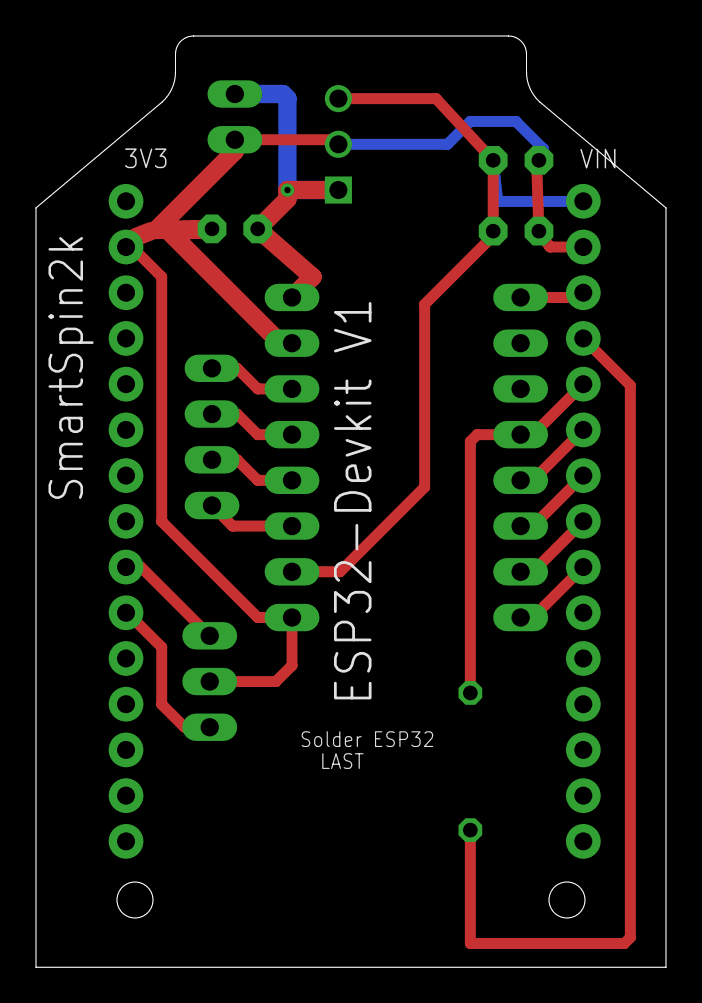
[picture p186: board Universal_Board_Side_Mount.brd from above]

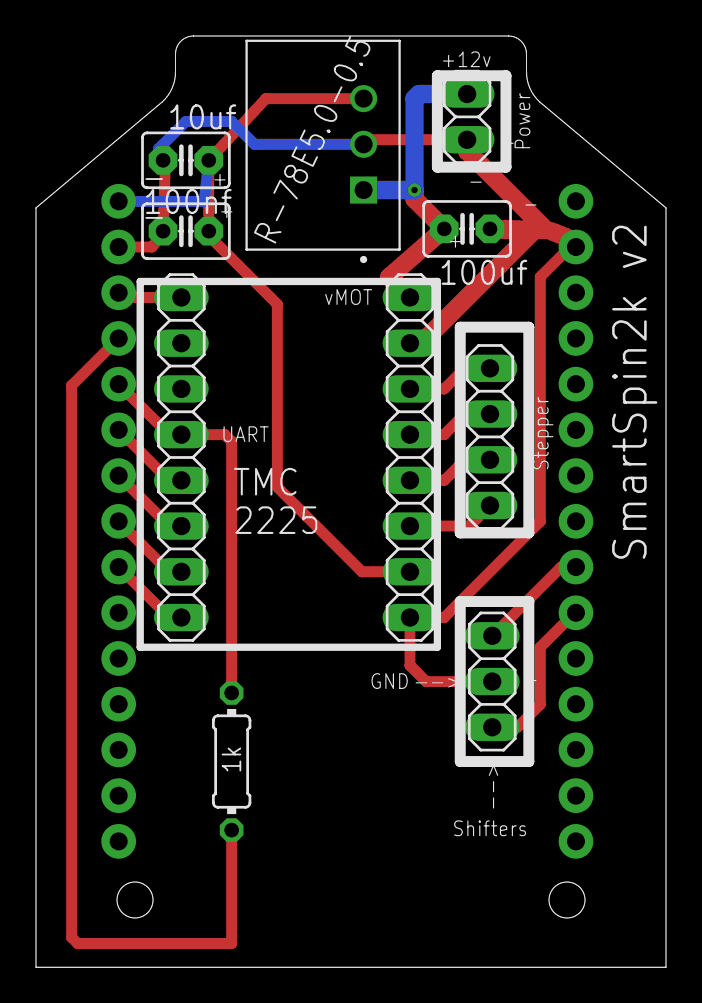
[picture p187: board Universal_Board_Side_Mount.brd from below]

Board: 2 copper layers, 35.0 x 51.7 mm, 11 parts (10 on the bottom side), 16 nets.
