alexquilty/SmartSpin2k/(commit log)

2022-10-20 Power Buffer Troubleshooting
    Added PowerBuffer to toLog().
2022-12-04 New Board Changes to Switch and Edges
    [3.5mmJack.SLDASM, 40_Tooth_Mod1.SLDASM, 50mm.SLDPRT, 50mm.STL, 54-00063-1.SLDPRT, 54-00063-3.SLDPRT, 54-00063-4.SLDPRT, 54-00063-5.SLDPRT]
